Chrisyyyys/Robocup-Junoir-Theseus/README.md

# Robocup-Junoir-Theseus
Robocup junoir 2025
chacandnnaf
