Chrisyyyys/Robocup-Junoir-Theseus/docs/superpowers/specs/v3-checks/README.md

# V3 geometry and statics checks

These scripts produce every **[check]** number in [2026-10-06-theseus-v3-robot-design.md](../2026-10-06-theseus-v3-robot-design.md) and [2026-10-07-theseus-v3-mechanical-design.md](../2026-10-07-theseus-v3-mechanical-design.md) and draw the figures in [../v3-figures/](../v3-figures/). They are a model, not the robot: nothing here was measured on hardware, and all masses are placeholders.

```
pip install shapely numpy matplotlib
python run_all.py            # every check, raw output in results/*.txt (about 10 minutes)
python run_all.py terrain    # one check (names below)
python figures.py ../v3-figures
```

Run from this folder (the scripts read and write `pack_v3.json` here). Units are cm and degrees; x forward, y left, z up, origin at the axle midpoint on the floor line.

## What each check answers

| Check (`run_all.py` name) | Script | Spec section | Result it supports |
|---|---|---|---|
| `terrain` | `nubtable.py`, `sidesim2.py`, `sidesim.py` | 4 | Side-view crossing of a 2 cm riser, two 1 cm steps, 25 degree ramp, bumps, seam, three-step stairs and the Dangerous Zone bump on a ramp; nub-height table; the first-draft and belly-only variants |
| `omni_travel` | `more_checks.py travel` | 4 | Omni travel 2.5 versus 3.0 cm changes nothing for the required cases |
| `silver_module`, `front_floor_port` | `more_checks.py axle`, `fsens.py` | 5 | Clearance of the two floor-sensor positions on every terrain case |
| `ramp_foot` | `tofcone.py` | 5 | What a front ToF reads at the foot of a 25 degree ramp at heights 6.5, 8.1, 10.0 (first lines also trace the old layout) |
| `plate_variants`, `plate_tolerance` | `variants.py`, `platesim.py`, `platesim2.py`, `platetol.py` | 7 | All 128 drop sequences (0 violations), wall and parked margin for each pocket size and ring radius, positioning tolerance; `plate_tolerance` is run for the rev 4 numbers (13 mm pockets, 17 mm slot, 9 Oct: parked margin 1.92 mm, wall 4.06 mm, 128 cases with 0 violations; 8 Oct, 14 mm and 16 mm: 1.74 mm). The kit's own width limits the parking error to (slot - pocket) / 2 = 2.0 mm, and the simulation gives 1.5 mm: `chute_dynamics` |
| `kit_landing` | `kit_final.py` | 7 | Chute slope, exit speed, landing point, kit-to-victim distance |
| `bumper_and_chute_exit` | `geom_checks.py` | 6, 7 | Bumper end angle against the other parts and the corridor wall; chute exit x against the wheel |
| `packing` | `final_pack2.py`, `com.py`, `layout.py`, `place2.py`, `chamfer_pack.py` | 9 | Controller stack and battery placement against all fixed parts, the cameras and the rear chamfer; centre of mass |
| `tof_cones` | `tof_check2.py` | 5 | All nine 25 degree cones traced against the robot's own parts |
| `controller_fit`, `controller_fit_with_battery` (slow, run only when named) | `fit_stack_only.py`, `fit_R.py` | 0.2, 0.5 (D1), 9 | Which controller stack heights fit at R 9.5, 10.0, 10.5 with the wheel track, motors, chute exit and camera re-fitted for each radius; what small main board plus battery fits at 9.5 |
| `camera_beside_wheel`, `camera_recess`, `camera_view` | `beside.py` + `place.py`, `cam_recess.py`, `camview.py` | 8 | No placement beside the wheel; the recessed lens fits; what the lens sees of the wall |
| `statics` | `statics.py` | 4 | Friction needed to climb a step, omni push, motor torque, ramp statics, spring rate (edit `x_com`, `h_com` to try other centres of mass) |
| `figures` | `figures.py`, `v3_params.py` | 14 | The six figures; every dimension in them comes from `v3_params.py` and the simulator |

### Mechanical design (2026-10-07)

These back the numbers in [2026-10-07-theseus-v3-mechanical-design.md](../2026-10-07-theseus-v3-mechanical-design.md) (the structure, mounting and usability review). Results are in `results/`.

| Check (`run_all.py` name) | Script | Spec section | Result it supports |
|---|---|---|---|
| `omni_inside` (slow, run only when named, about 3 minutes) | `omni_inside.py` (uses `sidesim2.py`, `nubtable.py`) | 4 | All nine required terrain cases with the omni centre at 7.95 (rev 3), 7.3, 7.0 and 6.5 cm and the chute lip at z 2.67; the Dangerous Zone extras at 7.0 and 7.95 |
| `statics_omni_7` | `statics.py 7.0` | 4 | Front load, omni push, torque and the spring requirement with the omni 7.0 cm ahead (`statics.py` takes the omni distance as an argument, default 7.95) |
| `chute_exit` | `chute_exit.py` | 6.2 | Lowest point of a round chute, of the first 13 mm square one and of the final 19 mm one (22.2 mm outside, centred 1.5 mm above the axis; 8 Oct: 18 mm, 21.2 outside, the same floor) where it leaves the R 10.5 wall, and the exit axis height that keeps each at z 3.0 (z 4.15 for the 13 mm one, 4.35 for the 19 mm one; the design keeps z 4.15 and accepts 2.77) |
| `kit_landing_square` | `kit_final.py 4.15` | 6.2 | Exit speed, landing point and kit-to-victim distance with the exit axis at z 4.15 (`kit_final.py` takes the exit axis height as an argument, default 3.75) |
| `chute_dynamics` (not in `run_all.py`: needs MuJoCo, `pip install mujoco`; about 15 s quick, about 5 minutes full) | `chute_dynamics.py [quick\|full] [noplate] [bore in cm]` (uses `chute_geometry.py`) | 6.2 | Rigid-body simulation of a 10.3 mm kit starting in its plate pocket (the pocket's four walls are in the model, 0.3 mm above the floor; plate parked exactly, parked off along the ring, or turning onto the slot) and falling through the 17 mm slot B, the hopper and the 19 mm channel to the exit, on the geometry of the Fusion model, for friction 0.15 to 0.60, every kit with its own random turn (up to +-18 degrees, what the 13 mm pocket allows) and place in the pocket. Controls: textbook acceleration on a 32.2 degree plane, hold at mu 0.7, an 18.5 mm cube must not pass the slot. Full mode: sweeps of 1000 kits (plate parked exactly, up to 1 mm, 2 mm and 3 mm off, bouncy impacts with damping 0.3) and tables of the parking offset, the clearance under the plate, the plate's approach speed and the tolerance corners (10.5 mm kit, bore printed 18.6 mm, 6 g kit). **Result 9 Oct, final design (13 / 17 / 19 mm): PASS for the plate parked within 1.5 mm: 100.0 % with the plate exact, up to 1 mm off and with bouncy impacts, 99.9 % up to 2.0 mm (the allowance), 87.9 % up to 3.0 mm, 180 of 180 in each tolerance corner, 30 of 30 when the plate turns onto the slot at 60 degrees/s** (`results/chute_dynamics.txt`; the 8 Oct design (14 / 16 / 18 mm, PASS within 1 mm, 82.8 % up to 2 mm): `chute_dynamics_8oct_14_16_18.txt`; `noplate` is the first version's model: `chute_dynamics_no_plate.txt`; the first design (14.5 mm slot, 13 mm bore) FAILED, kits that arrive square to the slot jammed in the hopper mouth: `chute_dynamics_first_design.txt`, with a 14.7 mm bore `chute_dynamics_first_design_bore147.txt`). Friction, kit mass and impact softness are assumptions: the chute bench test decides |
| `cube_slot` | `cube_slot.py` | 6.2 | Which attitudes of the 10.3 mm cube fit a square slot when it may turn about the vertical but not tip on the way: flat 10.3 mm, tipped onto an edge 14.57 mm, standing on a corner 16.25 mm (closed form); 17 mm takes every attitude (0.0 % left out), 16 mm leaves out 0.9 % of random attitudes (those within 4.5 degrees of a corner stand), 14.6 mm 21 % and the first design's 14.5 mm 33 %: `results/cube_slot.txt` |
| `chute_geometry_check` (needs Fusion, three steps, see its docstring) | `chute_geometry_check.py` + `../v3-fusion/chute_samples.py` | 6.2 | The convex-piece model of the hopper, channel and slot used by `chute_dynamics` against the Fusion bodies of the 9 Oct design: 0 of 7000 random points differ (1 more within 0.2 mm of a surface is ignored), none of 8000 points 0.3 mm either side of the faces is on the wrong side (8 Oct: 1 of 8000, 0.01 %; the exit trim and the rim of the dropper floor are cylinders in Fusion and fans of planes here): `results/chute_geometry.txt` |
| `stepper_bay` | `stepper_bay.py` | 6.3 | Orientations of a 28BYJ-48 under the dropper floor that clear the GIGA stack, battery and hoppers (shaft 8 mm off the body centre) |
| `mount_check` | `mount_check.py` | 5.1, 8 | Where the six GIGA mounting holes land in each of four orientations (usable with a single omni arm), USB-C space, ToF cable runs (from the positions of `v3_params4.TOF`), motor snap-prong and face-plate numbers, cube slack in the 17 mm slot and the 19 mm bore (face and space diagonal; 0.81 mm over a 10.5 mm kit's) |
| `ring_gaps` | `ring_gaps.py` (uses `tof_mount.py`) | 3.1, 7.1 | Room on the ring between the nine ToF pockets and the two camera windows for the six frame screws and the four lid hooks (free angular ranges and the margin of each as built) |
| `structure_figs` | `structure_figs.py` (uses `tof_mount.py`, `v3_params4.py`) | 3, 5, 8 | Figures 7 (side section), 8 (motor cradle) and 9 (plan of every attachment point; the ToF pockets, camera cages and the IMU from the model's own numbers) |
| `sensor_figs` | `sensor_figs.py` (uses `tof_mount.py`, `v3_params4.py`) | 8.3, 8.4 | Figures 10 (the ToF board, its pocket and posts, and the nine pockets in the ring) and 11 (the OpenMV camera: blue = read from the drawing, orange = estimated, and the six measurements to take) |
| `tof_mount` | `tof_mount.py` | 8.3 | The standing 25.4 mm ToF board and its pocket, block, posts, pilots, screwdriver holes, plug shaft and beam tunnel in the board's own frame (pure Python so that the Fusion builders can import it; shapely only for the polygons); `python tof_mount.py` prints the layout and the pocket corner radii (limit 10.25) |
| unit tests (not in `run_all.py`) | `test_v3_params4.py` | all | The 91 tests of the numbers of the rev 4 model (chute, plate, ToF mounts, camera cages, IMU, lid, mass, clearances, and since 9 Oct the omni layout and mount: pillar, ear, corridor and opening, axle stack, pivot, stop slot, spring clearances, antenna place; since 10 Oct the spring's forward leg on its seat pin, the arbor, the adjuster bolt in its insert, the wound spring, and the arm's cut file against the model, with a mutation check that they fail when the file differs): `PYTHONPATH=... python -m unittest test_v3_params4` (about 10 s) |
| `fsens_front` | `fsens_front.py` (uses `fsens.py`, `omni_terrain9.py`, `sidesim2.py`, `nubtable.py`; the 9 Oct omni layout since that date) | 5.3 | Smallest clearance between a floor-sensor window and the terrain over each crossing, with the sensors 0 to 8.5 cm ahead of the axle (the silver module and front port now sit at 7.5) |
| `handle_calc` | `handle_calc.py` | 3.2, 7.2 | The front bridge as a cantilever under the handle post (stress and deflection at 15 and 45 N) and the nose-up angle when carried by different points of the bar |
| `axle_shift` (about 4 minutes) | `axle_shift.py` (uses `omni_mount.py`, `sidesim2.py`, `nubtable.py`; the 9 Oct omni layout since that date) | 4 | The terrain cases with the drive axle 0, 1, 2 and 3 cm behind the body centre: why the axle stays at the centre |
| `omni_mount` | `omni_mount.py` (uses `v3_params4.py`) | 4 | How the front omni wheel is mounted (9 Oct): the layout with the real 25.6 mm Nexus 14145 against the 8 Oct one (front rim to the wall, wheel to the GIGA post H1, arm angles), the pivot against the belly line, the neighbours (floor-port wall, battery tray, motor, pillar, antenna), the fixed M3 stop screw and the arc slot in the arm, the torsion spring for the front-lift statics of the 9 Oct model (rate, turns, stress as a share of the wire's strength, adjuster, fallback compression spring), the free-body loads of the arm, tube and stop screw at full travel and in a 2.5 times impact, and the statics (step push, torque, ramp). The masses and centre of mass are from `balance.py --repo`. Since 10 Oct also the forward leg, its seat pin and the arbor (smallest clearances to the stop screw and the wheel's rim over the travel, the loads on the pin) and the numbers of the spring order sheet (`sheet_numbers`: free angle, torques at rest and full travel, coil diameter under load) |
| `omni_figs` | `omni_figs.py` (uses `v3_params4.py`) | 4 | Figure 12: the omni mount in a side view through the arm, a front view through the axle, a section through the pivot, the arm with its arc slot and seat hole, and the parts list (updated 10 Oct for the legs, pin, arbor and adjuster bolt) |
| `omni_arm` | `omni_arm.py` (uses `v3_params4.py`) | 4.2, 4.8 | The omni arm as a part to make (10 Oct): the profile in the arm's own frame written as a DXF cut file (`../v3-figures/omni_arm.dxf`, R12, millimetres, lines, arcs and circles only) and drawn as Figure 13 with its feature table, tolerances and the way to file the ride height; prints the mass (4.9 g), the edge distances and the slot ends. Needs matplotlib |
| `omni_spring_sheet` | `omni_spring_sheet.py` (uses `omni_mount.py`, `v3_params4.py`) | 4.3 | The omni spring as it would be ordered (10 Oct): Figure 14, an axial view and a top view of the free spring with its legs, the working direction, the handedness and a table of wire, coil, free angle, torques, stress, quantity and mounting; prints the numbers. Needs matplotlib |
| `omni_terrain9` (slow, run only when named, about 4 minutes) | `omni_terrain9.py` (uses `omni_mount.py`, `sidesim2.py`, `nubtable.py`) | 4 | The nine required terrain cases and the Dangerous Zone extras for the 9 Oct omni layout (rest axle 6.85, pivot (2.409, 4.2), arm 4.6) next to the 8 Oct one: all nine required cases pass; the 30 degree stairs up have 0.20 cm (no margin); the 2 cm bump on a 25 degree ramp fails as before |

## How the model works

- **Plan and height:** parts are shapely polygons with a z interval (round parts are cut into slabs); collisions are tested per 0.25 cm height band with a 1.5 mm margin. The packing is a seeded random search over two boxes (battery, GIGA R1 + main PCB stack), so it repeats exactly.
- **Side view:** for every drive-wheel position along the terrain, the omni may be compressed by any amount from 0 to its travel; the body pitch follows from the omni touching the terrain; a pose is feasible if the rear support does not penetrate. The reported clearances use the smallest feasible compression (a stiff spring, the worst case). Parts: belly line with the rear chamfer, bumper bottom edge, chute nose, rear nub, omni on its arm.
- **ToF cones:** 25 degree full angle, traced as 5 x 5 rays to 30 cm against every part except the ToF boards.
- **Plate:** exposure of the kit footprint over each slot, for every state (kits used from each end, side, one or two kits, parked and during each sweep).

## Limits to keep in mind

- The side view is 2D at y = 0 with projected parts: no roll, no wheel slip, no dynamics, rigid wheels. Terrain polygons end at x = 45 to 90 cm, so pitch minima for the "up" cases and maxima for the "down" cases near that end are artefacts; only the clearances and the maximum tilt in the direction of the crossing are used in the spec.
- The packing has no PCB layout, cable or connector clearances; battery size and all masses are placeholders.
- The camera, chute and kit numbers assume a friction coefficient of 0.35 and a lens model from the OpenMV listing, not measurements.

## Fixed during the audit

- `sidesim2.mirror_profile` started descending profiles at x = 0 instead of x = -60, so the terrain behind the robot was a 20 degree slope; the "descending steps" rows were wrong until it was fixed (two 1 cm steps down: belly 1.50, bumper 3.24, chute nose 1.00 cm).
- The first packing put a small board under the rear chamfer (the packing model had a flat belly); `chamfer_pack.chamfer_gap` is now a constraint in `final_pack2.py` and `cam_recess.py`.
- The 14 mm pocket on a 33 mm ring in the approved draft gives 0.0 mm walls; see `plate_variants`.
