Chrisyyyys/Robocup-Junoir-Theseus/docs/superpowers/specs/2026-10-07-theseus-v3-mechanical-design.md

# Theseus V3: mechanical structure, mounting and usability (revision 4)

Status: **design confirmed by you (7 Oct: D10 N20, D12 controls on the front deck of the frame, the lift-out dropper unit, the axle at the body centre; 8 Oct: D15 short handle bar and D19 victim LED on the bar, by taking my recommendation); the layout model was rebuilt to match it** ([v3-fusion/](v3-fusion/README.md), `Theseus_V3_rev4.f3d`) and checked in Fusion (probes, interference, envelope, belly line, removal paths, access from above, ToF cones, camera views, omni sweep, spec clearances, mass; raw output in `v3-fusion/results/`). **Revised on 9 Oct** on your instruction to pick the chute numbers for reliability and to finish the sensor mounts: the plate pockets, slot and channel are bigger (D21, D22), the ToF boards and the camera boards have their real dimensions and mounts, and the frame, lid, camera cages, front floor port and IMU follow (rows 20 to 23 of section 0); the Fusion model was rebuilt and every check run again. **A fifth round (also 9 Oct)** designed how the omni wheel is mounted, with the real wheel (Nexus 14145, 60 x 25.6 mm, 73 g): section 4 and [Figure 12](v3-figures/fig12_omni_mount.png), rows 24 and 25 of section 0; the Fusion model was rebuilt once more and every check run again, and [what is still to be detailed](2026-10-09-theseus-v3-detail-design-backlog.md) is listed in its own file. **A sixth round (10 Oct)** made the omni arm and spring orderable: the arm has a drawing and a cut file ([Figure 13](v3-figures/fig13_omni_arm.png)), the spring an order sheet ([Figure 14](v3-figures/fig14_omni_spring.png)), and the model got what the sheet needed, the spring's forward leg on a pin in the arm, its arbor and the adjuster's insert (sections 4.2 to 4.4 and 4.8, row 26); the Fusion model was rebuilt and every check run again. Nothing here is measured or printed. Numbers carry a tag: **[calc]** my arithmetic or an emulator run (`balance` and `wire_runs` are scripts in [v3-fusion/dryrun](v3-fusion/dryrun/README.md), `access` and `removal` reports of the rebuild plan, output in `dryrun/results/dryrun_full.txt`), **[check]** a script in [v3-checks/](v3-checks/README.md) (named; raw output in `v3-checks/results/`), **[src]** a vendor page or datasheet, **[proposal]** a design choice made here, **[measure]** to be measured on the real part, **[estimate]** read from a photo or inferred, to be measured, **[placeholder]** a guess.

This document extends [the rev 3 spec](2026-10-06-theseus-v3-robot-design.md), which stays the source for everything not changed here. It answers the review of the first Fusion model: chute and plate, dropper support, lid and electronics access, mounting holes and attachments, the omni position, clip-on motors, and the feasibility and usability of all of it. A second round (rows 16 to 18 of section 0, with the controls in row 7) rechecked the weight balance and the axle position, made the electronics reachable without taking the robot apart, moved the controls to the front and moved the floor sensors forward; a third item (row 19) uses the GIGA's built-in Wi-Fi for cable-free testing; a fourth round (9 Oct, rows 20 to 23) chose the chute numbers for reliability and finished the mounts of the ToF boards, the cameras, the front floor port and the IMU with their real dimensions; a fifth round (9 Oct, rows 24 and 25) mounted the real omni wheel and listed what is still to be detailed; a sixth (10 Oct, row 26) made the arm and the spring orderable. The rebuild plan was dry-run on a geometry emulator before any Fusion call ([v3-fusion/dryrun](v3-fusion/dryrun/README.md)); what it found is in row 15. Where this file disagrees with rev 3 sections 4 (omni), 7 (chutes, dropper motor) or 9 (electronics mounting), this file wins.

Figures: [7 side section](v3-figures/fig7_structure.png), [8 motor cradle](v3-figures/fig8_motor_clip.png), [9 plan of every attachment point](v3-figures/fig9_mounting.png), [10 the ToF board and its mount](v3-figures/fig10_tof_mount.png), [11 the OpenMV camera: what is known and what to measure](v3-figures/fig11_camera_measure.png), [12 the omni mount](v3-figures/fig12_omni_mount.png), [13 the omni arm to make](v3-figures/fig13_omni_arm.png), [14 the omni spring to order](v3-figures/fig14_omni_spring.png).

## 0. What changes

| # | Item | Rev 3 and the first Fusion model | Rev 4 | Evidence |
|---|---|---|---|---|
| 1 | Front omni | centre x 7.95, front edge 10.95 (outside the body), two arm plates, slot in the front wall | centre **7.0**, front edge **10.0** (wall inner face 10.3; with the real wheel since 9 Oct **6.85** and **9.85**, row 24), **one arm on the +y side**, no slot | all nine required terrain cases still pass; the GIGA's front-inner mounting hole sits in a two-plate arm swing **[check]** `omni_inside`, `mount_check` |
| 2 | Dropper floor | attached to nothing | its own print, the base of a **lift-out dropper unit** (floor disc, plate, kits, N20 cartridge, both hoppers); it rests on three half-lap seats in the web of the **upper frame**'s front bridge and rear spoke | model review; second round, section 3.3 |
| 3 | Chute | 15 mm round bore, mouth 0.75 cm under the floor | **17 mm slot and hopper void sealed to the floor underside**, **19 mm square channel**, open as a trough under the slot, exit axis z 4.15 (redesigned 8 Oct after a kit simulation; numbers raised on 9 Oct for reliability, row 20 and section 6.2) | a 10.3 mm cube passes the 17 mm slot lying at any turn (2.43 mm over its face diagonal) and tipped any way, standing on a corner included (16.25 mm), and the 19 mm bore with 1.16 mm to spare over its space diagonal (0.81 mm for a 10.5 mm kit); the plate may be parked 2.0 mm off (all kits out up to 1.5 mm in the simulation); lowest point z 2.77 **[check]** `chute_exit`, `mount_check`, `cube_slot`, `chute_dynamics` |
| 4 | Dropper motor and the "pillar" | N20 hanging under the floor | N20 stays (rev 3) as a **cartridge dropped in from above**; it hangs from the floor and carries nothing. The **space for a 28BYJ-48 is kept**: it fits when turned so its body sits 8 mm from the plate axis, toward the front-left | **[check]** `stepper_bay`. Rev 3 section 7 called it "too large"; a body centred on the plate axis is, but its shaft is 8 mm off centre |
| 5 | Lid | plate on the rim, blocked by the handle arch | **snap-on lid**, four hook tongues, lifts straight up | requested |
| 6 | Handle | arch on the chassis | **T-handle**: post on the front bridge, a 5.4 cm bar along x (x 3.3 to 8.7) through a slot in the lid | the arch blocked the lid; the bar stops in front of the dropper unit so that the unit can lift out (D15) |
| 7 | Start button, victim LED, power switch | start button and LED on the lid (rev 3 section 7) | on a **control deck** on the front bridge: switch and start button on its +y side, two status LEDs on the bridge rib, all through a notch and the handle slot in the lid; the **victim LED on top of the handle bar's front end**; USB-C service socket in the **front-right wall** | a lid with wires cannot simply lift off; at the front the wires to the PCB are 5 to 8 cm instead of 21 to 25 cm (12 cm for the LED on the bar) **[calc]** `wire_runs`; the rules want the victim LED clearly visible to the referee, section 7.3. Alternative in D12 and D19 |
| 8 | Drive motors | cylinder in a floor slot | **cartridge** (face plate fixed once with 2 x M2.5) in a **snap cradle** made of two thin prongs and a key | friction alone gives at most 0.16 kg.cm; a 2 cm riser needs 1.63 **[check]** `mount_check` |
| 9 | Wheels | solid cylinders | hub on the D-shaft with a set screw; **wheel arches** in the lower wall | usability, section 5.2 |
| 10 | GIGA | positions only | connector edge to the front, header edge inboard, **4 printed posts** on the datasheet holes | **[check]** `mount_check` |
| 11 | ToF boards and cables | positions only | the real Adafruit 3317 board (25.4 x 17.8 mm) **stands on its short end** in a pocket of the ring on two M2.5 screws, its lower connector plugged down through the floor; **200 mm cables** (9 Oct, row 21 and section 8.3) | **[check]** `mount_check`, `tof_mount` |
| 12 | Bumpers | rev 3 section 6 | unchanged | section 9 |
| 13 | From the 3D layout model | ToF positions, camera window, chute nose, omni stop | adopted: side and rear ToF moved inward, camera window 2.8 x 2.4 cm, omni stop 2.5 cm | [v3-fusion README](v3-fusion/README.md) findings 1 to 4 |
| 14 | Print rule | none | every snap part flexes **in the layer plane** | section 10 |
| 15 | From a dry run of the rebuild plan (7 Oct) | wall strip above each wheel arch at z 8.3 to 8.7; rear frame screws at +-101 degrees; drive motors "lift out"; ToF pockets closed by a 1 mm skin; USB-C socket 2 mm proud of the wall; handle bar x 0 to 8; control deck 4.8 cm wide | the strip is **notched 3 cm at the camera window**; the rear screws move to **+-118 degrees**, each boss with a rib to the wall; the battery (left) or the GIGA stack (right) comes out before a drive motor; the ToF pockets are open at the top; the socket is flush; the bar starts at x 3.3; the deck is on the +y side only | the strip sat in the middle of the camera's field of view, and a boss at 101 hung on the tyre's top rim; a straight lift of either cartridge hits the part above it; a bar over the plate stops the dropper unit lifting out; a deck over the GIGA's connector edge would cover its reset and boot buttons **[calc]** (3D checks on the emulator), sections 3.3, 5.2, 7 |
| 16 | Weight balance and axle position (second round) | axle at the body centre; no balance recheck after the extra printed mass | **axle stays at the body centre.** With the controls at the front the centre of mass is **1.09 cm ahead of the axle, 6.79 cm high** (the 9 Oct model with the real omni module, 1287 g), front load 15.9 %, front lift-off at **1.58 m/s^2** | a 1 cm shift back adds 7.7 points of front load (9 % less weight on the driven wheels for the stair climb) and 1 cm of swept radius (11.98 against a worst-case corridor half-width of 12.6) for a lift limit that is already above the 1.0 m/s^2 ramp **[calc, placeholder masses]** `balance`, **[check]** `axle_shift`. Section 4, axle position |
| 17 | Access to the electronics (second round) | lid off shows the front 4.5 cm of the stack; everything else needs the frame off | plate, kits, N20, floor and hoppers **lift out as one unit**; with the lid and the unit off 84 % of the GIGA, 86 % of the shield and 80 % of the battery are open from above (the battery was 91 % until the camera boards and cages came to cover its outboard strip; 80 % is the limit of the check). USB-C reflash with the lid on | **[calc]** `access` report on the dry run; sections 3.3, 7.4 |
| 18 | Floor sensors (second round) | FP (6.5, 3.0), SM (0, 0) | **FP (7.5, 3.5; 3.2 until the real omni wheel, row 24), SM (7.5, -2.7)**, one each side of the omni bay: the silver tile is seen 7.5 cm of travel (about 250 ms at 0.3 m/s) earlier | terrain clearance of the windows at least 1.3 cm on the required cases, 0.5 cm on the 30 degree stairs **[check]** `fsens_front`; firmware threshold changes, section 5.3; the real size of FP: row 23 |
| 19 | Wi-Fi and Bluetooth for cable-free testing (third round) | not considered | the **GIGA's built-in module** is used in a **test mode** only (log streaming and test commands); its flat antenna, which ships with the board, is stuck on the inside of the tub's right front wall at -22 degrees (-6 until the aluminium omni wheel, row 24); flashing stays on the USB-C socket; the radio is never started in a run | the board has no on-board antenna, only the u.FL socket J14; rules 4.1.1 forbid passing information to the robot wirelessly during a run **[src]** datasheet ABX00063, rules; section 8.5 |
| 20 | Chute numbers chosen for reliability (fourth round, 9 Oct) | 14 mm pockets, 16 mm slot and hopper void, 18 mm bore: the plate had to park within 1 mm, and the bore had 0.16 mm to spare over the kit's space diagonal | **13 mm pockets, 17 mm slot and hopper void, 19 mm bore** (D21, D22): the plate may be parked 2.0 mm off, a kit standing on a corner still passes the slot, and a 10.5 mm kit still has 0.81 mm in the bore | picked on reliability alone, as you asked; the price is 0.5 mm of the gap from chute to wheel (5.12 mm, limit 5.0) and 0.5 mm of hopper wall **[check]** `chute_dynamics`: 100 % of 1000 kits out with the plate parked exactly, up to 1 mm off, with bouncy impacts and in four tolerance corners, 100 of 100 at 1.5 mm, 99.9 % of 1000 up to 2.0 mm; `plate_tolerance`, `cube_slot`; Fusion `kit_path` |
| 21 | ToF boards: real size, standing in the ring (9 Oct) | pockets for a 21 x 18 mm board dropped in from above (the product page's size) | the board is **25.4 x 17.8 mm** (its EAGLE file), 4 mm longer than modelled; lying down it did not fit the ring (pockets overlapped, corners left the body), so it **stands on its short end** on two printed posts and two M2.5 screws, the lower connector's plug going down through the floor; the ring is **5 mm taller (top z 11.7)** and the lid 11.7 to 12.0; FL and FR moved 1 mm and 1 degree, the side boards from x +-7.18 to +-6.85, the rear boards from y +-4.5 to +-3.6 | **[src]** Adafruit EAGLE file; **[check]** `tof_mount`, `ring_gaps`; Fusion: all nine cones free (0 of 17 rays blocked each), no pocket within 3 mm of another, pocket corners inside r 10.25 (unit test) and every part inside r 10.5 (envelope report) |
| 22 | OpenMV cameras: real board, cage, lid hump (9 Oct) | slide-in cradle sized from the product page: a 45 x 36 mm board and rev 3's estimated 2.3 x 2.0 x 2.0 cm lens block | the board is **44.45 x 35.56 x 1.6 mm with four holes** (OpenMV's dimension drawing, +-0.5 mm); the **lens axis, the holder and the lens height are estimates from the product photo** (Figure 11 lists the six caliper measurements); the board hangs on a printed **cage** (four M2.5 screws into its frame, two ears with M3 screws into inserts in the ring), under a **lid hump** (outer top z 12.5, ceiling 12.3) | **[src]** openmv.io drawing; **[estimate]** the lens block; Fusion: board to the hump ceiling 2.9 mm, cage to the lid 2.1 mm, to the wheel top 7.2 and 10.0 mm, 0 of 25 view rays blocked |
| 23 | Front floor port and IMU (9 Oct) | FP a 16 mm placeholder; the IMU not placed | FP is the **20.3 mm TCS34725 board** (EAGLE file; its holder is **not designed yet**, section 5.3); the **BNO055 IMU** (27 x 20 mm) sits on four 5 mm posts in the tub at (-5.0, 0), header edge forward, run in IMU mode (section 8.6) | **[src]** Adafruit EAGLE file and product page 2472; Fusion: FP to the omni arm 5.1 mm (6.9 mm before the 9 Oct omni mount), IMU to the N20 11.5 mm and to hopper A 25.6 mm |
| 24 | Omni wheel and its mounting (fifth round, 9 Oct) | the 8 Oct layout: a placeholder 20 mm wide, 30 g wheel, a 4 mm printed arm plate on a 4 mm pin between two ears, arc-slot stops, pivot z 3.6, axle x 7.0; FP at y 3.2, antenna at -6 degrees | the real **Nexus 14145** (60 x 25.6 mm, 73 g) on two 604 bearings and an M4 axle screw, **one 3 x 12 mm aluminium arm** that turns on a tube on an M3 pivot screw between a printed pillar and ear, a **torsion spring** (484 N.mm/rad, 2.4 N preload, 8.5 N at 2.5 cm) with an adjuster screw, a **fixed M3 stop screw in an arc slot of the arm**; pivot z 4.2, axle x 6.85, wheel 3 mm left of centre, FP at y 3.5, antenna at -22 degrees on the bumper recess wall (D27 to D29) | **[check]** `omni_mount`, `omni_terrain9` (all nine required cases pass; the 30 degree stairs up have 0.20 cm: no margin; the Dangerous Zone bump on a ramp still fails, D8); the emulator found four faults before any Fusion call (the axle head, the pivot screw head, the first antenna place, the wheel's removal path), each now a unit test; Fusion: 57 components without an overlap, omni sweep free, seven removal paths free, 29 clearances, mass 1287 g, centre of mass 1.09 cm ahead of the axle and 6.79 cm high, front load 15.9 %, lift limit 1.58 m/s^2 |
| 25 | What is still to be detailed (fifth round) | open items spread over the text (**not designed**, **[placeholder]**, **[estimate]**, **[measure]**) | **one list in priority order**: 13 omni details, 19 parts without a holder or a geometry, 11 measurements and purchases, 7 electronics and firmware changes, the bench tests and a suggested order ([backlog](2026-10-09-theseus-v3-detail-design-backlog.md)) | built from the flags of this file, the open list of section 13 and what the omni work turned up |
| 26 | Omni arm and spring made orderable (sixth round, 10 Oct) | the 9 Oct sketch: a forward spring leg 'hooked on the arm's top edge' (not modelled), a rear leg bent 90 degrees to reach its adjuster, the coil hanging on the 5 mm tube, a 5.0 mm bore for the 5.0 mm tube, the stop screw's wear left as a note | the **arm has a drawing and a DXF** (Figure 13: bore 5.05 reamed, M4 tapped, the arc slot, a 2 mm seat hole, tolerances, how to file the ride height); the **spring has an order sheet** (Figure 14: right-hand, 4.07 turns, straight tangent legs, 203.6 degrees free, 8.6 N.mm per degree, the load **opens** the coil); the **forward leg lies along the arm, 4 degrees up from it, on a 2 mm pin in the arm** (the coil ends 0.7 mm short of the arm, so the leg could not touch the bar itself), the **rear leg is straight** on an **M3 x 6 adjuster bolt in an insert** (the tail is widened to y 1.2), the coil sits on a **printed 7.4 mm arbor**; the stop screw keeps its threads (wear estimated, a sleeve is optional) | **[check]** `omni_arm`, `omni_spring_sheet`, `omni_mount` (leg over the stop screw 1.07 mm, pin to the rim 4.2 mm, 1.0 mm of bar over the pin); the emulator and Fusion agree: 57 components (193 bodies) without an overlap, the omni sweep free with the leg and pin turning with the arm, seven removal paths free, 29 clearances and six new leg pairs above their limits, mass 1287 g; 91 unit tests |

## 1. What was asked and where it is answered

| Request (7 Oct) | Answer | Section |
|---|---|---|
| Chute connected to the underside of the plate floor, no gap | hopper sealed to the floor, square channel | 6.2 |
| Chutes support the plate so the "pillar" can go, and leave room for the stepper | the pillar was the N20 hanging under the floor, and the floor itself was unattached. Now the floor is part of the frame and rests on the bridge and spoke; the chutes steady it sideways but do not carry it (they plug into the wall, so they could not carry a floor that lifts off with the frame). The N20 carries nothing. The stepper bay is kept free and a 28BYJ-48 fits | 3.2, 6.1, 6.3 |
| Lid easily removable for kit refill and electronics checks | snap lid, wire-free, T-handle, control deck on the front bridge; what is visible with the lid off | 7 |
| Mounting holes and how each part is placed and attached | component table, GIGA hole check, plan figure | 3.1, 8, Figure 9 |
| Omni not in front of the bumper or outside the body | moved inside, terrain re-checked | 4 |
| Motors clipped on like a bike bottle cage | cartridge and snap cradle, with the key it needs | 5.1 |
| Detail, feasibility and usability of everything | per-section notes, service table, risk table, test plan | 3.3, 10, 11, 12 |
| Second round: is 2WD sound for a navigation robot in general? | yes, with the 2 cm step as the one real risk; the evidence is in the [pre-Fusion report](2026-10-07-theseus-v3-pre-fusion-report.md) | 11, report |
| Second round: check the weight balance again; could the drive wheels move back? | recomputed with the final masses; the axle stays at the body centre | 4 |
| Second round: reach the electronics without taking much apart | the dropper floor, plate, kits, N20 and hoppers lift out as one unit; the battery and the GIGA stack are then 91 and 86 % open from above | 3.3, 6.1, 7.4 |
| Second round: buttons at the front so the wires do not cross the robot | control deck on the front bridge, USB-C socket in the front-right wall | 7.3 |
| Second round: colour sensor pair further forward | silver module and front port at x 7.5, one each side of the omni bay | 5.3 |
| Third round: Wi-Fi so that testing needs no cable | the GIGA already has Wi-Fi and Bluetooth; its antenna is placed on the front wall; the radio runs in a test mode only (rules 4.1.1) | 8.5 |
| Fourth round (9 Oct): pick the chute design for reliability; finish how the sensors are mounted; was the camera size confirmed, does it fit? | 13 / 17 / 19 mm pockets, slot and bore chosen for reliability; the ToF boards, cameras, front floor port and IMU redrawn with their real sizes and mounts. The camera board is confirmed from OpenMV's drawing, its lens block is **not** (an estimate; six measurements are listed in Figure 11); with the estimate it fits, 2.9 mm under the lid hump | 6.2, 8.3, 8.4, 8.6, Figures 10 and 11 |
| Fifth round (9 Oct): figure out how the omni wheel is mounted, and list what still needs detailed design | the real wheel found (Nexus 14145: 25.6 mm wide, 73 g, 12 mm hole) and the mount designed down to its screws, the spring, stop and loads calculated, the model rebuilt and checked; every open detail in one list in priority order ([backlog](2026-10-09-theseus-v3-detail-design-backlog.md)) | 4, 13, Figure 12 |
| Sixth round (10 Oct, 'continue' after the backlog): the items of the backlog that are mine to do, those with a lead time first | the omni arm drawn and given a cut file, the spring given an order sheet and its legs, seat pin and arbor designed, the stop screw's wear estimated, the model rebuilt and checked again | 4.2 to 4.4, 4.8, Figures 13 and 14 |

## 2. Assumptions and constraints

- **Printer:** bed size not measured; I assume a 220 x 220 mm class bed. The shell is 21.0 cm across, so the tub, the frame and the lid are each one print about 210 mm across. If the real bed is smaller they split along y = 0 (section 10). **[measure]**
- **Material:** PETG for everything that flexes and for the frame; PLA for rigid blocks. FDM tolerance about +-0.2 mm: sliding fits 0.2 to 0.3 mm clearance. **[proposal]**
- **Fasteners:** M3 heat-set inserts (5.7 mm long) in printed bosses at least 8 mm across, M3 screws for the frame and the camera cages, M2.5 x 6 for the motor face plates, the ToF boards, the camera boards and the IMU (self-tapping into 2.0 to 2.2 mm printed pilots). A 2.5 mm and a 2 mm hex key and a small wrench are the only tools. **[proposal]**
- **Masses:** rev 3 uses a placeholder 1.07 kg (`com.py`: printed chassis 150 g, lid plus handle 45 g, dropper plate and floor 30 g, chutes 15 g). A 21 cm PETG tub, ring frame, lid, handle and hoppers will weigh more, perhaps 0.2 to 0.3 kg extra **[placeholder: weigh the printed parts]**; the spring and screw loads below scale with the real mass. The rev 4 Fusion model sums to 1287 g with these placeholders and the real omni module (section 4).
- **Delegated on 7 Oct:** the omni arm, the dropper-motor question, the handle, the lid and the wheel arches were left to this review (D9 to D14, section 13). The print-bed size was left for you to measure.

Hardware facts used:

| Part | Fact | Source |
|---|---|---|
| Pololu 3493, 20Dx44L 195:1 | plain 20 mm cylinder; 4 mm D output shaft, 18 mm long; two threaded M2.5 holes in the gearbox face (3.5 mm maximum screw depth); stall 10 kg.cm at 1.6 A, gearbox limit 5 kg.cm. Occupies y 1.4 to 6.1 including the 3 mm encoder | **[src]** pololu.com/product/3493; rev 3 section 4 |
| Pololu 3499 encoder pair | soldered to the back of the motor, six pads at 2.54 mm; board outline not given | **[src]** pololu.com/product/3499; **[measure]** |
| Nexus 14145 omni wheel | 60 mm double aluminium omni: diameter 60 mm, **25.6 mm wide**, axle hole **12 mm**, **73 g**, 3 kg load, ten rollers (13 mm) on two plates; the mounting hub for a 4 mm shaft is a separate accessory; the depth and tolerance of the 12 mm hole are not given | **[src]** [nexus_14145.pdf](https://www.vstone.co.jp/products/nexusrobot/download/nexus_14145.pdf), read on 9 Oct; **[measure]** the hole |
| 604-2RS ball bearing | bore 4 mm, outer diameter 12 mm, width 4 mm (two per wheel) | catalogue size; the BOM lists bearings of 'size TBD' (4 in stock, 5 spare) **[measure]** |
| Arduino GIGA R1 WiFi | 101.6 x 53.34 mm; six 3.2 mm holes in the Mega 2560 pattern; USB-C (J12), USB-A, audio jack, reset (PB1) and boot (PB2) all on one short edge; the underside looks flat in the datasheet pictures (header solder tails are not drawn) | **[src]** datasheet ABX00063: page 18 (holes), page 9 (connector positions, read from the picture) |
| Adafruit VL53L0X board 3317 (July 2020 layout) | **25.4 x 17.78 mm** (PCB 1.6 mm assumed), R 2.54 mm corners; four 2.5 mm holes in 3.2 mm pads on a 12.7 x 20.32 mm rectangle; the VL53L0X in the middle of the front face (4.4 x 2.4 x 1.0 mm); two STEMMA QT connectors (6.1 x 4.25 mm, about 3 mm tall) at the two short ends, 0.58 mm in from the edge | **[src]** the board's EAGLE file `Adafruit VL530X STEMMA QT.brd` (github.com/adafruit/Adafruit-VL53L0X-ToF-Distance-Sensor-PCB), read on 9 Oct; the chip from ST's VL53L0X datasheet; the connector height from JST SM04B-SRSS-TB listings (2.9 to 2.95 mm); **[measure]** which version you own: an older board has another outline |
| OpenMV H7 Plus | board **44.45 x 35.56 mm** (1.6 mm assumed); four holes at the camera end (3.0 and 32.5 mm from the left edge at 3.1 mm from the camera end, 2.4 and 33.3 mm at 8.2 mm; drilled 2.8 and 3.05 mm); M12 lens mount, 29 mm overall depth. **Estimates:** lens axis 5 mm from the camera end and 17.8 mm from the left edge, holder 17.4 x 17.4 x 12 mm, barrel 12.5 mm | **[src]** openmv.io product page and its dimension drawing (+-0.5 mm), read on 9 Oct; **[estimate]** the lens block from the product photo; **[measure]** Figure 11 |
| Adafruit TCS34725 board 1334 | **20.32 x 20.32 mm**, two 2.5 mm holes 15.24 mm apart at the top edge (thickness 1.6 mm assumed) | **[src]** the board's EAGLE file `Adafruit TCS34725.brd` (github.com/adafruit/Adafruit-TCS34725-Color-Sensor-Breakout-PCB), read on 9 Oct |
| Adafruit BNO055 breakout 2472 | 20 x 27 mm, 4 mm with the header; four mounting holes 20 mm apart along the board and 12 mm across | **[src]** adafruit.com/product/2472; **[measure]** the hole positions on your board |
| 28BYJ-48 | body 28 mm across, 19 mm tall; two ears 35 mm apart (4.2 mm holes, R 3.5); shaft 5 mm with 3 mm flats and a 9 x 1.5 mm collar, tip 10 mm from the front face, and 8 mm **off the body centre** at right angles to the ear line; wire block 14.6 mm wide, reaching 17 mm from the body centre on the side opposite the shaft offset | **[src]** Kiatronics datasheet, drawing on page 1 |

## 3. Architecture

### 3.1 Parts and attachments

[Figure 7](v3-figures/fig7_structure.png) is the side section and [Figure 9](v3-figures/fig9_mounting.png) the plan. The robot is a **tub**, an **upper frame** and a **lid**; everything else is a module that plugs into them.

| Part | What it is | Print |
|---|---|---|
| Tub | floor 4 mm (z 3.5 to 3.9) and lower wall 2 mm up to z 8.7; motor cradles, GIGA posts, four IMU posts, battery tray, omni pillar, tail and outer ear (with the floor opening for the wheel and the arm's corridor), floor-sensor pockets, nub boss, bumper hinge sockets and switch pockets, wheel arches (the strip above each one notched at the camera window), chute holes, six insert bosses with ribs, USB-C socket hole in the front-right wall above the bumper band | floor down; supports under the rear chamfer and the arches |
| Upper frame | ring r 9.0 to 10.5, z 8.7 to 11.7 (nine ToF pockets open at the top, each with two screw posts, two screwdriver holes, a plug shaft through the floor and a beam tunnel; two camera windows with M3 insert holes for the cages; lid seat, hook grooves); front bridge (3 mm web, rib to the front ring) with the control deck on its +y side; rear spoke; three half-lap seats for the dropper floor; handle post | ring bottom (the z 8.7 plane) on the bed |
| Dropper unit | floor disc (R 5.11, 3 mm, slots A and B, N20 pocket), kit plate with the kits, N20 cartridge, two hoppers; **lifts out in one piece** (3.3) | floor and plate flat |
| Lid | 3 mm plate, camera humps, handle slot, front notch over the control deck, finger notches, four hook tongues | top down |
| Hopper and chute (two) | box under each slot (part of the dropper unit), 19 mm square channel to the wall, open as a trough under the slot | channel in two halves, flat (split not redrawn for the trough) |
| Modules | two drive cartridges, N20 cartridge, omni module, two bumper plates, nine ToF boards, two cameras with their printed cages, the IMU, battery, GIGA and shield | bought or printed |

| Component | Placed | Held by | Mounting holes known? | Tool |
|---|---|---|---|---|
| Drive motors | y 1.4 to 6.1, axle z 4.0 | cartridge: face plate on the gearbox, snap cradle in the floor (5.1) | two M2.5 face holes **[src]**, spacing **[measure]** | none on the robot |
| Wheels | y 7 to 9 | hub on the 4 mm D shaft, one M3 set screw | own design | hex key, from below through the arch |
| Omni | centre (6.85, 3.0), y -0.98 to 1.58 | the Nexus 14145 on two 604 bearings and an M4 axle screw tapped into **one** 3 x 12 mm aluminium arm; the arm turns on a tube on an M3 pivot screw (z 4.2) between a printed pillar and a printed outer ear; torsion spring (its forward leg on a pin in the arm) with an M3 adjuster bolt; a fixed M3 stop screw through an arc slot in the arm (section 4, Figures 12 to 14) | the wheel's 12 mm hole **[measure]**; the mount is own design | 2.5 and 3 mm hex keys (a 3 mm ball-end key for the axle) |
| Rear nub | x -8.0 | M5 thread in a boss under the chamfer, jam nut | own design | wrench |
| Floor sensors FP and SM | FP (7.5, +3.5), SM (7.5, -2.7), faces z 2.8, one each side of the omni bay (5.3) | snap pockets in the floor, cables up; **the holders are not designed yet** (FP is the 20.3 mm TCS34725 board) | FP: two 2.5 mm holes 15.24 mm apart **[src]**; SM: modules not chosen **[measure]** | none |
| Bumpers | 12 to 58 degrees | hinge pin in a wall socket at the outer end, return spring, microswitch in a pocket at 14 degrees (rev 3 section 6) | switch part not chosen **[measure]** | hex key |
| GIGA R1 | stack at (2.32, -4.03), z 6.15 to 8.05, connector edge forward | four printed posts with M3 inserts | **yes**, six holes, four used **[src]** | hex key |
| Main PCB shield | on the GIGA | plugs into the GIGA headers; its outline starts about 20 mm from the connector edge | designed later | none |
| Battery | (3.9, 4.35), 10 degrees | tray with a notch over the left motor, velcro strap, front stop | no holes | none |
| Dropper floor | R 5.11, 3 mm, z 8.7 to 9.0, centre (-2.0, 0) | three tabs (the top half of the thickness) lie in rebates of the web's top half, on the web's lower half: two beside the bridge rib (x 3.0 to 3.9, y +-0.85 to +-1.25, clear of the handle post), one on the spoke web (x -7.5 to -6.9); two snap tabs or thumbscrews hold it down **[proposal, not drawn]**; lifts out with plate, kits, N20 and hoppers | own design | none (or a hex key for thumbscrews) |
| N20 | (-2.0, 0) | cartridge in the dropper floor's pocket, two snap tabs | face holes **[measure]** | none |
| Kit plate | R 4.91, z 9.0 to 10.2 | friction on the D-shaft plus an M2 set screw; rests on the dropper floor | own design | lift off |
| Hoppers, chutes | slots at (-4.73, +-2.73) | hopper snapped under the dropper floor; channel plugged in from outside through the wall | own design | none |
| Upper frame | z 8.7 and up | six M3 x 35 screws from the ring top (heads 3 mm below the top, under the lid; 5 mm longer than in rev 3 because the ring is 5 mm taller, with the insert holes 8 mm deep instead of the model's 6 so that the screw tip has room **[proposal]**) into inserts in tub bosses (each with a rib to the wall), at +-12, +-60 and +-118 degrees **[check]** `ring_gaps` | own design | hex key |
| ToF boards (9) | in the ring, standing on the short end, z 9.01 to 11.55, beam at z 10.28 | two M2.5 x 6 self-tapping screws from behind into two printed posts (5.2 mm square) in a pocket open at the top; the plug of the lower connector goes down through a shaft in the floor | four 2.5 mm holes on 12.7 x 20.32 mm **[src]** | 2 mm hex key through two 5 mm holes in the pocket's rear wall |
| Cameras (2) | lens tips at +-88 degrees, r 8.8, z 9.3, board tilted 20 degrees, tail toward +x | board on a printed cage: four M2.5 x 6 from the back into the cage frame; the cage is held by two M3 screws along y through its ears into inserts in the ring | four holes +-0.5 mm **[src]** (drawing); lens block **[estimate]** | 2 mm and 2.5 mm hex keys |
| Lid | on the ring | four hook tongues (7.1) | own design | none |
| Handle and victim LED | post on the front bridge; the LED (5 mm) on top of the bar's front end (x 8.35, z 15.6 to 16.0) | post printed on the frame; bar fixed with two M3; the LED's two wires run down the post to a small connector at the bar | own design | hex key |
| Control deck | front bridge, x 5.2 to 9.15, y -1.25 to 3.6 | start button and power switch on the +y side, two status LEDs in a row on the bridge rib, parts in printed recesses | part sizes open **[placeholder]** | none |
| USB-C service socket | front-right wall at -24 degrees, above the bumper band, 2.0 cm from J12 | panel-mount, front face flush with the wall (7.3) | part open **[placeholder]** | none |
| Wi-Fi and Bluetooth antenna | on the recess wall behind the right bumper, at -22 degrees, z 5.0 to 6.54 (x 9.4, y -3.8) | adhesive flat flex strip from the GIGA's box, 100 mm cable to the u.FL socket J14 (8.5) | none: it is a bought part | none |
| IMU (BNO055 breakout) | (-5.0, 0), board z 4.4 to 4.56, header edge forward | four 5 mm posts on the tub floor, four M2.5 self-tapping screws into 2 mm pilots (8.6) | four holes 20 x 12 mm apart **[src]** product page | 2 mm hex key |

### 3.2 Load paths

- **Weight:** wheels, motor cradles, tub floor; omni, arm, pivot tube, pillar and outer ear, tub floor. Everything else rides on the tub floor.
- **Lifting by the handle:** bar, post, the bridge (3 mm web with an 8 mm rib, a cantilever of 5 cm from the post to the front ring), the front ring, the six screws into the tub wall, floor. Design load 15 N (12 N weight plus handling), times 3 is 45 N: 7.5 N per screw if all six share it, 22 N each if only the two at +-12 degrees did **[calc, placeholder mass]**. The bridge section gives 2.0 MPa at the web underside and 0.19 mm of droop at 15 N, 5.9 MPa and 0.57 mm at 45 N **[calc]** `handle_calc`. The dropper floor is not on this path (it is a separate part sitting on the bridge and the spoke). Bench test: hang 5 kg from the bar.
- **Dropper:** the unit's floor sits on three half-lap seats, two in the bridge web beside its rib and one in the spoke web, and is held down by two snap tabs or thumbscrews; the chutes plug into the wall and steady it sideways. Plate, kits, floor, motor and hoppers weigh about 125 g **[calc, placeholder masses]** `balance`.
- **Shocks:** a 0.15 kg motor and wheel stopping a 2 cm drop in 3 mm is about 6.7 g, 10 N into the seat **[calc, assumed stopping distance]**. The ground pushes the motor into its seat, so the snap only has to keep it seated on rebounds (5.1).

### 3.3 Assembly order and service

First build: (1) tub: nub, floor modules, bumper sockets; (2) drive cartridges and wheels; (3) omni module; (4) GIGA posts, battery tray, GIGA screwed down, shield, battery; (5) harness to the tub side; (6) on the bench, fit ToF boards, cameras and the control parts to the frame; lower the frame onto the tub, six screws, plug the cables; (7) on the bench, build the dropper unit (hoppers under the floor, N20 cartridge in its pocket, plate on the shaft, kits), lower it onto its three seats, snap it down, plug the N20 connector; (8) chute channels in from outside; (9) lid.

Every removal below was run as a path of small steps on the emulator of the rebuild plan, and each is re-run in Fusion after the build (report `removal`, section 12): lid straight up; each wheel out and down; kit plate and N20 cartridge; the dropper unit straight up; the battery; and the full teardown in the order of the last row.

| Operation | Steps | Tools | Time (estimate) |
|---|---|---|---|
| Kit refill | lid off (lift), drop eight kits into the pockets, lid on | none | under 1 min |
| Reflash firmware | USB-C socket in the front-right wall (7.3), lid on | USB cable | -- |
| Dropper unit out | lid off; pull the two chute channels out through the wall; release the two snap tabs (or thumbscrews); unplug the N20 connector; lift straight up. The handle bar starts at x 3.3, in front of the unit, so nothing is in its way | none | about 1 min |
| Battery swap | lid off, dropper unit out, unstrap, unplug, then slide the battery 4.5 cm back and 2 cm inboard and lift it out: Camera L's board is 9.7 mm from its outboard end, the ring over its front corner and the power switch over its front, so it cannot go straight up. For the placeholder 7.0 x 3.5 x 2.5 cm battery, after the 4.5 cm slide back any inboard move from 1.5 to at least 3.5 cm is free (less than 1.5 and the board catches it); a wider or taller battery needs this path re-checked, and the camera cage can move outward **[calc]** `removal` | none | 2 to 3 min |
| ToF board replace | lid off; two M2.5 screws out (a 2 mm hex key through the two holes in the pocket's rear wall); lift the board straight up off its plug (the plug stays in its shaft with its cable); press the new board on, screws in | 2 mm hex key | about 2 min **[estimate]** |
| Camera replace | lid off; two M3 screws out of the cage's ears; lift the cage with the board straight up (not in the Fusion removal report **[proposal]**); unplug the cable; or four M2.5 from the back to take the board off the cage | 2.5 mm and 2 mm hex keys | about 3 min **[estimate]** |
| Look at the LEDs, press reset | lid off; the GIGA's connector edge is open from above because the control deck stops at y -1.25 (7.4); the boot button needs the frame off | none (a pen) | -- |
| Tyre swap | robot raised, set screw, wheel out through the arch | hex key | about 3 min |
| Bumper replace | from outside, hinge pin and a plug | hex key | about 3 min |
| Nub height | loosen the jam nut, turn | wrench | about 1 min |
| Omni wheel and bearings | robot on its back; unscrew the axle screw from the inboard side until it leaves the arm (3.5 mm; a ball-end 3 mm hex key at an angle, because the silver module sits 1.6 cm inboard of the wheel at the same height); the wheel set drops out of the opening with the screw still in it | 3 mm ball-end hex key | about 3 min **[estimate]** |
| Omni arm, spring and pivot | lid off, pull the two chute channels, six screws out, unplug the frame cables (about 15; the dropper unit stays on its seats and travels with the frame), lay the frame beside the tub on its 200 mm cables, GIGA stack out (its four screws; the hex key's elbow needs the column above it), pivot and stop screws out inboard, the wheel set down, the arm with the spring on its tube up (section 4.7) | hex keys | about 20 min **[estimate]** |
| GIGA stack replace | frame off as in the omni service, four screws, shield and GIGA out together | hex key | about 15 min |
| Drive motor service | as above, then the part above the motor comes out first: **left motor, the battery** (it lies 1 mm over the motor and overlaps it by up to 9 mm); **right motor, the GIGA stack** (four screws, the shield cables; it covers the motor). Then the wheel out through the arch, spread the two prongs and lift the cartridge. Nothing else is in the way **[calc]** | hex key | about 15 min left, about 25 min right **[estimate]** |

## 4. Omni module, inside the body

Requested: the omni must not stick out in front of the bumper or the body. **Revised on 9 Oct (fifth round):** the wheel is now the real one, the Nexus 14145, and its mounting is designed down to the screws. [Figure 12](v3-figures/fig12_omni_mount.png) shows it, `omni_mount.py` checks it (output in [results/omni_mount.txt](v3-checks/results/omni_mount.txt)), and [the backlog](2026-10-09-theseus-v3-detail-design-backlog.md) lists what is still open (items O1 to O13). **Sixth round (10 Oct):** the arm has a drawing ([Figure 13](v3-figures/fig13_omni_arm.png), `omni_arm.dxf`), the spring an order sheet ([Figure 14](v3-figures/fig14_omni_spring.png)), the spring's legs now have their supports (4.3), and the parts to make and to buy are listed in 4.8.

### 4.1 The wheel and the layout

**The wheel.** Nexus 14145, a 60 mm double aluminium omni: diameter 60 mm, **25.6 mm wide**, axle hole **12 mm**, **73 g**, 3 kg load, ten 13 mm rollers on two plates **[src]** the Nexus datasheet (vstone.co.jp, read on 9 Oct; Sources). The 8 Oct layout had assumed a 20 mm wide, 30 g wheel: the real one is 5.6 mm wider and 43 g heavier. The datasheet gives no depth or tolerance for the 12 mm hole and its hub for a 4 mm shaft is a separate accessory, so the wheel is mounted on its own hole (4.2): **[measure]** the bore before anything is ordered (backlog O1). The BOM has no omni wheel in stock.

**What the wider wheel forced** **[check]** `omni_mount`, [results](v3-checks/results/omni_mount.txt). On the centre line the wheel would touch the GIGA's front-inner post H1 (the post's edge at y -1.27, the wheel's face at -1.28), so it sits **3 mm to the left (y -0.98 to 1.58)**; the arm is outboard of it (y 1.68 to 1.98, 1 mm gap); the front floor port FP moves out from y 3.2 to **3.5** to keep a 3.3 mm wall of floor beside the arm's corridor; the pivot rises from z 3.6 to **4.2** (a 4 mm pin at 3.6 hung 1 mm under the belly line, and the spring coil of 11.6 mm needs the room); with the pivot higher the axle's arc bows forward, so the rest axle moves back from x 7.0 to **6.85** and the arm grows from 4.49 to **4.60 cm**; and the Wi-Fi antenna, which an aluminium wheel would have detuned from 2.8 mm away, moves from -6 to -22 degrees (8.5).

| | 8 Oct (20 mm wheel) | 9 Oct (real wheel) |
|---|---|---|
| wheel, y | -1.00 to 1.00 | **-0.98 to 1.58** (25.6 mm) |
| rest axle | (7.00, 3.00) | **(6.85, 3.00)** |
| pivot | (2.55, 3.60) | **(2.409, 4.20)** |
| arm length | 4.49 | **4.60** |
| arm angle, rest / compressed | -7.7 / +25.0 degrees | **-15.1 / +16.4 degrees** (31.5 degrees of swing, 2.5 cm of axle travel) |
| front edge, at rest / largest over the travel | 10.00 / 10.04 | **9.85 / 10.01** (wall inner face 10.3) |
| front rim to the wall, over the travel | 2.1 mm | **1.7 mm** |
| wheel face to the GIGA post H1 | 2.7 mm | **2.9 mm** |
| wheel top fully compressed, bridge underside | 8.50, 8.70 | 8.50, 8.70 (2.0 mm) |

The compressed omni tops out at z 8.5, so the front bridge must stay a 3 mm web (underside z 8.7) with its stiffening rib on top **[calc]**.

### 4.2 How it is mounted

One arm, one pivot, one spring, one stop ([Figure 12](v3-figures/fig12_omni_mount.png): side view, front view through the axle, section through the pivot, the arm, the parts list). From the wheel to the floor:

- **Wheel on bearings.** Two **604-2RS bearings (4 x 12 x 4 mm)** sit in the wheel's 12 mm hole: the outboard one flush with the face, the inboard one **seated 5 mm in**, so that the axle screw's head and washer lie inside the hole. They are held by a press fit with retaining compound **[proposal]**; the wheel's outer rings turn, the inner rings are clamped (backlog O2).
- **Axle.** An **M4 x 25 socket screw**: head (7 mm) and a 0.5 mm washer inside the bore, through the inboard bearing, a **12.6 mm sleeve** (6 / 4.1 mm) between the two inner rings, the outboard bearing and a **1 mm spacer** (so that the arm does not touch the wheel), and **tapped into the arm** (2.9 mm of thread in the 3 mm bar, thread-locker). The tip stops 0.1 mm inside the arm's outer face. Two first drafts failed in the dry run: a **nut on the outboard side** would sweep through the floor wall as the axle rises through the floor's thickness (the axle is at z 3.0 at rest and z 5.5 compressed, the floor is z 3.5 to 3.9) and would come within 1.5 mm of the floor port; a **head standing out of the wheel's inboard face** swept through the floor beside the opening and would have needed the opening to cut into the GIGA post's footprint.
- **Arm.** One **3 x 12 mm 6061 aluminium flat bar**, 58 mm long, 46 mm between the holes: an M4 thread at the axle end, a **5.05 mm reamed bore** at the pivot end (the tube is 5.00), an **arc slot** (4.4) and a **2 mm seat hole** 11 mm out for the spring's forward leg (4.3). [Figure 13](v3-figures/fig13_omni_arm.png) and `omni_arm.dxf` are its drawing. A printed 4 x 12 mm PETG bar twists the wheel **2.2 degrees** at the full-travel load through the 15 mm offset between the wheel's mid-plane and the arm's, aluminium 0.14 degrees: PETG for the first fit only **[calc]**. 4.9 g and 0.15 g for the pin (the model budgets 6 g).
- **Pivot.** An **M3 x 25 socket screw** from the pillar's inboard face (head on the pillar, 5.5 mm, clear of the floor by 0.25 mm), through the pillar, a **5 x 3.1 x 13.5 mm steel tube** on which the arm turns (clamped between the pillar and the ear, with the spring's printed arbor on it between the pillar and the arm), into an **M3 x 5.7 heat-set insert in the outer ear**, its tip in the blind hole behind it. The first draft used an M4 screw; its 7 mm head reached 0.5 mm into the floor and scraped it when pulled out in the removal path, and the tube, not the screw, carries the arm's load (below).
- **Printed on the tub.** The **pillar** (y 0.35 to 0.75, x 1.78 to 3.55, to z 4.95, with a **tail** behind the pivot, x 0.99 to 1.78, y 0.35 to 1.2, to z 4.4, that carries the spring adjuster under the rear leg) and the **outer ear** (y 2.10 to 2.98, x 1.91 to 3.65, to z 4.7, 2.0 mm under the battery tray) stand on the floor either side of a **corridor cut through the floor** (y 0.75 to 2.10, x 1.66 to 8.0) that holds the spring, the arm and the stop screw; the wheel has its own **opening** (y -1.13 to 1.73, x 3.65 to 10.1, 1 to 2 mm clear of the wheel over its whole travel). Both are plan cuts through the floor only: the stadium-shaped cuts of 8 Oct, extruded over the whole height, nicked the front wall and the frame boss at +12 degrees. The arm and its slot run in the corridor, which is why the 8 Oct 'arm slot' is gone.
- **Spring** (4.3) and **stops** (4.4).

Above the belly line (z 3.5): the pivot hole has 5.4 mm of printed material under it, the tube's bottom is z 3.95, the spring coil's bottom z 3.62 and the arm at the pivot z 3.60. Below it are only the wheel, the arm (to z 2.4 at the axle end) and the axle set **[check]** Fusion `belly`.

### 4.3 The spring

A **torsion spring on a printed arbor on the pivot tube**: music wire 1.6 mm, mean coil 10 mm (OD 11.6, ID 8.4), **right-hand, 4.07 body turns** (4.29 active turns with the two legs), close-wound length 8.1 mm, in the 9.3 mm between the pillar and the arm. The 9 Oct version of this section left the legs half designed (the forward leg 'hooked on the arm's top edge', the rear leg bent to reach its bolt, the coil hanging on the tube); on 10 Oct they were made concrete **[calc]** `omni_mount` (output [results/omni_mount.txt](v3-checks/results/omni_mount.txt)); [Figure 14](v3-figures/fig14_omni_spring.png) is the order sheet. Both legs leave the top of the coil and are held **from below**:

- The **rear leg** (10 mm to its load point, 12 mm in all) is straight and lies on the hex head of an **M3 x 6 adjuster bolt** in an M3 x 5.7 insert in the pillar's tail, directly under it (the tail is 8.5 mm wide in y for that; the 9 Oct leg was bent 90 degrees to reach a bolt 3.3 mm inboard of its plane). The bolt is turned with a 5.5 mm socket from the side: **one turn is 2.9 degrees, 0.55 N at the axle**.
- The **forward leg** (11 mm to its load point, 12 mm in all) is straight and lies **along the arm, splayed 4 degrees up from it, on a 2 mm stainless pin in the arm**, 11 mm from the pivot. The coil ends 0.7 mm short of the arm's face, so the leg that continues its last turn lies beside the arm, not over it: a tangent leg is 5 mm from the pivot, its 1.6 mm wire spans 4.2 to 5.8 mm, the arm's top edge is at 6 mm, and the pin, standing 3.5 mm out of the arm's inboard face, is the arm's way of reaching the leg. The leg turns with the arm, so it never slides on the pin. The 4 degrees lift it to **1.07 mm over the stop screw** (parallel to the arm it passed 0.5 mm over it); cutting the slot 5 degrees low instead put the screw's head 0.4 mm into the floor on its pull-out path. The pin leaves 1.0 mm of bar over its hole and 1.1 mm to the slot's end.
- Because both supports are under the legs, the load **opens** the coil: 12.4 degrees at rest, 44.0 at full travel, the mean diameter growing from 10.0 to 10.3 mm. Winding it up instead would put the rear leg at the bottom of the coil, on the belly line (z 3.6). Opening is the less favourable direction for a spring (the tension is on the inner fibre, where the textbook factor 1.135 is already counted in the 1055 MPa below).
- The coil sits on a **printed arbor** 7.4 mm in diameter on the tube, between the pillar and the arm, with 0.5 mm of air to the free coil. Without it the 8.4 mm coil hangs on the 5 mm tube 1.7 mm off-centre, pushed up by its two supports until its top is at z 4.95, 0.5 mm over the height of the battery tray's underside (the tray does not reach this far in y), and the legs move with it.

Sized to the 9 Oct model (1.286 kg) **[calc]**:

| | Value |
|---|---|
| front load, level / descending a 25 degree ramp | 2.0 N (15.9 %) / 7.8 N (62 %) |
| preload at the axle (1.2 times the level load) | **2.41 N** |
| force at full travel (8 % over the ramp load) | **8.47 N** |
| rate | 2.42 N/cm: 484 N.mm/rad, 8.45 N.mm per degree (the 8 Oct spec asked 1.8 at 1.07 kg) |
| torque, rest to full travel | 107 to 374 N.mm over 31.5 degrees; preload angle 12.7 degrees |
| wire stress at full travel | **1055 MPa = 48 % of the 2200 MPa tensile strength** (302 MPa at rest) |
| chosen | 4.07 body turns = 4.29 active turns: **493 N.mm/rad** (8.60 N.mm per degree) against 484 needed (+1.8 %): 107 N.mm at 12.4 degrees of opening, 378 N.mm at 44.0 |
| free angle between the legs | 203.6 degrees (4 turns and 23.6 degrees), counterclockwise from the forward leg to the rear leg seen from the right |
| forces on the legs at full travel | forward leg on its pin 34 N, rear leg on the adjuster head 37 N (10 N and 11 N at rest) |
| coil at full travel | mean diameter 10.3 mm (ID 8.7, OD 11.9), at most 0.65 mm off-centre on the arbor |

48 % of the wire's strength, with the load opening the coil, is borderline for a spring that cycles every time the robot crosses a step. By the usual textbook fatigue limits for unpeened music wire (of the order of half the tensile strength for repeated loading from zero, at a million cycles) the stress range of 753 MPa is inside the limit, but the bends at the leg roots carry a stress factor of 1.3 or more, which leaves it little margin; at 10^4 to 10^5 strokes (a season of testing, an estimate) the limits are higher **[estimate from the textbook limits, not a test]**. So **run a life test of the spring alone** (10 000 cycles between the two torques of the order sheet; backlog O5), ask the supplier for stress relief and, if offered, shot peening, and order three. The fallback is a compression spring 25 mm from the pivot (4.3 N preload, 15.0 N at full travel, wire 0.8 mm, OD 9.7 mm, about 9 active coils, 31 mm free length); it does not fit above the arm, where the strip between the wheel's outer face (y 1.58) and the battery's near edge (y 2.2) is 6 mm wide, so it would have to lie along the arm.

### 4.4 Stops, loads and strength

**The stop is a fixed M3 x 25 screw** from the pillar (head on its inboard face), across the corridor, **through an arc slot in the arm** and into a 2.6 mm pilot hole in the ear (7.5 mm of thread), 8 mm ahead of the pivot: it clears the coil's 5.8 mm radius by 0.7 mm. The slot is an arc of radius 8 mm about the pivot, 3.3 mm wide with round ends, 0.2 mm longer than the screw's travel at each end; its two ends are the **rest stop** and the **compression stop**. 2.1 mm of bar is left above and below it and 3.8 mm to the pivot bore. The first draft had a pin on the arm running in a slot of the pillar, 7 mm from the pivot: the pin would have grazed the coil and, cantilevered 11 mm from the arm, would have carried the stop load at about 600 MPa in an M3 screw; the fixed screw is held at both ends (16.5 mm between its supports) and the stop load goes into the aluminium slot end (the screw's threads bear on that aluminium: at rest the spring's 107 N.mm presses it with 13 N, about 170 MPa at the thread crests by the Hertz formula for a line contact, assuming 0.5 mm of crest contact along the 3 mm of the bar: elastic; in the 70 N impact case about 400 MPa, more than the aluminium yields at, so the first hard landings dent the slot end a little and the dent spreads the load **[estimate]**. A thin smooth sleeve over the screw (3.6 mm outside, as long as the pivot tube, the slot 3.9 mm wide) is the cure if the stair test shows the rest end creeping: it still fits, 0.4 mm from the coil and 0.8 mm from the forward leg; a 4 mm sleeve or a shoulder screw would not (backlog O8). It is not needed for the first robot). **Ride height** follows the slot end: 0.2 mm of error moves the wheel 1.1 mm, so the rest end is cut short and filed to the measured ride height (backlog O10).

Loads **[calc]** `omni_mount`, full travel and an impact case with 2.5 times the load while the arm is on its compression stop:

| Item | Full travel on the spring | Impact (21 N at the axle) |
|---|---|---|
| M4 axle | bending 47 MPa (8.8 steel yields at 640) | |
| arm, in plane | 14 MPa (aluminium yields at 240) | |
| arm twist from the wheel's offset | 0.14 degrees (PETG bar: 2.2) | |
| arm's 5 mm pivot bore | 24 N, 1.6 MPa | 81 N, 5.4 MPa |
| steel tube 5 x 3.1 mm between pillar and ear | | bends at 26 MPa |
| M3 stop screw | | 70 N: bending 150 MPa between its two supports; 7.8 MPa on the slot end |
| pillar and ear (through the M3 screw) | | about 3.2 MPa each on a 3.2 x 4 mm patch (PETG about 40) |
| seat pin (2 mm stainless) | 34 N, 1.5 mm from its root: bending 64 MPa (it yields at about 500); 6.8 MPa on its 2.5 mm in the bar | |

### 4.5 Terrain, omni at 6.85 with the 9 Oct mount

Stiff-spring worst case as in rev 3; the chute lip is the 3D-model value z 2.67 (the 19 mm channel gives 2.77 in 2D, 2.91 in the 3D model), so this is conservative; cm, degrees **[check]** `omni_terrain9` (the 8 Oct layout alongside it in [results/omni_terrain9.txt](v3-checks/results/omni_terrain9.txt); `omni_inside` has the earlier positions). A case passes when every clearance over the whole crossing is at least 0.2 cm.

| Case | Belly | Bumper | Chute lip | Tilt | Result |
|---|---|---|---|---|---|
| 2 cm riser up / down | 1.50 / 1.50 | 2.00 / 2.77 | 1.13 / 0.67 | +14.8 / -17.4 | pass |
| two 1 cm steps up / down | 1.86 / 1.50 | 2.28 / 2.77 | 1.13 / 0.67 | +15.6 / -17.4 | pass |
| 25 degree ramp up / down | 1.62 / 1.62 | 2.05 / 2.06 | 1.15 / 1.13 | +25 / -25 | pass |
| 2 cm / 1 cm bump | 1.50 / 2.50 | 2.00 / 3.00 | 0.67 / 1.67 | -17.4 to +14.8 / +-8.5 | pass |
| 3 mm seam | 3.20 | 3.70 | 2.40 | +2.5 | pass |
| three 2 cm stairs, 25 degrees, up / down | 1.44 / 2.34 | 1.76 / 2.93 | 1.13 / 2.67 | +29.6 / -31.4 | pass |
| three 2 cm stairs, 30 degrees (Dangerous Zone), up / down | **0.20** / 1.36 | 0.65 / 1.61 | 1.13 / 2.67 | +31.2 / -34.4 | up has **no margin**: 2.0 mm against the 2 mm threshold (8 Oct: 2.1 mm; rev 3: 1.0 mm, fail) |
| 1 cm bump on a 25 degree ramp (Dangerous Zone) | 0.78 | 1.08 | 1.15 | +33.3 | pass |
| 2 cm bump on a 25 degree ramp (Dangerous Zone) | 0.01 | 0.10 | 0.67 | +39.5 | **fails**, as in rev 3 and on 8 Oct (D8) |

The smallest clearance in the required cases is the chute lip, 0.67 cm, and the omni does not change it. The nose pitches 17.4 degrees coming down a 2 cm riser (14.8 in rev 3), so keep the IMU-pitch gating on the front ToF readings.

### 4.6 Costs: statics, balance and the acceleration limit

**Statics** **[calc]** `omni_mount` (the 9 Oct model, 1.286 kg; `statics.py` keeps the rev 3 budget of 1.07 kg). The front load is **15.9 %** (rev 3: 11.9 %, 8 Oct: 13.6 % at the 1.07 kg budget). A 2 cm step pushed over by the drive wheels needs 0.45 W against 1.26 W of traction (margin x2.8, was x3.4; 1 cm: x7.1); the torque per wheel for a 2 cm riser is 1.87 kg.cm and for a 25 degree ramp 1.09 kg.cm (gearbox limit 5). Coming down a 25 degree ramp the front load is 62 percent, 7.8 N, which the spring (4.3) carries within the 2.5 cm travel. All of these scale with the real mass: the spring needs about 0.19 N/cm more for every 0.1 kg.

**Acceleration limit.** The emulator model of this layout (printed parts from the model volume at 45 % fill, bought parts from the rev 3 budget with the omni module at its bought-part masses, wiring and fasteners as unmodelled lumps) weighs **1286 g**, the Fusion model of the same layout 1287 g, with the centre of mass **1.09 cm ahead of the axle and 6.79 cm high**: front load 15.9 % (2.0 N on the omni), front lift-off at **1.58 m/s^2** (1.21 before the real wheel), nose-down tip when braking at 8.3 m/s^2 **[calc, placeholder masses]** `balance --repo` (9 Oct; output [dryrun/results/balance.txt](v3-fusion/dryrun/results/balance.txt), Fusion `v4_mass.txt`). The omni module weighs 94 g: wheel 73 g and its bearings, sleeve and spacer 77 g, arm 6 g, axle screw 3 g, pivot and stop screws 3 g, spring and its tube 4 g, adjuster 1 g; the 8 Oct budget had 36.5 g (a 30 g wheel and a printed arm). The 57 g of extra mass moves the centre of mass 0.23 cm forward and 0.17 cm down, which **raises the lift limit** (the omni is further ahead of the centre of mass than the extra weight is) and raises the front load by 3.6 points. The ramp margin is better than before: a 0.3 m/s top speed reached in 0.25 s needs 1.2 m/s^2, the limit is 1.58. Still use a PWM ramp of 0.3 s (1.0 m/s^2, what the rev 3 firmware assumed; D5) and weigh the printed parts.

**Axle position (second round: could the drive wheels move back?).** The drive train (wheels, motors, face plates, 302 g) moves with the axle and everything else stays in the body, so each centimetre back moves the centre of mass 0.75 cm forward relative to the axle. **[calc]** `balance` for the balance, **[check]** `axle_shift` for the terrain (same side-view simulator and cases as the omni study, the chute lip kept where the wheel needs it; re-run on 9 Oct with the real omni layout):

| Axle behind the body centre | COM ahead of axle | Front load | Lift-off limit | Swept radius | Terrain cases |
|---|---|---|---|---|---|
| **0 (chosen)** | 1.09 cm | 15.9 % | 1.58 m/s^2 | 11.00 | all nine required cases pass; the Dangerous Zone 2 cm bump on a ramp fails, as in rev 3 |
| 1.0 cm | 1.85 | 23.6 % | 2.68 | 11.98 | same |
| 2.0 cm | 2.62 | 29.6 % | 3.78 | 12.96 | everything passes, the bump on the ramp included (chute lip 0.58 cm) |
| 3.0 cm | 3.38 | 34.3 % | 4.88 | 13.95 | both ramps, both 25 and 30 degree stairs up and both bump-on-ramp cases fail on the chute lip (0.1 to 0.2 cm, once -1.0) |

Nothing here asks for it. The lift-off limit is already above the 1.0 m/s^2 the ramp assumes; each centimetre back takes 7.7 points of load off the driven wheels (9 % less weight on the driven wheels for the stair climb, the one required case with little margin) and adds a centimetre to the swept radius (11.98 at 1 cm against a worst-case corridor half-width of 12.6, which leaves 0.6 cm a side instead of 1.6). The only gain is at 2 cm, where the corner case passes, but the radius 12.96 does not fit the worst-case corridor. So the axle stays at the body centre. If the real robot lifts its nose under acceleration or the omni leaves the floor on the stair test, weigh it and move mass before moving the axle: size the battery tray with at least 1 cm of fore-and-aft slack once the real battery is chosen, so that the battery trims the balance (it is the heaviest single part, 110 g, and moving it 1 cm moves the centre of mass 0.09 cm).

**Swept circle.** Rev 3 had the swept radius 11.0 set by the bumper tips and the omni's front edge. Now only the bumper tips reach 11.0, so pulling the bumpers back to the body radius (rev 3 open item) would give a 21 cm circle.

### 4.7 Service

**The wheel and its bearings come off from below without opening the body:** robot on its back, unscrew the axle screw from the inboard side until it leaves the arm (3.5 mm; a **ball-end 3 mm hex key at an angle**, because the silver module sits 1.6 cm inboard of the wheel at the same height), and the wheel set, with the screw still through its bearings, drops out of the opening. **The arm, spring and pivot** need the frame off (3.3): then the pivot and stop screws come out inboard (2.5 mm hex key; its elbow needs the column above y -1.7, which the GIGA stack covers, so the stack comes out first), the wheel set drops, and the arm with the spring on its tube lifts out (the forward leg lies on the arm's pin and the rear leg on the adjuster head, so both lift off their supports; the arbor and the coil stay on the tube, the pin in the arm). The whole path was run in Fusion as four steps of the teardown report. The wheel does not go straight up: at 25.6 mm it would catch the frame boss at +12 degrees (the first teardown check found it). Spring replacement and the preload (4.3) are done with the arm out.

### 4.8 What to make and what to buy

The omni module as a workshop and shopping list (the same parts are in [Figure 12](v3-figures/fig12_omni_mount.png); backlog O4 to O8). Spares are for the first fit, the life test and the one that gets lost.

| Part | What | Quantity | Notes |
|---|---|---|---|
| Omni wheel | Nexus 14145, 60 mm double aluminium | 1 | long lead time; **measure its 12 mm hole (depth, tolerance) before the bearings are pressed in and the arm is cut** (O1) |
| Bearings | 604-2RS, 4 x 12 x 4 mm | 4 | the BOM's 'size TBD' stock has to be checked (M10) |
| Axle | M4 x 25 socket screw, a 0.5 mm shim washer for M4, sleeve 6 / 4.1 x 12.6 mm (steel or brass tube, +-0.05), spacer 6 / 4.1 x 1 mm | 2 sets | medium thread-locker on the thread |
| Arm | [Figure 13](v3-figures/fig13_omni_arm.png) and [omni_arm.dxf](v3-figures/omni_arm.dxf): 6061-T6 bar 12 x 3 mm, 58 mm long | 2 | a laser or waterjet service takes the DXF (ask for the M4 tap and the reamed holes, or ream and tap them yourself); or saw, drill and file; one printed PETG copy for the first fit (O4) |
| Seat pin | stainless dowel pin ISO 2338, 2 m6 x 6 mm | 3 | retaining compound, driven in from the inboard face |
| Pivot | M3 x 25 socket screw; tube 5 / 3.1 x 13.5 mm, steel or brass | 2 sets | |
| Stop | M3 x 25 socket screw | 2 | the same as the pivot screw |
| Inserts | M3 x 5.7 mm heat-set | 4 | ear (pivot), tail (adjuster), two spare |
| Adjuster | M3 x 6 hex bolt, head 5.5 mm across flats, 2 mm tall | 3 | |
| Spring | [Figure 14](v3-figures/fig14_omni_spring.png) | 3 | custom, lead time; a catalogue torsion spring of the same wire and coil size, within +-15 % of the rate, with its legs cut and bent to this layout, is worth trying first (O5) |
| Arbor | printed sleeve 7.4 / 5.2 x 9 mm (component 'Spring arbor' of the model) | 3 | PETG, printed standing on its end |
| Printed with the tub | pillar, tail and ear | | 3.2 mm pillar holes, 4.0 mm insert holes (section 10), a 2.6 mm pilot for the stop screw in the ear |

Tools: 2.5 and 3 mm hex keys (the axle screw needs a 3 mm ball-end key), a 5.5 mm socket for the adjuster, a spring scale for the force-travel check (O6), a 3.2 mm drill bit as a gauge for the slot.

## 5. Drive train

### 5.1 Motor cartridge and snap cradle

Requested: motors held by an open-sided snap cradle, not screwed to the robot. [Figure 8](v3-figures/fig8_motor_clip.png) and [Figure 9](v3-figures/fig9_mounting.png).

**A snap alone cannot hold the torque.** The motor body is a smooth 20 mm cylinder **[src]**. A hook that keeps a few N of preload on it gives a friction torque of only 0.04 to 0.16 kg.cm (two hooks, friction 0.35); a 2 cm riser needs 1.63 kg.cm and the gearbox limit is 5 **[check]** `mount_check`. The torque has to go through a key.

**Design.**
- **Cartridge:** the motor plus a 3 mm PETG **face plate** screwed to the gearbox face once (2 x M2.5 x 6: 3 mm of plate plus 3 mm of thread, inside the 3.5 mm limit **[src]**; hole spacing **[measure]**). The plate has a 4.4 mm bore for the D-shaft and **one** ear about 8 x 3 mm on the front (+x) side, 15.5 to 23.5 mm from the axle. One ear, not two: on the right motor a rear ear would run into the GIGA post H4 at (-2.27, -6.43).
- **Cradle (printed with the tub):** the seat is the floor cut to the motor radius (20.3 mm), so the lower flanks rest on the floor edge. An outer web 2.5 mm thick (y 6.45 to 6.7, 3 mm clear of the wheel hub at y 7.0, x -1.6 to 2.75) and a ledge each side of the motor (y 5.65 to 6.05; the front one x 1.06 to 2.75, the rear one only x -1.6 to -1.06) form the slot for the plate, 3.4 to 4.0 mm for the 3.0 mm plate, which also cuts through the floor. The ear sits in the slot beside the front ledge and stops the turning. At the gearbox limit the ear carries 25 N on 24 mm^2, 1.0 MPa **[calc]**.
- **Prongs:** two thin vertical walls, one each side of the motor, cantilevered along the axle from the ledges (free length 32 mm, so y 2.85 to 6.05), with a hook at the free end 5.5 mm above the axle and a 0.75 mm undercut. For 2.4 mm thick, 11 mm tall, 32 mm free length the hook must deflect 2.4 mm to pass the equator: 5.6 N to push in per prong, strain 0.84 %, about 4.6 N to pull out, friction 0.15 kg.cm. Across the options tried (1.6 to 2.9 mm thick, 32 to 40 mm free) push-in is 1.3 to 7.6 N, strain 0.4 to 1.0 %, pull-out 1 to 6 N **[check]** `mount_check` (PETG, E 2 GPa, uniform-thickness beam, wedge estimate for the pull-out; the real hook is thicker, so these are indicative).
- **Why walls along the axle:** a printed arm that stands up from the floor bends across the layers and cracks after a few cycles; a wall that bends sideways bends along them (section 10).
- **Retention is modest by nature:** the hook only keeps the cartridge seated against rebounds. If a drop test shows it popping out, add a small detent on each ear or a finger-tight thumbscrew through each plate ear. Release: spread the prongs with two fingers.

Print three cradles (hook height, undercut and wall thickness varied) and keep the one that needs a firm thumb push to seat and a deliberate spread to release. PLA is too brittle for a snap used many times.

**Encoder.** The encoder board's outline is not on the Pololu page. If it sticks out of the 20 mm silhouette, turn that side up or away from the GIGA post H2 at (-1.62, -1.62). If the face-plate screws are unwanted, the alternative is a notch that keys the encoder board, which needs its outline first. **[measure]**

### 5.2 Wheels, tyres and the arches

80 mm silicone tyres, 20 mm wide, on printed hubs on the 4 mm D-shaft. The shaft is 18 mm long **[src]**: 9 mm run from the gearbox face (y 6.1) across the 3 mm gap and the web to the hub face (y 7.0), and 9 mm engage the hub, with an M3 set screw on the flat. **The wheel cannot leave the robot as modelled:** to clear the shaft it must slide about 1 cm outwards, and its outer corner (r 9.85 at x +-4.0, y 9.0) would then reach r 10.7, past the wall's inner face at 10.3. You will swap tyres often (the stair test depends on friction), so the lower wall gets an **arch** on each side, x +-4.4, z 3.5 to 8.3, and the floor opening runs out to the wall: the wheel slides 1 cm along the shaft and drops out downwards. The ring above stays continuous; the lower wall loses about 9 cm of its circumference on each side and gets its stiffness from the floor and the ring **[proposal]**. A snap-in cover for the arch is possible if the openings prove a snag risk.

Two things follow from the arches (found when the rebuild plan was dry-run, **[calc]**). First, the 4 mm strip of wall above each arch (z 8.3 to 8.7) lies in the middle of the camera's field of view: rays from the lens tip (z 9.3, 1.7 cm inside the wall) at -22 to -30 degrees cross it, and the optical axis at -20 degrees just clips its top edge. It is **notched 3 cm wide at the camera window**, so the window is open from the arch up to z 10.6 over that width. Second, a frame boss must not hang over the tyre: at 101 degrees the boss underside (z 7.70) was 1 mm below the tyre's top rim (7.80) once the wheel slid out, and it would have hung from the thin strip. The rear screws are therefore at **+-118 degrees**, with the boss centre just outside the arch (x -4.6 against the arch edge at -4.4; above z 7.7 the tyre only spans x +-1.5), and every boss has a rib to the wall.

### 5.3 Floor sensors and rear nub

**Floor sensors, further forward (second round).** The silver module SM moves from the axle to (7.5, -2.7) and the front port FP from (6.5, +3.0) to (7.5, +3.5) (3.2 until the 25.6 mm omni wheel moved the arm's corridor outward): one each side of the omni bay, faces at z 2.8, in snap pockets in the floor, cables up. They see a tile 7.5 cm of travel earlier (SM) or 1 cm (FP), about 250 ms at 0.3 m/s for the silver module **[calc]**. Terrain: the smallest clearance between the window (2 cm wide, face z 2.8) and the terrain over each crossing is 1.70 / 2.32 cm for the 2 cm riser up / down, 1.30 for the 25 degree ramps, 1.70 for the 2 cm bump, 0.86 for the 25 degree stairs, 0.53 for the 30 degree stairs and 0.67 for the Dangerous Zone bump on a ramp; at the axle they were 2.4 to 2.5, the criterion is 0.2. At x 8.0 the bump on a ramp falls to 0.19 and at 8.5 to 0.08, so 7.5 is about the limit; a face at z 3.3 would add 0.5 cm on the 30 degree stairs and 0.2 on the bump on a ramp **[check]** `fsens_front` (re-run on 9 Oct with the real omni layout; on 8 Oct: 2.37, 0.82, 0.50 and 0.17). The silver module's placeholder box sits 2.8 mm from the GIGA post H1 (1.5 mm needed) and 6.2 mm from the omni wheel in the model; the real front port board is 5.1 mm from the omni arm (`clearances` report, 9 Oct). **The front port FP is the Adafruit TCS34725 board**, 20.32 x 20.32 mm with two 2.5 mm holes 15.24 mm apart at its top edge **[src]** (EAGLE file), so the 2 cm window assumed above is right; **its holder is not designed yet** (a pocket in the floor at (7.5, +3.5) with its face at z 2.8, two M2.5 posts, the cable up: D26), and the silver module stays a placeholder box until the silver bench test chooses the part.

**Firmware.** `color.ino` accepts silver only when the encoders show half a tile of travel (`overNextTile`, TILE_MM/2): that matches a sensor at the axle, which is over the next tile exactly then. A sensor 7.5 cm ahead is over it after TILE_MM/2 - 75 mm, so the V3 firmware takes that threshold; the visited-tile rule (rev 3 5.4.4, more than half the robot on the tile) is unaffected if the reading is latched until the robot has gone half a tile. Black is accepted at any time already **[proposal]**.

The rear nub is a nylon M5 bolt with a PTFE or ball tip in a boss under the chamfer at x -8.0, adjustable 1.5 to 2.5 cm with a jam nut (the nub height test, rev 3 sections 4 and 11) **[proposal]**.

## 6. Dropper

### 6.1 Support and the lift-out unit

The dropper floor (R 5.11, 3 mm) is its own part and the base of the **dropper unit**: floor, kit plate with the kits, N20 cartridge and both hoppers. The unit lifts out in one piece (3.3) and sits on three half-lap seats of the upper frame.

- **Front bridge:** x 3.2 to 9.2, 25 mm wide, a 3 mm web (z 8.7 to 9.0) with a 10 mm wide, 8 mm high rib on top (x 3.25 to 9.05, z 9.0 to 9.8) that carries the handle post. The compressed omni forbids anything under the web (section 4). From x 5.2 to 9.15 the web widens to the +y side as the control deck (7.3).
- **Rear spoke:** x -9.2 to -7.2, 20 mm wide, 3 mm web with a 10 mm wide rib to x -7.9 (z 9.0 to 9.5).
- **Seats:** the disc has three tabs, each the top half of its thickness (z 8.85 to 9.0): two at x 3.0 to 3.9 beside the bridge rib (y +-0.85 to +-1.25, 1.5 mm clear of the handle post) and one at x -7.5 to -6.9 on the spoke. Each lies in a rebate cut into the top half of the web and rests on the web's lower half (z 8.7 to 8.85): the rebates locate the unit in x and y, the lower halves in z. Two snap tabs or thumbscrews on the seats hold it down against rebounds **[proposal, not drawn]**.
- **Lift-out:** the unit leaves straight up past the handle post (the disc is 1.9 mm and the plate 3.9 mm short of it), the bar starts in front of it (7.2), and the two chute channels are pulled out through the wall first. The chutes plug into the wall and steady the unit sideways; they are not the main support. There is no pillar **[proposal]**. The straight lift of 12 cm is free of every other part on the emulator **[calc]** `removal`.

Check: hang 5 kg from the handle and press the plate with a finger (the floor should deflect under 1 mm); lift the unit out and seat it again 100 times and look for wear on the rebates.

### 6.2 Hopper and chute

Rev 3: slot 14.5 mm square at 45 degrees, chute axis starting under the slot at z 7.95. In the first Fusion model the tube mouth was a tilted disc 0.75 cm below the floor and touched it along one edge only. The first rev 4 design (14.5 mm slot and hopper void over a 13 mm square channel, the trough cut flat at z 7.7) passed every static geometry check and then **failed a rigid-body simulation of a kit** (8 Oct). The redesign of 8 Oct (14 mm pockets, 16 mm slot and hopper void, 18 mm bore) passed it only for a plate parked within 1 mm, with 0.16 mm to spare in the bore. **On 9 Oct you asked for the design to be picked on reliability alone, so the numbers were raised to 13 mm pockets, a 17 mm slot and hopper void and a 19 mm bore (D21, D22)**; the design below is that one. What it costs is 0.5 mm of the gap from chute to wheel (5.12 mm, limit 5.0) and 0.5 mm of hopper wall; what it buys is in the bullets. An independent review of the 8 Oct redesign had found that the first simulation left the plate out and shared its poses between friction values; the simulation below has the plate's pocket walls and a pose of its own for every kit.

- **Slot, hopper void and bore:** slot 17.0 mm square (turned 45 degrees), hopper void 17.0 mm square, channel bore 19 x 19 mm inside with 1.6 mm walls (22.2 mm outside). A 10.3 mm cube has a 14.57 mm face diagonal and a 17.84 mm space diagonal. The 17 mm slot and void leave 2.43 mm over the face diagonal, so the cube passes lying at any turn, and tipped **any** way, even standing on a corner, which needs 16.25 mm (the 16 mm slot of 8 Oct failed the 0.9 % of random attitudes within 4.5 degrees of a corner stand, the 14.5 mm slot of the first design 33 % of them, since it is narrower than the face diagonal) **[check]** `cube_slot`, `mount_check`. The 19 mm bore is 1.16 mm wider than the space diagonal (0.81 mm for a 10.5 mm kit, the top of rev 3's 10.3 +-0.2 mm), so a kit that tumbles after its bounce cannot wedge between two side walls or between floor and ceiling, even with the printed hole 0.4 mm small: in the four tolerance corners (10.3 or 10.5 mm kit, bore 19.0 or printed 18.6 mm) and with a 6 g kit all 180 of 180 kits get out at both damping ratios **[check]** `chute_dynamics` (the 18 mm bore of 8 Oct lost 2 to 5 % of the kits with a 10.5 mm kit or a small bore). The square section is centred 1.5 mm above the axis (the inner floor is 8 mm below the axis, the ceiling 11 mm above), so the floor (inner 8 mm, outer 9.6 mm below the axis) is exactly where it was in the 18 mm channel and the lowest point at the wall does not change.
- **Hopper:** a box under each slot, 22 mm outside and 17 mm inside (2.5 mm walls), from z 7.2 up to the floor underside (z 8.7), with a 26 mm flange 1.5 mm thick sealed flat against the floor by two snap tabs. It is a separate part because it hangs below the print plane of the dropper floor, and it lifts out with the unit. Where the channel leaves it, the hopper has a socket: the channel's own section cut out of the downhill wall and floor strip, made 8 mm taller than the channel, so that no piece of the hopper is left hanging above the channel (cut only to the channel's ceiling it left a loose 85 mm3 lintel, and Fusion split each hopper into two bodies; `v4_checks3d` now checks one body per hopper and channel).
- **Open trough:** inside the hopper the channel has no walls and no ceiling. A 25 mm square cut (turned 45 degrees, from z 5.0 up) removes everything of the tube inside it, and a floor slab (outer width, one wall thick, 2.8 cm along the axis from the slot centre) is laid back, so that a kit lands on the inclined floor with no wall end, ledge or ceiling edge to catch it; the cut is bigger than the void so that it goes right through the side walls where the tube begins, and the walls end in a V that leads a kit into the bore. The slab has to reach past the point where the cut's vertical wall meets the sloping floor, 2.55 cm (top face) to 2.65 cm (underside) along the axis, not the 2.04 cm of the cut's corner at axis height: at 2.5 cm it left a notch in the bore floor (found by the review; `test_channel_floor_has_no_hole`, and floor probes in `v4_checks3d` that fail in Fusion with the shorter slab; the figures are those of the 18 mm channel, and the test scans the 19 mm channel's floor the same way with the slab at 2.8 cm and finds no hole). The tube's top corners just outside the cut would reach into the dropper floor, so they are cut at its underside (z 8.7). The hopper and the channel do not overlap, so the channel pulls out through the wall.
- **Axis:** slot centre (-4.73, +-2.73, 7.95) to the exit (-6.0, +-8.62, **4.15**), slope 32.2 degrees (rev 3: 34.9). A straight tube meets the cylindrical wall at about 22 degrees, so its lower edge runs further down the slope than the 2D end cap showed. Lowest point where the channel leaves the wall **[check]** `chute_exit`:

| Exit axis z | Slope | Round tube, r 0.9 | Square, 16.2 outside (first rev 4) | 19 mm channel, 22.2 outside |
|---|---|---|---|---|
| 3.75 (rev 3) | 34.9 | 2.63 | 2.56 | 2.31 |
| 4.00 | 33.2 | 2.90 | 2.84 | 2.60 |
| 4.15 | 32.2 | 3.06 | 3.00 | **2.77** |

  The 3D model measured 2.67 for the round tube at z 3.75, and the terrain tables use that value. At z 4.15 the 19 mm channel's lowest point is 2.77 by this 2D calculation (the 18 mm channel's was 2.78), which runs the tube out to the body radius, and 2.91 in the Fusion model, whose tube ends flat 0.8 cm past the axis's exit point, so that its lower inner corner stops 2 mm inside the wall's outer face (r 10.30; the belly report, `v3-fusion/results/v4_belly.txt`). Both are above the 2.67 of the terrain tables. Raising the exit axis to z 4.35 would put the 2D value back at 3.00, at a slope of 30.9 degrees (tan 0.60, against 0.63 now): that is as flat as the friction range simulated (0.15 to 0.60), so the exit stays at z 4.15 and the 2.77 is accepted.
- **Kit speed and landing** **[check]** `kit_landing_square` (friction 0.35, assumed): exit speed 0.58 m/s (rev 3: 0.64), flight 60 ms, carries 2.9 cm, lands 2.5 cm from a 28 cm wall (2.7), impact 1.02 m/s (unchanged by the redesign: it depends on the slope and the exit height, not on the bore). The simulation below gives a mean exit speed of 0.63 m/s at that friction (0.59 to 0.67). The kit stays 4.7 to 10.8 cm from the victim for victims 3 cm behind to 3.6 cm ahead of the camera, so the 15 cm rule keeps the same slack. Rev 3's remark stands: the impact speed is above the 0.77 m/s of Sprint 3, so the last section may need a friction patch or switchback. The chute test with real kits (rev 3 test 3) decides.
- **Kit simulation of the final design (9 Oct)** **[check]** `chute_dynamics` (MuJoCo 3.15): a 1.2 g kit starts at rest on the floor in its plate pocket over slot B, falls through the slot and the hopper and slides down the channel to the exit. The geometry is the Fusion bodies of the 9 Oct model (`chute_geometry_check`: 0 of 7000 random points differ and none of 8000 points 0.3 mm either side of the faces is on the wrong side). The plate is the four walls of its 13 mm pocket, 5 mm thick, z 9.0 to 10.2, 0.3 mm above the floor, parked exactly over the slot or off along the ring (the pocket turns with the plate). Every kit has its own random turn (up to +-18 degrees, the most the 13 mm pocket allows) and place in the pocket. **Plate parked exactly: 100 % of 1000 kits get out** (friction 0.15 to 0.60, 100 kits each); **parked up to 1 mm off (1.5 degrees): 100 % of 1000**; **1.5 mm off: 100 of 100** at friction 0.35 and 0.55; **up to 2 mm off, the geometric allowance: 99.9 % of 1000**; with bouncy impacts (contact damping ratio 0.3 instead of 1: 0.45 of the impact speed comes back, against 0.13) and the plate parked exactly: **100 % of 1000**; in the four tolerance corners (kit 10.3 or 10.5 mm, bore 19.0 or printed 18.6 mm) and with a 6 g kit: **180 of 180 each**, at both damping ratios. The run fails unless its controls pass: the engine gives the textbook acceleration g (sin a - mu cos a) on a plane tilted 32.2 degrees (3.02, 2.28 and 1.45 m/s2 at friction 0.25, 0.35 and 0.45, against 3.15, 2.32 and 1.49 by the formula), holds a cube still at friction 0.70 (above tan 32.2 = 0.63), and stops an 18.5 mm cube at the 17 mm slot. The 3D kit-path check in Fusion (`v3-fusion/kit_path.py`) lets the cube fall from its pocket to 2 mm above the floor slab and slide out of both channels, centred and shifted 3 mm to each side and 2.5 mm up and down, without touching a part, and blocks a 17.5 mm cube at the slot and a 20 mm cube in the bore (`v3-fusion/results/v4_kit_path.txt`).
- **Parking error and the approach to the slot: the limits found** **[check]** `chute_dynamics`, `plate_tolerance`. *Parking.* A kit lying corner to corner in its pocket is as wide along the ring as the pocket (13 mm) and the slot is 17 mm, so the plate may be parked off by (17 - 13) / 2 = **2.0 mm** (3.0 degrees at the ring) before the kit's corner hangs over the slot's edge and the pocket wall pins it (8 Oct: 1.0 mm). The simulation agrees and shows how sharp the edge is: of 100 kits each, at friction 0.35 and 0.55, with the plate off by 0, 1.0 and 1.5 mm all 100 and 100 get out, by 2.0 mm 90 and 87, by 2.5 mm 57 and 61, by 3.0 mm 27 and 40; in the sweep up to 2.0 mm the kits that got out were, by how far off the plate was (mm), 0.0 to 0.5: 146 of 146; 0.5 to 1.0: 168 of 168; 1.0 to 1.5: 165 of 165; 1.5 to 2.0: 161 of 164 (87.9 % of 1000 in the sweep up to 3.0 mm). The clearance under the plate (0.1, 0.3 and 0.6 mm) made no difference. The other rule, that a neighbouring pocket must not reach the slot, is looser: its first overlap comes at about 4 degrees (`plate_tolerance`: park margin 1.92 mm, wall 4.06 mm, 128 cases, no violation). **The dropper has to park the plate within +-1.5 mm, aiming at +-0.5 mm**: approach the park position from the same side every time (the N20's gearbox has backlash) and measure the repeatability on the bench (the 8 Oct design needed +-1 mm; D22). *Approach.* A plate that turns the pocket onto the slot (from 20 degrees away) and stops there at once: 30 of 30 kits get out at 60, 120 and 200 degrees/s, at friction 0.15, 0.35 and 0.55, so the approach speed no longer matters **[assumed friction; a real stop is not instant]** (8 Oct: only 4 of 30 at 60 degrees/s and friction 0.55).
- **What the simulation does not know, and the corners of the tolerances:** friction (one Coulomb value for every printed surface, 0.15 to 0.60), the impact softness, a uniform cube (the real kit may be weighted off centre: bench test), the plate's hub, motor and the other pockets, the real plate speed and stop, the tub floor, wall and wheel (a kit that leaves anywhere but the exit counts as lost), and the plate's real clearance. The kit's mass is not decisive: a 6 g kit (the mass budget has 6 g per kit) does as well as the 1.2 g one. The bore has 1.16 mm to spare over the cube's space diagonal, more than the kit's own tolerance and a printed hole's shrinkage: a 10.5 mm kit (rev 3's 10.3 +-0.2 mm), a bore printed 0.4 mm small and both together all get out in 180 of 180, bouncy impacts or not (the 18 mm bore of 8 Oct, with 0.16 mm to spare, lost 2 to 5 % of them). The first version of this simulation (8 Oct), with no plate and the same 100 poses for every friction value (so its '1000 kits' were 100), said 98.1 % at 2 mm off for the 16 mm slot and 14 mm pockets; a fresh pose for every kit gave 96.7 % (`results/chute_dynamics_no_plate.txt`) and the pocket walls took it to 82.8 % (`results/chute_dynamics_8oct_14_16_18.txt`): that is why the numbers were raised. If the bench test shows bouncy kits, a 1 mm pad of TPU or felt on the channel's floor slab under the slot takes the bounce out (the hopper's own floor strip covers only 6 % of the void) **[proposal, not simulated]**.
- **What failed first and what was tried** (the first design; `v3-checks/results/chute_dynamics_first_design.txt`, `chute_dynamics_first_design_bore147.txt`): the channel runs 32.8 degrees off the sides of the 45-degree slot square, so a kit that falls straight down arrives turned 32.8 degrees to it. A 10.3 mm cube turned by θ is 10.3 (cos θ + sin θ) wide, 14.2 mm at 32.8 degrees, and the 13 mm bore takes it only within 18.2 degrees of its axis. Kits within 10 degrees of the slot square, which is how a kit sits against a pocket wall, did not get out in any of 10 trials at any friction value (they stopped in the hopper mouth on the low side walls of the trough cut flat at z 7.7); kits turned 20 degrees or more got out 10 of 10. It was geometry, not friction. **Widening the bore to 14.7 mm looked like the fix and was not:** a cube fits at any turn, yet the aligned kits rose only to 30 %. Four things had to change together: (1) the trough is cut down to the bore floor, not flat at z 7.7, which left low side walls for kits to rest on; (2) the slot and hopper void must be wider than the cube's face diagonal (14.5 mm is narrower than 14.57: a tipping kit wedges across the diagonal); (3) the bore must be wider than the space diagonal both ways (with bouncy impacts a 16 mm bore still wedged tumbling kits); (4) no wall end or loose fragment may stand where the trough meets the bore. Not taken: a guide in the hopper that turns the falling kit (an extra part, not simulated), and slot positions at 114.9 degrees on the ring so that the channel runs radially from the plate (it still jammed at friction 0.35 to 0.45 in a quick test, and eight pockets at the current 30-degree pitch do not fit between slots 130 degrees apart: the pitch would have to be 27 degrees, and the drop-sequence check `plate_variants` assumes slots 90 degrees apart).
- **Joint:** the channel slides in from outside through a matching hole in the wall (cut from the channel's own profile, so it is longer along the wall) and past the hopper's socket (snap detent). The exit is trimmed flush with the body radius. The first proposal was to print it in two halves lying flat (trough and cover), no supports; that split has not been redrawn for the open trough **[proposal]**.

### 6.3 Motor bay: N20 baseline, 28BYJ-48 fits

**N20 cartridge (rev 3 motor).** The N20 (10 x 12 x 41.5 mm with encoder, rev 3 section 7) drops in from above through a 10.4 x 12.4 mm pocket in the floor. A 2 mm face plate (two M1.6 screws into the gearbox face, hole spacing **[measure]**) sits in a recess in the floor top so the kit plate rides on a flat floor; two snap tabs on the pocket walls hold it; the shaft stands about 10 mm into the plate hub. To remove it, lift the plate off the shaft and pull the cartridge up. It hangs 4.2 cm below the floor and touches nothing: 10.6 mm to the left drive motor in the 3D model **[check]** `v3_checks3d` (the silver module, 6.1 mm away in that model, has moved to the front, 5.3).

**28BYJ-48 (what you asked to keep room for).** Rev 3 dropped it "as too large". A 28 mm body centred on the plate axis is too large, but the datasheet drawing shows the shaft **8 mm off the body centre**, so the body can be turned to sit beside the axis. With the front face on the floor underside (z 8.7) the body occupies z 6.8 to 8.7. I checked all orientations against the GIGA stack, the battery and the two hoppers **[check]** `stepper_bay`:

| Body offset direction | Result |
|---|---|
| 225 to 270 degrees (body to the front-left or left of the axis, ears across it) | **fits**; widest margin at 230 degrees: body centre (-1.49, +0.61), clearances stack 5.0 mm, battery 8.2 mm, hopper A 19.1 mm, hopper B 4.0 mm (the 22 mm hopper is bigger than the first one). At 270 degrees (centre (-2.0, +0.8)) hopper B is 2.8 mm |
| any other direction | collides with the GIGA stack (4 to 12 mm overlap) or leaves under 2 mm |

So the bay is **kept free** at 230 degrees: nothing may enter a 29 mm circle centred (-1.49, +0.61), z 6.8 to 8.7, plus the two ears (1.75 cm either side of the centre across the offset direction, at (-0.15, -0.51) and (-2.83, +1.74), z 8.0 to 8.7) and the wire block out to 1.7 cm from the centre toward (-0.39, +1.92). The stepper variant needs: a 9.4 mm recess 1.6 mm deep on the floor underside for its 9 mm collar, two M3 screws from below through the ear holes into nut traps in the floor top (flush, under the plate), and a plate hub bored for the 5 mm shaft with flats (the N20 shaft is 3 mm). The dropper floor is printed for one motor or the other; the frame and everything else are common.

**Which one.** Both fit, so rev 3's choice stands for now: the N20 (closed loop, reuses the drive-motor encoder and PID path, torque margin) and the bench test (rev 3 test 7) now compares the N20 with the 28BYJ-48 (reuses the V2 `Stepper` code, no encoder, open loop so a jam loses steps silently, pull-in torque about 30 mN.m, plastic gearbox backlash) and the 15 mm stepper. D10.

### 6.4 Plate and kits

Rev 3 section 7 with the pockets 13 mm instead of 14 (D22): plate R 4.91 at (-2.0, 0), z 9.0 to 10.2, eight 13 mm pockets on a 38.6 mm ring, kits 10.3 mm. A 13 mm pocket holds a 10.3 mm kit with 2.7 mm of play across it, so a kit can sit turned by up to 18 degrees; neighbouring pockets are at least 4.06 mm apart (`plate_tolerance`). The plate rests on the floor (PTFE tape or three printed bumps). With the lid off all eight pockets are visible and open for loading.

## 7. Lid, handle, controls

### 7.1 Lid

A 3 mm plate (z 11.7 to 12.0) resting on the ring, and **four hooks** at about +-71 and +-114 degrees. Each hook is a 1.6 mm skirt segment 8 mm deep (z 10.9 to 11.7) hanging from the rim, about 2.2 cm of arc long (12 degrees), in a rebate in the ring's outer face; a 20 x 8 mm strip of it is freed by an L-shaped slit and anchored along one vertical edge, so it flexes radially in the layer plane, and a bump on its inner face snaps into a groove in the ring. There is no continuous skirt: the ToF beam tunnels reach z 11.18 and a full skirt down to z 10.9 would cover them. The angles come from the free gaps between the ToF and camera windows: screws need centres in 9.2 to 14.8, 56.8 to 76.2 and 100.0 to 123.2 degrees, hooks 63.2 to 73.2 and 103.2 to 116.8, with 3 mm of material to every window (the nine 18 mm beam tunnels and the two camera windows); as built, the screws at 12, 60 and 118 degrees are 7.5, 7.7 and 10.7 mm from the nearest window and the hooks at 71 and 114 degrees 6.9 and 7.1 mm **[check]** `ring_gaps`. The rear screw sits at 118 degrees, inside the angular span of the hook at 114 but 2.9 mm inside it radially (counterbore r 10.05, rebate r 10.34); 118 rather than 101 keeps the boss off the tyre (section 5.2). A hook of this size deflects 0.75 mm with about 1.5 N and 0.45 % strain; with a steep return face four of them hold the lid with roughly 10 N; target 10 to 20 N, set by test print **[calc, estimate]**. The lid lifts straight up; two finger notches at +-12 degrees on the front rim help to start it. It has two camera humps (6.4 x 2.5 cm in plan, 2 mm skin, outer top 12.5, ceiling 12.3: the tilted board and its screw heads stand up into them), a handle slot 6.1 x 1.8 cm (x 2.95 to 9.05, around the post and the bar) and, joined to it, a front notch over the control deck (x 4.9 to 9.2, y 0.7 to 3.5). Nothing electrical is in it. Mass about 60 to 100 g **[placeholder]**. Optional: a microswitch on the ring pressed by a lid tab, so the firmware does not start with the lid off (one input).

### 7.2 Handle

Post 14 mm across on the bridge rib at x 4.0 (x 3.3 to 4.7), up to z 14.0; bar 16 mm across and **54 mm long** along x (x 3.3 to 8.7) at z 14.0 to 15.6, printed lying flat and fixed to the post with two M3. Total height 15.6 cm, 16.0 cm with the victim LED on the bar, against the 25 cm limit **[calc]**. The lid's slot passes the post and the bar, so the lid lifts over them. This keeps rev 3's rule that the handle is on the chassis, not on the lid (rev 3 section 0.2 item 10).

**Why the bar is short (found by the dry run).** The first draft's bar ran from x 0 to 8, over the kit plate and the floor disc, whose front edges are at x 2.9 and 3.1. The removal check on the emulator showed that the dropper unit then cannot lift out: its plate meets the bar after 5 cm of lift. A bar that starts at x 3.3, in front of the post's rear face, lets the unit and everything else leave straight up. The price is the carry. The centre of mass is 1.09 cm ahead of the axle and 6.79 cm high, so hanging from the rear end of the bar (x 3.3, grip at z 14.8) the robot points 15 degrees nose-up, 32 degrees from the middle of the bar and 44 degrees from its front end; the long bar allowed a level carry at x 1.1 **[calc]** `handle_calc`. Alternative (D15): keep the 8 cm bar and unscrew it (two M3) before lifting the unit out.

### 7.3 Controls and the USB-C socket

Rev 3 put the start button and the victim LED on the lid. A lid carrying wires cannot lift off freely, and the first rev 4 draft moved them to a panel at the rear of the ring, 21 to 25 cm of wire from the main PCB, whose connectors are at the front. They now sit on a **control deck** on the front bridge:

- **Deck:** the bridge web widens to the +y side from x 5.2 to 9.15 (to y 3.6). Its -y edge stays at the bridge's (y -1.25), because the GIGA's connector edge starts at y -1.36 and a symmetric deck would have covered the reset button at its inner corner (PB1, about (7.1, -1.5), read from the datasheet picture); found by checking the dry run's access numbers against that picture. With this deck the button is 3 mm outside the deck's edge: a pen reaches it from above.
- **Parts (sizes are placeholders):** power switch (the BOM's circuit breaker or a 12 V rocker, 1.3 x 1.9 cm) at (6.0, 2.15); start button (1.2 cm across) at (7.55, 2.15), both clear of the bar's shadow; two status LEDs in a row on top of the bridge rib at x 7.5 and 6.6, showing through the handle slot.
- **Victim LED (rules 4.2: 'clearly visible to the referee', 500 ms on and off for 5 s):** a 5 mm LED on top of the front end of the handle bar (x 8.35, z 16.0, the highest point of the robot), wires down the post. The first draft had it on the deck; a LED there sits 4 cm under the bar and 1.3 cm below the lid top, so it is hidden from straight above and from the sides below about 40 degrees of elevation, which is not 'clearly visible'. Alternatives (D19): a light pipe through the lid, or the LED on the deck.
- **Lid:** a front notch (x 4.9 to 9.2, y 0.7 to 3.5) joined to the handle slot opens the deck; nothing electrical is in the lid.
- **Wires:** 5 to 8 cm from the deck parts to J12 and the shield's connector strip, 12 cm for the LED on the bar, against 21 to 25 cm from the rear panel **[calc]** `wire_runs`.
- **USB-C service socket:** a panel-mount part in the **front-right wall at -24 degrees**, above the bumper band (z 7.1 to 7.9, 6 mm above the band; front face flush with the wall at r 10.45, so the body stays inside the 10.5 cylinder; 13 mm deep, 8.3 mm from the boss and rib at -12 degrees), 2.0 cm from J12. Reflashing needs no lid removal **[calc]** `wire_runs`, plan test.

If the breaker is wider than 19 mm the deck grows toward the front ring and the notch follows. Alternative if you want the controls on the lid as in rev 3: a plunger in the lid pressing a switch on the ring, and a light pipe over the LED. D12.

### 7.4 What can be checked with the lid off

Share of each part's upper surface that has nothing above it (a grid of rays straight down onto the part and straight up again, on the emulator of the rebuild plan; the GIGA and its shield count as one stack) **[calc]** `access`, and what a hand can do:

| Item | Lid off | Lid and dropper unit off | Reachable |
|---|---|---|---|
| Kits and plate | all | (in the unit) | lift off |
| GIGA | 53 % | **84 %** | connector edge open from above: J12, USB-A, audio jack, LEDs, and the reset button (PB1) with a pen. The boot button (PB2, outer corner at about (7.1, -6.4), r 9.6) is **under the ring**, and Camera R's board and cage hang over the outboard strip (the ring and the camera together hide 16 % of the board): both need the frame off. Double-tapping reset brings up the Arduino bootloader for uploads without PB2; PB2 plus reset is only the recovery route when the bootloader itself is gone **[src]** OpenMV and Arduino support pages, Sources |
| Shield | 53 % | **86 %** | yes |
| Battery and its connector | 66 % | **80 %** | leaves by the path in 3.3 (Camera L's board and cage cover its outboard strip; 80 % is the limit of the check) |
| ToF boards, cameras | all | all | lift out |
| Silver module | 49 % | 49 % | to its pocket from above with a tool; replace with the frame off |
| Left drive motor | 0 % | 54 % | after the battery is out |
| Right drive motor, floor port, omni | no | no (right motor 0 %) | frame off, the GIGA stack off first for the right motor |

**PCB rule for the main board:** connectors, LEDs and jumpers go on the front edge or on the outboard strip (y below -5.1), which the floor disc does not cover; and the shield starts about 20 mm from the GIGA's connector edge so that J12, the USB-A, the audio jack, PB1 and PB2 stay uncovered (check against the datasheet picture).

## 8. Electronics mounting

### 8.1 GIGA and shield

Four orientations against the parts around the six holes **[check]** `mount_check` ([results](v3-checks/results/mount_check.txt)); "usable" means a hole with no conflict when the omni arm is on +y only:

| Orientation | Usable holes | Where they are | Verdict |
|---|---|---|---|
| connector edge to the **front**, header edge inboard | H1 H2 H3 H4 (H1 only with the single arm; all four at least 1.5 mm clear of the right motor's cradle) | the four corners of the board, x -2.3 to 6.0 | **chosen**; connectors reachable from above at the front |
| connector front, header outboard | H1 H3 H4 | three corners | fewer holes |
| connector rear, header inboard | H2 H4 H5 H6 | all in x 3.9 to 6.9, the front 3 cm of a 10 cm board | rear half unsupported; connectors under the dropper floor |
| connector rear, header outboard | H2 H3 H4 H5 H6 (H3 is 0.2 mm from the right motor) | x -1.4 to 6.9 | connectors face the right-hand hopper and chute at the rear |

With the front orientation the holes land at:

| Hole (u, v from the connector and header edges, mm) | Robot frame (x, y cm) | Status |
|---|---|---|
| H1 (15.24, 2.54) | (5.87, -1.62) | usable with the single arm (3.5 mm inside a two-plate swing) |
| H2 (90.17, 2.54) | (-1.62, -1.62) | clear; keep the right motor's encoder pads away from it |
| H3 (13.9, 50.7) | (6.01, -6.43) | clear |
| H4 (96.7, 50.7) | (-2.27, -6.43) | clear, 3.2 mm from the right cradle's web (the plate has no rear ear for this reason) |
| H5 (66.1, 17.8) | (0.79, -3.14) | over the right motor, unused |
| H6 (66.1, 45.6) | (0.79, -5.92) | over the right motor, unused |

Posts: 7 mm bosses with M3 inserts from the floor (z 3.9) to the GIGA underside (z 6.15), 2.25 cm tall; check header solder tails against the floor modules when the model is rebuilt. Screw the GIGA down first, then plug the shield into the headers. The stack's outer front corner is 3.1 mm from the plain wall **[check]** `packing`, and 1.7 mm from the thickened wall behind the right bumper plate in the first 3D model ([v3-fusion README](v3-fusion/README.md)).

**USB-C and buttons.** J12 sits about 13.8 mm from the header edge on the connector edge (read from the datasheet picture), so at about (7.40, -2.74). In front of it there is 2.5 cm to the tub wall but only 1.2 cm to the ring above z 8.7, so a straight USB-C plug does not fit with its cable: use a right-angle plug at J12 with the cable to the front-right wall socket, 2.0 cm away (7.3). The reset button at the inner corner of that edge is reachable from above beside the control deck; the boot button at the outer corner is under the ring (7.4).

### 8.2 Battery

Tray at z 4.9 to 5.1 with a front stop, two strap slots for a 10 mm velcro strap, and the connector lead at the +x end where a hand reaches it. The placeholder 7.0 x 3.5 x 2.5 cm battery overlaps the left motor's footprint by up to 0.9 cm and sits 1.0 mm above it, so the tray has a notch over the motor and a 1 mm foam pad on the motor top. Battery model not chosen. **[placeholder]**

### 8.3 ToF boards and cables

[Figure 10](v3-figures/fig10_tof_mount.png). **The board** is the Adafruit 3317 as drawn in its EAGLE file (July 2020 layout): **25.4 x 17.78 mm** (PCB 1.6 mm assumed), four 2.5 mm holes on a 12.7 x 20.32 mm rectangle, the VL53L0X in the middle of the front face and a STEMMA QT connector at each short end (6.1 x 4.25 mm, about 3 mm tall) **[src]**. **[measure]** which version you own: an older board has another outline and does not fit these pockets. The first Fusion model and the first draft of this section took 21 x 18 mm from the product page. The real board is 4 mm longer, and **lying flat it did not fit the ring**: neighbouring pockets overlapped (FL with SFL, FR with SFR, SRL with RL, SRR with RR), corners left r 10.25 and the frame screws at +-12 degrees found no room between the wider windows **[check]** `tof_mount`. **So it stands on its short end**, which needs 18 mm of ring width and 25.4 mm of height: the ring is 5 mm taller (top z 11.7, lid 11.7 to 12.0), and the six frame screws and the four lid hooks keep their angles (`ring_gaps`).

**The mount** (local axes: u along the beam, v to the left, w up; origin at the middle of the board's front face, beam height z 10.28, the board spans z 9.01 to 11.55):

- **Pocket:** open at the top (the lid closes it), floor at z 9.0 (the ring's 3 mm floor), 0.8 mm wider than the board each side, 2.3 mm behind it and 3.6 mm in front of it for the chip and the connectors. The ring bulges inward around it as a block (3.0 mm wall behind the pocket, 2.5 mm beside and in front); pocket corners stay inside r 10.25, block corners inside r 10.47, and no pocket is within 3 mm of another.
- **Posts and screws:** two printed posts, 5.2 mm square, stand between the board's two upper holes and the front wall, each with a 2.2 mm pilot; **two M2.5 x 6 self-tapping screws** pull the board onto them from behind (4.4 mm into the post). A 2 mm hex key reaches the screws from inside the ring, lid off, through **two 5 mm holes in the rear wall**.
- **Plug shaft:** the lower connector faces down; a 7.6 mm wide shaft through the floor under it takes the plug and its cable into the tub, so the board lifts straight off its plug (3.3).
- **Beam tunnel:** an 18 x 18 mm straight prism from the pocket's front through the front wall and the ring, along the aim (FL and FR keep their 25 degree toe-out). The +-12.5 degree cone needs about 6 mm at the outer face; the rest is margin for print tolerance **[calc]**. Fusion: 0 of 17 rays blocked for each of the nine sensors (`v3-fusion/results/v4_tof.txt`).

**Positions** (the board's front face, x and y in cm and the aim in degrees; moved on 9 Oct so that the pockets fit): F (9.5, 0, 0); FL/FR (8.95, +-3.99, +-25); SFL/SFR (6.85, +-6.0, +-90); SRL/SRR (-6.85, +-6.0, +-90); RL/RR (-8.4, +-3.6, 180). Before: FL/FR 1 mm further out and 1 degree further round the ring, the side boards at x +-7.18, the rear boards at y +-4.5. The numbers the firmware depends on are unchanged: F 9.5 ahead, the side boards 6.0 out, the rear boards 8.4 behind **[check]** unit test.

| Sensor | Plan distance to the stack | Routed run (x1.3 + 3 cm) |
|---|---|---|
| F | 2.5 | 6.3 |
| FL | 5.6 | 10.2 |
| FR | 1.6 | 5.0 |
| SFL | 7.4 | 12.6 |
| SFR | 0.0 | 3.0 |
| SRL | 8.4 | 14.0 |
| SRR | 4.1 | 8.3 |
| RL | 7.5 | 12.8 |
| RR | 5.6 | 10.3 |

100 mm cables reach only 4 of 9; **200 mm cables for all**, which also lets the frame lie beside the tub with everything plugged in. Every cable from the frame (ToF, cameras, the N20 motor, the control deck) is at least 20 cm **[check]** `mount_check` (the routing factor is a guess).

**Effect of moving the modules inward** (first 3D model, finding 1, not yet applied to rev 3 or `v3_params.py`): at the rev 3 positions the four side modules stuck out of the shell by up to 6 mm. With the positions above all board corners are inside r 10.25, and the readings in a 28 cm path become side 80 mm (was 67), rear 56 (47), front centre 45; the worst-case side reading is 46 mm instead of 33, clear of the VL53L0X minimum range (the toed-out reading was not recomputed after the 9 Oct move of FL and FR). Firmware: `TOF_SIDE_OUT_MM` 72.8 to 60.0 and `TARGET_SIDE_GAP_MM` 67.2 to 80.0.

### 8.4 Cameras

[Figure 11](v3-figures/fig11_camera_measure.png). **The board** (OpenMV Cam H7 Plus) is **44.45 x 35.56 x 1.6 mm** (1.6 mm assumed) with four mounting holes at the camera end, read from OpenMV's dimension drawing (+-0.5 mm): 3.0 and 32.5 mm from the left edge at 3.1 mm from the camera end (2.8 mm drilled), 2.4 and 33.3 mm at 8.2 mm (3.05 mm drilled) **[src]**. I had not confirmed this before: the first model used the product page's rounded 45 x 36 mm and rev 3's estimated 2.3 x 2.0 x 2.0 cm lens block. **The lens block is still not published.** The model now uses an **estimate**: the lens axis 5 mm from the camera end and 17.8 mm from the left edge, a holder 17.4 x 17.4 x 12 mm on the front face and a 12.5 mm barrel, so that the lens tip stands 27.4 mm in front of the board (the 29 mm overall depth the product page gives) **[estimate, from the product photo]**. **Six caliper readings on your board settle it** (Figure 11): M1 lens axis from the camera end, M2 lens axis from the left edge, M3 and M4 holder width and length, M5 barrel diameter, M6 height of the lens tip over the board's back and over its front, plus the board thickness and whether header pins are soldered on (they stand 3 mm out of the back).

**Does it fit?** In the model, with the estimated lens block: yes. The board, tilted 20 degrees, stands up into the lid hump with **2.9 mm** to its ceiling (screw heads included); the cage has 2.1 mm to the lid and 10.0 mm to the wheel top, the board's tail is 9.7 mm from the battery, 14.1 mm from the GIGA (Camera R) and 8.0 mm from the kit plate; 0 of 25 view rays are blocked within 3 cm of the lens (`v3-fusion/results/v4_clearances.txt`, `v4_camera.txt`). Each extra millimetre between the lens tip and the board moves the board 0.34 mm toward the lid, so about 6 mm of error in the lens height (M6) is used up before the cage touches it **[calc]**; a holder wider than 17.4 mm changes only the window and the cage's opening. So a wrong lens block means two small reprinted parts (cage and lid), not a new ring.

**The cage** (printed, one per camera, mirrored): a 28 x 37 mm frame, 5 mm thick, with a 20 x 23 mm opening for the lens holder, lies against the board's front face; four M2.5 x 6 screws from the back go through the board's holes into 2 mm pilots in the frame. Two rails carry it to a flange 6 cm wide across the lens axis, 8 to 11 mm behind the lens tip, with a 17 mm opening for the barrel. The flange ends in two **ears**, 10 mm wide and tall and 4 to 6 mm long, that reach the ring's inner face 2.5 cm either side of the lens axis; each takes an **M3 screw along y into an insert in the ring** (z 9.5). The board's tail points toward +x on both sides. The window in the ring is 2.8 x 2.4 cm (3D rays, v3-fusion README finding 2); in the tub it continues down through the notch in the wall strip above the wheel arch (section 5.2). The UART and power cables run up the ring and down into the tub.

### 8.5 Wi-Fi and Bluetooth

The GIGA R1 WiFi carries a Murata 1DX module: Wi-Fi 802.11 b/g/n (65 Mbps) as access point, station or both at once, and Bluetooth Low Energy **[src]** datasheet ABX00063 (sections 2 and 8). There is no on-board antenna. The module uses the u.FL socket J14, which sits at the front-inner corner of the board beside the reset button (about (7.2, -1.9), read from the datasheet picture, +-1 mm), and a flat flex antenna comes in the box (the datasheet lists "Micro UFL antenna (Included)"; its ISED section names a Molex 206994-0100 FPC antenna; a shop listing gives about 15.4 x 6.4 mm on a 100 mm cable **[src, secondary]** [Molex](https://www.molex.com/en-us/products/part-detail/2069940100)).

- **Antenna position [proposal]:** stuck on the inside of the thickened wall behind the right bumper plate (the recess wall, inner face r 10.15) at **-22 degrees** (x 9.4, y -3.8), strip vertical at z 5.0 to 6.54: plastic all round, 8.7 mm from the bumper's microswitch, 6.1 mm under the USB-C socket, 25 mm from the aluminium omni wheel over its whole travel, at least 3 mm from the boss rib at -12 degrees, and about 3 cm from J14, so the routed run (about 7 cm) fits the 100 mm cable **[calc]** unit test `test_wifi_antenna_is_stuck_on_the_bumper_recess_wall...`, Fusion `clearances`. **It moved on 9 Oct:** the 25.6 mm aluminium wheel was 2.8 mm from the first place (-6 degrees), and a metal body within a few millimetres detunes a 2.4 GHz antenna; the next place tried (-17.5 degrees at z 5.5 to 7.04) lay inside the bumper's recess wall and overlapped the tub by 0.036 cm3, which the emulator's dry run found. It stays with the tub, so taking the frame off does not unplug it. Not RF-tested: before the final print, check the range with the robot assembled (laptop and phone at 2 m and 5 m).
- **Use [proposal]:** a **test mode** chosen at power-up (for example the start button held while the power switch is turned on, with an LED showing that the radio is on), in which the firmware starts the radio, streams its log to a laptop (TCP, or Bluetooth serial for a phone) and accepts test commands. In the normal mode the radio is never started. **Rules 4.1.1:** "passing information ... wirelessly ... to the robot is not allowed" during a run, so the competition build receives nothing and the referee can be shown that. Do the final validation runs in the normal mode: the Wi-Fi stack changes timing.
- **Flashing:** over the USB-C socket in the wall, lid on. Wireless upload is possible with the `Arduino_Portenta_OTA` library but needs a one-time partitioning of the board's flash and has rough edges in the forums; the usual `ArduinoOTA` is reported not to support the GIGA. Treat it as an experiment **[src]** [Arduino support](https://support.arduino.cc/hc/en-us/articles/12370721200540-Configure-GIGA-R1-WiFi-Portenta-H7-and-Portenta-Machine-Control-for-Over-The-Air-OTA-uploads), [forum](https://forum.arduino.cc/t/arduinoota-on-giga-r1/1348426).
- **Venue:** 2.4 GHz is crowded at a competition; test mode is for the pit and the practice field.

### 8.6 IMU

The BNO055 breakout (Adafruit 2472: 20 x 27 mm board, 4 mm with the header, four mounting holes 20 mm apart along the board and 12 mm across **[src]** product page; **[measure]** on your board) sits on **four 5 mm posts on the tub floor at (-5.0, 0)**, header edge forward, held by four M2.5 self-tapping screws into 2 mm pilots **[proposal]**. The place is the free column behind the N20: 11.5 mm behind and below the N20 gearmotor and 25.6 mm under hopper A, with the hoppers and chutes beside it and nothing under the rear spoke **[check]** Fusion `clearances`. It is on the centre line, flat, so its pitch and roll are the robot's. The yaw rate does not depend on where the board is; the magnetometer does (the drive motors, the battery and the N20 are magnets and carry currents), so the firmware should run the chip in **IMU mode** (no magnetometer) until it is calibrated in place **[proposal]**: the V2 robot's loss of heading after a pause was traced to the magnetometer-fused mode (NDOF), which re-references itself when the robot is lifted. The chip's own position and the header are not modelled.

## 9. Bumpers

Unchanged from rev 3 section 6: two plates 12 to 58 degrees either side of the centre line, hinged at the outer ends, return spring, 4 mm travel, a microswitch at the inner end of each (band z 4.0 to 6.5, swept radius 11.0). The hinge pin sits in a wall socket; the microswitch in a pocket in the wall at 14 degrees, below the frame boss at 12 degrees. A flexure plate fixed at one end could replace the hinge and spring, but a contact near the fixed end would need several newton, so I do not propose it unless the hinge fails. The omni no longer reaches the swept circle (section 4).

## 10. Printing and fits

| Part | Orientation | Supports | Notes |
|---|---|---|---|
| Tub | floor down | under the rear chamfer and the arches | motor prongs are vertical walls that bend sideways, along the layers |
| Upper frame | ring bottom (z 8.7 plane) down | bridges over the 18 mm beam tunnels, the plug shafts and the 28 mm camera windows (supports if they sag), hook grooves | floor disc, spokes and bridge all lie in that plane; the ToF pockets and posts are part of the print |
| Lid | top down | none | hook tongues are vertical strips that bend radially, along the layers |
| Camera cages (2) | ears flat on the bed | rails and flange (20 degree overhang) | orientation to be chosen in CAD **[proposal]** |
| Chute channel | two halves flat | none | glue or snap; hopper separate |
| Cartridge plates, handle bar | flat | none | |

- **Layer rule:** FDM parts are weakest between layers. Every snap feature is a wall or strip that bends in the print plane; nothing that stands up from the bed bends toward you. Test prints confirm each.
- **Fits:** insert holes 4.0 mm across and 6 mm deep for M3 x 5.7 inserts (8 mm deep under the frame screws). Sliding fits 0.2 to 0.3 mm. Plate slot 3.4 to 4.0 mm for the 3.0 mm plate. M2.5 self-tapping pilots 2.0 to 2.2 mm (2.2 in the ToF posts, 2.0 in the cages and the IMU posts) **[proposal, tune on a test print]**; each ToF pocket is 0.8 mm wider than its board on each side.
- **Size:** a 21 cm part on a 220 mm bed leaves 5 mm each side, and a large PETG ring may warp (brim, enclosure). If the bed is smaller than about 215 mm, the tub and the frame split along y = 0 with a 3 mm tongue and groove and four M3 across the joint; the ring stays continuous across the frame screws. **[measure]**

## 11. Feasibility and risk summary

| Design | Verdict | Main risk | What settles it |
|---|---|---|---|
| Omni inside the body, real wheel and mount | feasible **[check]**, designed to its screws on 9 Oct | the wheel's 12 mm hole is unmeasured (depth, tolerance); the spring is a custom part that runs at 48 % of the wire's strength with the load opening the coil (life untested; order sheet Figure 14), and its legs rest on a pin and a bolt that are modelled, not tested; ride height follows a slot end cut to +-0.1 mm (+-0.5 mm of height); the front rim is 1.7 mm from the wall; the 30 degree stairs case has no margin (0.20 cm against 0.2) and the Dangerous Zone bump on a ramp fails (D8); the nose pitches 17 degrees down a riser | measure the wheel; a spring supplier and a life test; a PETG arm for the first fit, then the aluminium arm; stair test (backlog O1 to O13) |
| Upper frame as one print | feasible if the bed is at least about 215 mm | warping of a 21 cm ring; bed size unknown | measure the bed; split fallback |
| Frame bolted down, handle carries the robot | feasible | six PETG insert pull-outs | hang 5 kg from the bar |
| Lift-out dropper unit on three half-lap seats | feasible **[calc]** | the snap tabs or thumbscrews are not designed; wear of the rebates; the N20 connector; the 5 cm cantilever of the bridge under the handle post (2.0 MPa at 15 N) | 100 lift-outs, press test, 5 kg hang |
| Hopper and square channel | feasible in simulation **[check]** (the first design jammed it, 8 Oct; redesigned, then enlarged on 9 Oct for reliability) | `chute_dynamics` with the plate's pocket walls: 100 % of 1000 kits out with the plate parked exactly, up to 1 mm off, with bouncy impacts and in four tolerance corners (10.5 mm kit, bore printed 0.4 mm small, 6 g kit), 100 of 100 at 1.5 mm, 99.9 % of 1000 up to 2.0 mm (the geometric allowance, (17 - 13) / 2), 87.9 % up to 3.0 mm; 30 of 30 when the plate turns onto the slot at 60 degrees/s; friction, kit mass and impact softness are assumed; joint leaks; the chute-to-wheel gap is 5.12 mm (limit 5.0) | the chute test with 20 cubes at 32 degrees (rev 3 test 3), the plate's parking repeatability from both sides (it must stay within 1.5 mm), a printed bore against 10.5 mm kits; then repeat `chute_dynamics` with the measured friction and bounce |
| N20 cartridge | feasible | face-hole spacing unknown | measure the motor |
| 28BYJ-48 variant | feasible **[check]** | 5.0 mm to the GIGA stack and 4.0 mm to hopper B; open-loop jam | bench test 7 |
| Motor snap cradle | feasible with a key | hooks hold only 1 to 6 N; strain near 1 %; the left motor is under the battery and the right one under the GIGA stack, so a motor swap takes 15 to 25 min **[estimate]** | test prints, detent or thumbscrew fallback |
| Wheel arches | feasible | wall stiffness (the strip above each arch is also notched 3 cm at the camera), a snag edge | print and handle it; snap-in cover |
| Snap-on lid | feasible | hook wear, retention near 10 N | 100-cycle test |
| T-handle, 5.4 cm bar | feasible | nose-up carry: 15 degrees from the rear end of the bar, 32 from its middle | D15: the long bar, removable |
| GIGA on four posts | feasible **[check]** | USB-C access; the boot button is under the ring | right-angle plug and the front-right socket; double-tap reset |
| Battery tray with notch | feasible | battery model and size open | choose the battery |
| ToF boards standing in the ring | feasible **[check]** | the board version (an older 3317 has another outline); screw access through 5 mm holes; the 5 mm taller ring costs balance (lift limit 1.21 m/s^2 before the real omni wheel, 1.58 after) | check your board against Figure 10; print one pocket and fit a board |
| Cameras on cages under lid humps | feasible with the estimated lens block: 2.9 mm to the hump ceiling | lens axis, holder size and lens height are estimates (6 mm of height error is absorbed); the cage's removal path is not in the Fusion report | the six caliper readings of Figure 11, then rebuild the cage and hump if they differ |
| Floor port FP and silver module holders | open | not designed; FP is the 20.3 mm TCS34725 board, SM a placeholder | design after the silver bench test (D26) |
| IMU on four posts | feasible | the magnetometer drifts in NDOF mode (V2 lost its heading that way) | IMU mode in the firmware; calibrate in place |
| Control deck and the USB-C socket in the front-right wall | feasible **[calc]** | breaker size open; the socket is 6 mm above the bumper band and 8.3 mm from the boss rib | choose the parts |
| Wi-Fi and Bluetooth test mode | feasible; the module is on the GIGA | antenna range inside the body untested; the radio must be off in a run (rules 4.1.1); wireless flashing unreliable | range test; test-mode switch; flash over USB-C |
| Battery swap path | feasible for the placeholder battery **[calc]** | Camera L's board, the ring corner and the power switch are over the battery, so it leaves 4.5 cm back and 1.5 cm or more inboard; another battery needs the path re-checked | choose the battery, re-run `removal` |
| Floor sensors at x 7.5 | feasible **[check]** | 0.5 cm clearance on the 30 degree stairs; silver is read 75 mm earlier, so the firmware threshold changes | `fsens_front`, firmware |
| 2WD with 80 mm wheels on a 2 cm step | sound on paper, the one real risk | the friction a rigid wheel needs for a half-radius step is 1.73; the tyre material decides | stair test with the real tyres (rev 3 test 1); plan B in the pre-Fusion report |
| Bumpers | unchanged from rev 3 | none new | none |

## 12. Verification

**Done:** omni terrain cases `omni_inside` (8 Oct layout), `omni_terrain9` (the 9 Oct layout) and the mount itself `omni_mount` (section 4: layout, pivot, stop, spring and its legs, the order sheet's numbers, loads, statics, Figure 12 `omni_figs`; the arm's drawing and cut file `omni_arm`, Figure 13; the spring sheet `omni_spring_sheet`, Figure 14), and the 8 Oct statics `statics_omni_7`; GIGA holes, USB-C space, ToF cable runs, motor prong and plate numbers, cube slack `mount_check`; chute exit lowest point `chute_exit` and kit landing `kit_landing_square`; the kit chute in a rigid-body simulation `chute_dynamics` and its geometry against the Fusion bodies `chute_geometry_check`, which cube attitudes fit a square slot `cube_slot` (section 6.2); 28BYJ-48 bay `stepper_bay`; ring room for screws and hooks `ring_gaps` (with the pockets and windows of `tof_mount`); Figures 7 to 9 `structure_figs` and 10, 11 `sensor_figs`; the 91 unit tests of `test_v3_params4` (the numbers of the model, among them the ToF mounts, the camera cages, the IMU and the omni mount); floor-sensor clearance at x 0 to 8.5 `fsens_front`; the terrain cases for an axle 0 to 3 cm back `axle_shift`; the handle numbers `handle_calc`.

**Dry run (7 Oct):** the rebuild plan's own code (parameters with 38 unit tests, 19 build stages with about 170 probes and an overlap check each, and the whole-model reports) was run on a geometry emulator before any Fusion call ([v3-fusion/dryrun](v3-fusion/dryrun/README.md)): all 51 components without a single overlap, the seven removal paths free, no ToF cone or camera ray blocked, the access report and the 14 spec clearances (13 before the Wi-Fi antenna was added) within their limits, mass and balance as in section 4. It cannot see Fusion API behaviour, so every number is re-measured in Fusion after the build and compared with the emulator's prediction (plan, Task 9). After the chute redesign (8 Oct) the repo files were dry-run the same way (`dryrun.py --repo --clearances`): 44 unit tests, 19 stages with 200 probe and overlap rows, 51 components without an overlap, seven removal paths free, no ToF cone or camera ray blocked, 14 clearances within their limits, mass 1197 g; the plan's own code blocks keep the first chute design. On 9 Oct, after the ToF, camera, frame and IMU changes, the repo files were dry-run again (`dryrun.py --repo`, without the clearance report, which Fusion measures; output `dryrun/results/dryrun_full.txt`): 61 unit tests, 20 stages with 271 probe and overlap rows, 54 components without an overlap, seven removal paths free, no ToF cone or camera ray blocked, mass 1228 g, centre of mass 0.86 cm ahead of the axle and 6.96 cm high (Fusion: 1229 g), and the access shares are the same as Fusion's.

**In the rebuilt 3D model (run on 8 Oct, results below):** interference between all parts; nearest-distance list; assembly and removal paths (lid lifting over the handle, the dropper unit lifting out, the battery path, frame lowering onto the tub, motor cartridge drop-in, wheel out through the arch, chute channel in from outside, GIGA, battery and N20 out); access from above; swept radius and height; ToF cones and camera views with the new ring and the real window sizes; omni sweep with the single arm and the bridge; centre of mass from printed-part masses; the stepper variant.

**Done in the rebuilt model on 8 Oct (history: the 9 Oct run in the next paragraph replaces its numbers, and the files in [v3-fusion/results/](v3-fusion/results/) are the 9 Oct ones):** every stage probe and all eleven reports passed, and they agree with the emulator's prediction. 51 components without an overlap (Fusion's own body-by-body analysis agrees: ten overlaps, all of them joints of flexing prongs and hook bumps with the tub and lid, or the bumper plates touching their switches, `v3-fusion/results/v4_interference_native.txt`; sixteen parts touch nothing, the ToF boards, cameras, floor sensors, USB-C socket, nub and antenna, whose holders are details left to CAD, `results/v4_loose_parts.txt`), seven removal paths free (the lid hooks and cradle prongs treated as flexing), no ToF cone or camera ray blocked, the omni sweep free at 13 positions, 14 spec clearances above their limits, the stepper bay free. A 3D kit-path check added afterwards (`v3-fusion/kit_path.py`, `results/v4_kit_path.txt`) lets a 10.3 mm cube fall from its pocket through slot and hopper and slide out of both channels without touching a part. It first passed the 14.5 mm design, which a physics simulation then showed to jam kits that arrive square to the slot (section 6.2); the chute was redesigned (16 mm slot and hopper void, 18 mm channel, open trough) and rebuilt in Fusion, and the simulation, with the plate's pocket walls in it, takes 100 % of 1000 kits out with the plate parked within 1 mm and with bouncy impacts and 82.8 % with it up to 2 mm off: the dropper has to park within 1 mm (`v3-checks/results/chute_dynamics.txt`; friction, kit mass and impact softness are assumptions, so the chute bench test still decides). What was not a plain pass: the belly report lists twelve known parts below z 3.5, among them the 4 mm omni pivot pin 1.0 mm under the line (section 4 leaves a 3 mm or sunk pin to CAD); the GIGA's BOOT0 button is under the ring (section 7.4, known); the battery leaves only along the 4.5 cm back and 2 cm inboard path; two clearances are larger in 3D than quoted (N20 to the left motor 10.86 mm against 10.6, stepper bay to the GIGA stack 5.76 against 5.0 in plan view) and two are smaller than the numbers quoted before the redesign, both above their limits (chute to wheel 5.62 mm, the 18 mm channel being wider: rev 3 quoted 6.7 and the first rev 4 chute had 8.24, numbers this file does not repeat; stepper bay to hopper B 3.97 mm, 5.2 with the first hopper, corrected in section 6.3); the mass report gives 1198 g, centre of mass 0.89 cm ahead of the axle and 6.81 cm high, front-lift limit 1.29 m/s^2 (emulator 1197 g and 0.90 cm) **[placeholder masses]**; the highest point is the victim LED on the bar, z 16.0 against the limit 25.

**Done in the model rebuilt earlier on 9 Oct (D21, D22, the real ToF and camera boards, the ring at z 11.7, the cages, FP and the IMU; history: the paragraph after this one repeats every report for the omni mount and its numbers replace these where they differ, and the files in [v3-fusion/results/](v3-fusion/results/) are the later ones):** every stage probe and all reports passed, and the emulator's dry run predicted the same numbers (mass 1228 g against 1229 g, the access shares identical). 54 components (176 bodies) without an overlap (Fusion's own body-by-body analysis finds the same ten joints as on 8 Oct: flexing prongs and hook bumps sunk into the tub and lid, and the bumper plates resting on their switches, `v4_interference_native.txt`); five parts touch nothing (FP, SM, the USB-C socket, the nub and the antenna: holders not designed, or details left to CAD, `v4_loose_parts.txt`); seven removal paths free; no ToF cone (0 of 17 rays, nine sensors) and no camera ray (0 of 25) blocked; the omni sweep free at 13 positions; the 3D kit path passes with the 17 mm slot and the 19 mm bore, and its controls block a 17.5 mm cube at the slot and a 20 mm cube in the bore; 24 spec clearances above their limits (`v4_clearances.txt`); mass 1229 g, centre of mass 0.86 cm ahead of the axle and 6.96 cm high, front load 12.3 %, front-lift limit 1.21 m/s^2 **[placeholder masses]**; the highest point is the victim LED on the bar, z 16.0 against the limit 25. **What was not a plain pass:** the battery's open share is 80 % against a limit of 80 %; chute to wheel is 5.12 mm against the limit 5.0 (5.62 mm before D21); the camera board is 2.89 mm and its cage 2.07 mm from the lid hump and lid (limit 1.5 mm), both resting on the estimated lens height (section 8.4); the lift limit 1.21 m/s^2 is within 1 % of what a 0.25 s ramp needs (section 4); the belly report lists twelve known parts below z 3.5, among them the 4 mm omni pivot pin 1.0 mm under the line (section 4 leaves a 3 mm or sunk pin to CAD); the GIGA's BOOT0 button is under the ring (section 7.4, known); the battery leaves only along the 4.5 cm back and 2 cm inboard path; N20 to the left motor (10.86 mm) and the stepper bay (5.76 mm to the stack, 3.97 mm to hopper B) are as on 8 Oct.

**Done in the model rebuilt on 9 Oct for the omni mount (fifth round, D27 to D29; raw output in [v3-fusion/results/](v3-fusion/results/)):** the emulator's dry run (`dryrun.py --repo`) found four faults before any Fusion call, each now a unit test: the axle screw's head, first drawn standing 4 mm out of the wheel's face, swept through the floor beside the opening (0.078 cm3) and would have needed the opening to cut into the GIGA post H1's footprint, so it sits inside the bore; the 7 mm head of the first M4 pivot screw reached 0.5 mm into the floor (0.005 cm3) and scraped it when pulled out, so the pivot became an M3 screw; the first new antenna place (-17.5 degrees) overlapped the bumper's recess wall (0.036 cm3), so it moved to -22 degrees and 1.5 mm closer to the wall; the 25.6 mm wheel could not leave straight up past the frame boss at +12 degrees (0.087 cm3), so the removal path drops it down after the axle screw is out. The emulator's last run, then Fusion: the probes of all 20 stages (304 rows with the overlap checks) pass; **57 components (191 bodies) without an overlap**, and Fusion's own body-by-body analysis finds the same ten joints as before (flexing prongs, hook bumps, bumper plates on their switches, `v4_interference_native.txt`) and the same five parts that touch nothing (FP, SM, the USB-C socket, the nub and the antenna, `v4_loose_parts.txt`); **seven removal paths free**, the teardown run as 15 windows with the omni module in four steps (pivot and stop screws out inboard, the axle screw 3.5 mm out of the arm, the wheel set with the screw down, the arm with the spring on its tube up); no ToF cone (0 of 17 rays, nine sensors) and no camera ray (0 of 25) blocked; the omni sweep free at 13 positions with the new parts; **29 spec clearances** above their limits (`v4_clearances.txt`: wheel to post H1 2.87 mm, wheel to the floor opening 1.50 mm, arm to battery 4.36 mm, FP to arm 5.05 mm, antenna to wheel 25.2 mm, to the bumper switch 8.65 mm and to the USB-C socket 6.10 mm); the access shares are the emulator's and the same as before; mass 1287 g (emulator 1286 g), centre of mass 1.09 cm ahead of the axle and 6.79 cm high, front load 15.9 %, front-lift limit 1.58 m/s^2 **[placeholder masses]**. **What was not a plain pass:** the 30 degree stairs case has no margin (0.20 cm against 0.2) and the Dangerous Zone bump on a ramp fails (section 4.5, D8); the battery's open share is still 80 % against a limit of 80 %; chute to wheel is 5.12 mm against the limit 5.0; the front rim is 1.7 mm from the wall; a spring-to-arm clearance pair was dropped because the tube touches the arm's bore by design. The belly report lists the same twelve known parts below z 3.5, now without a pin: the pivot tube is 4.5 mm and the spring coil 1.2 mm above the line.

**Done in the model rebuilt on 10 Oct (sixth round: the spring's forward leg and seat pin, the arbor, the straight rear leg and its M3 x 6 bolt, the 5.05 mm bore, the wider tail; raw output in [v3-fusion/results/](v3-fusion/results/)):** the emulator's dry run passed first time (91 unit tests, 20 stages with the omni stage at 41 probes, 57 components without an overlap, the seven removal paths free, the omni sweep free, mass 1286 g). Fusion: the probes of all 20 stages pass (the omni stage's 41 rows with the new pin, leg and arbor, the tub's 53 with the wider tail); **57 components (193 bodies) without an overlap**, Fusion's own body-by-body analysis finds eleven joints, the ten of before and the forward leg lying on its pin (a line contact, no volume, `v4_interference_native.txt`), and the same five parts that touch nothing; **seven removal paths free** (the teardown again as 15 windows; the arm is lifted out with the seat pin and the forward leg on it, the spring with its arbor); the omni sweep free at 13 positions with **11 moving bodies** (the wheel set, the arm with its pin and forward leg, the axle screw set); **29 spec clearances** as on 9 Oct and **six new leg pairs** (`v4_legs.txt`: the forward leg over the stop screw 1.07 mm, the seat pin to the screw 1.26 mm, the leg tip to the wheel rim 4.32 mm, the pin to the rim 4.23 mm, the arbor to the coil 0.50 mm, the rear leg on the adjuster head 0.00 mm by design); mass 1287 g (emulator 1286 g), centre of mass 1.09 cm ahead of the axle and 6.79 cm high, front load 15.9 %, front-lift limit 1.58 m/s^2 **[placeholder masses]**: the arbor, the pin and the longer leg add under 1 g, inside the rounding of the 6 g arm and 4 g spring budgets. **What was not a plain pass:** nothing new; the earlier open points stand. One design step was undone on the way: cutting the stop slot 5 degrees below the arm's axis (to give the forward leg more room over the screw) put the screw's head 0.4 mm into the floor on its pull-out path (a unit test caught it before any model was built), so the leg is splayed up instead.

**Independent review of the chute redesign (8 Oct, a fresh reviewer on the working tree; the first reviewer run on 2e1d6e6 had failed on a usage limit):** it found the plate missing from the simulation and 100 poses shared by all friction values (both fixed: the 2 mm result went from 98.1 to 82.8 %), a notch in the bore floor where the slab ended 0.15 cm short of the trough cut (slab 2.5 to 2.8 cm, with a test and floor probes), '16 mm passes the cube in any attitude' (a corner stand needs 16.25 mm: wording, `cube_slot` and the test renamed), a turning-room check in `kit_path.py` that could no longer fail (now a width check), a bore margin thinner than the kit tolerance (tolerance corners, D21), the rebound figure (0.45, not the textbook 0.37), the place of a pad (the slab, not the hopper's floor strip), the kit mass (6 g in the mass budget: tried, no effect) and stale numbers (`plate_tolerance` for the 16 mm slot).

**Bench:** three motor cradles; the chute channel with 20 cubes at 32 degrees; the plate parked 0.5, 1, 1.5 and 2 mm off with kits at several turns, and the plate's parking repeatability from both sides; a printed bore against 10.5 mm kits; the kit's slide-off angle on printed PETG along the layer direction (friction) and its rebound; a weighted kit with an off-centre centre of mass; the seam of the two-half channel and the step where the hopper meets the floor slab; lid hooks; hopper seal; battery tray fit; wheel hub on the D-shaft; 5 kg hang from the handle; frame screw pull-out in PETG; N20 against 28BYJ-48 (rev 3 test 7); one ToF pocket printed and a board fitted (version, screws, plug); the six camera readings of Figure 11 and a test fit of one cage; the IMU in IMU mode (heading after a pick-up); the omni mount (backlog section 5): spring force against travel at the axle, spring life (10 000 cycles), axle-thread pull-out, the seat pin's fit in the arm, the slot end after the first landings (dent), ride height, the PETG arm fitted first, then the stair test.

## 13. Decisions and open items

New decisions, delegated to this review on 7 Oct (alternatives that also work in brackets):

| # | Decision | Default |
|---|---|---|
| D9 | Omni centre x | **6.85** since 9 Oct (D27 to D29); 7.0 in the 8 Oct layout (7.3 and 6.5 also passed) |
| D10 | Dropper motor | **N20, confirmed by you on 7 Oct** (rev 3 motor); the 28BYJ-48 fits and its bay is kept free in case the bench test (rev 3 test 7) disagrees |
| D11 | Omni arm | single, on +y; since 9 Oct a 3 x 12 mm aluminium bar (D28) |
| D12 | Lid, handle, controls | snap lid with four tongue hooks, T-handle on the bridge, controls moved off the lid onto a control deck on the front bridge and the USB-C socket into the front-right wall (**asked for by you on 7 Oct, second round; layout approved**; alternative not taken: plunger and light pipe through the lid) |
| D13 | Wheel arches | yes |
| D14 | Chute channel | 19 mm square bore (22.2 mm outside) centred 1.5 mm above the axis, open trough under a 17 mm slot, exit axis z 4.15 (redesigned 8 Oct, enlarged 9 Oct for reliability, section 6.2; it was a 13 mm square, then 18 mm) |
| D15 | Handle bar | 5.4 cm bar from x 3.3 so that the dropper unit lifts out past it (carried 15 to 32 degrees nose-up) (**confirmed by you on 8 Oct**); alternative: the 8 cm bar, unscrewed (two M3) before the unit comes out |
| D16 | Axle position | at the body centre (1 cm back adds 7.7 points of front load and 1 cm of swept radius; nothing needs it) |
| D17 | Dropper unit | floor, plate, kits, N20 and hoppers lift out as one unit on three half-lap seats; snap tabs or thumbscrews to be designed |
| D18 | Floor sensors | silver module and front port both at x 7.5 beside the omni bay; the firmware `overNextTile` threshold becomes TILE_MM/2 - 75 mm |
| D19 | Victim LED | on top of the handle bar's front end (rules: clearly visible to the referee) (**confirmed by you on 8 Oct**); alternatives: a light pipe through the lid from a LED on the deck, or the LED on the deck (hidden from straight above) |
| D20 | Wi-Fi and Bluetooth | the GIGA's built-in module in a test mode only (log streaming and test commands); antenna stuck on the front wall; flashing stays on USB-C; the radio is never started in a run |
| D21 | Channel bore | **19 mm, closed on 9 Oct on reliability alone, as you asked**: 1.16 mm over the cube's space diagonal and 0.81 mm over a 10.5 mm kit's; all tolerance corners 100 %; costs 0.5 mm of the chute-to-wheel gap (5.12 mm, limit 5.0) and 0.5 mm of hopper wall; the 18 mm bore of 8 Oct had 0.16 mm |
| D22 | Pockets, slot and dropper parking | **13 mm pockets and a 17 mm slot, closed on 9 Oct on reliability**: the plate may be parked 2.0 mm off, and 100 % of the kits get out up to 1.5 mm in the simulation, so **the dropper has to park within +-1.5 mm, aiming at +-0.5 mm**, approached from one side (**requirement from the simulation, to be confirmed on the bench**); the approach speed no longer matters. The 8 Oct design (14 mm pockets, 16 mm slot) needed +-1 mm and a final approach of 120 degrees/s or more |
| D23 | ToF boards | **standing on their short end in pockets of a ring 5 mm taller (top z 11.7)**, two M2.5 screws each, positions as in 8.3 (**my decision on 9 Oct: the 25.4 mm board does not fit lying down**); alternative: a smaller VL53L0X board, which would let the ring drop back toward 11.2 |
| D24 | Camera mount | a printed **cage** with ears into inserts in the ring, the board tilted 20 degrees under a lid hump (outer top 12.5); **the lens block is an estimate: decide after the six measurements of Figure 11** (the cage and the hump are two small parts to reprint) |
| D25 | IMU | BNO055 on four posts at (-5.0, 0), **firmware in IMU mode** (no magnetometer) until calibrated in place |
| D26 | Floor port and silver module holders | **not designed**: FP is the 20.3 mm TCS34725 board (holes known), the silver module a placeholder until the silver bench test; the holders (pocket with the face at z 2.8, posts, cable) are the next mechanical task |
| D27 | Omni wheel | **Nexus 14145** (60 x 25.6 mm, 73 g, 12 mm hole), found on 9 Oct: the placeholder of 8 Oct was 20 mm wide and 30 g. **To be bought; it has a long lead time and its 12 mm hole has to be measured (backlog O1, M1)** |
| D28 | Omni mounting | **designed on 9 Oct (section 4, Figure 12)**: two 604 bearings and an M4 axle screw tapped into a 3 x 12 mm aluminium arm; an M3 pivot screw and a 5 mm tube between a printed pillar and ear; a torsion spring (484 N.mm/rad, 2.4 N preload, 8.5 N at 2.5 cm) with an adjuster screw; a fixed M3 stop screw in an arc slot of the arm. Not taken: a printed PETG arm (twists the wheel 2.2 degrees: for the first fit only), a compression spring above the arm (31 mm long, the strip beside the wheel is 6 mm wide), a pin on the arm running in a slot of the pillar (the stop load would bend its M3 pin at 600 MPa) |
| D29 | Layout shifts the real wheel forced | omni axle x 6.85 (was 7.0), pivot z 4.2 (was 3.6), the wheel 3 mm left of centre, front floor port at y 3.5 (was 3.2), Wi-Fi antenna at -22 degrees on the bumper recess wall (was -6), the floor opening as two plan cuts instead of the 8 Oct stadium cuts; every check re-run on 9 Oct |
| D30 | Omni spring: legs, supports, arbor (10 Oct) | **right-hand, 4.07 turns, straight tangent legs; the load opens the coil**; rear leg on an M3 x 6 bolt in an insert in a tail widened to y 1.2; **forward leg 4 degrees up from the arm on a 2 mm pin in the arm**; the coil on a **printed 7.4 mm arbor**. Not possible: the 9 Oct forward leg 'hooked on the arm's top edge' (the coil is beside the arm, not under its edge), the 90 degree bend in the rear leg (an adjuster inboard of the leg's plane), the coil on the bare 5 mm tube (1.7 mm off-centre). **Needs a spring supplier and a life test (backlog O5)** |
| D31 | Stop screw wear (10 Oct) | the screw's threads bear on the aluminium slot end: **accepted for the first robot** (about 170 MPa at rest, about 400 MPa in the 70 N impact case: a small dent that spreads the load); the smooth sleeve of the 9 Oct note is **optional**, decided after the stair test (backlog O8) |

Chute (section 6.2): the first design jammed kits in the simulation (8 Oct) and was redesigned; on 9 Oct the numbers were raised for reliability (D21, D22): 100 % of the kits get out with the plate parked within 1.5 mm and in every tolerance corner simulated. What remains is the bench test with real kits: friction, bounce, the plate's parking repeatability (+-1.5 mm needed), the bore against 10.5 mm kits.

Measurements needed from the real parts **[measure]**: **the six camera readings of Figure 11** (lens axis, holder, barrel, lens height, board thickness, header pins); **which version of the VL53L0X board 3317 you own** (the July 2020 layout is modelled, Figure 10); **the Nexus 14145's 12 mm hole (depth, tolerance, hub) and whether your bearings of 'size TBD' are 604-2RS (4 x 12 x 4 mm)**; Pololu encoder board outline and the 20D face hole spacing; N20 face hole spacing; the BNO055's hole positions (the product page's 20 x 12 mm are used); printer bed size; battery model (the removal path of 3.3 depends on it); power switch size; the GIGA's reset and boot button and J14 antenna socket positions (read from the datasheet picture, +-1 mm); the antenna's range inside the body. Also open: where to source the torsion spring (its order sheet is Figure 14, backlog O5) and who cuts the arm (Figure 13 and the DXF, backlog O4); the snap tabs or thumbscrews that hold the dropper unit; the holders of FP and SM (D26); the M3 screw length and insert depth under the taller ring (3.1); whether to add a charge port beside the USB-C socket so the battery need not come out to charge (not designed). **Electrical, found while checking the BOM (not mechanical):** the Qwiic mux listed (TCA9548A) has 8 channels for nine ToF boards, and the BOM counts 7 ToF boards as required (14 in stock) against the nine of this design. Rev 3's open items (stair test, silver bench test, chute test with the new geometry, D1 to D8) are unchanged. **Everything still to be detailed is in one prioritised list: [2026-10-09-theseus-v3-detail-design-backlog.md](2026-10-09-theseus-v3-detail-design-backlog.md).**

## 14. Out of scope

Tracked drive, 4WD, mid-run reloading, changes to the mapping algorithm, the PCB layout itself (only its rules, section 7.4), wiring harness drawings, a custom omni wheel design.

## Sources

[Arduino GIGA R1 WiFi datasheet ABX00063](https://docs.arduino.cc/resources/datasheets/ABX00063-datasheet.pdf) (pages 9 and 18); [Pololu 3493](https://www.pololu.com/product/3493) and [3499](https://www.pololu.com/product/3499); [Nexus 14145 omni wheel datasheet](https://www.vstone.co.jp/products/nexusrobot/download/nexus_14145.pdf) (diameter, width, axle hole, mass; read on 9 Oct); [Adafruit 3317](https://www.adafruit.com/product/3317) and [858](https://www.adafruit.com/product/858), [1334](https://www.adafruit.com/product/1334) (TCS34725) and [2472](https://www.adafruit.com/product/2472) (BNO055), and the EAGLE files [Adafruit-VL53L0X-ToF-Distance-Sensor-PCB](https://github.com/adafruit/Adafruit-VL53L0X-ToF-Distance-Sensor-PCB) and [Adafruit-TCS34725-Color-Sensor-Breakout-PCB](https://github.com/adafruit/Adafruit-TCS34725-Color-Sensor-Breakout-PCB) (outlines, holes and connectors, read on 9 Oct); the JST SM04B-SRSS-TB listings (connector height); [Kiatronics 28BYJ-48 datasheet](https://pdf.direnc.net/upload/28byj-48-reduktorlu-step-motor-datasheet.pdf) (dimension drawing, page 1); [OpenMV H7 Plus](https://openmv.io/products/openmv-cam-h7-plus) (product page, photos and dimension drawing, read on 9 Oct); [Molex 206994-0100 antenna](https://www.molex.com/en-us/products/part-detail/2069940100); [OpenMV page for the GIGA R1 WiFi](https://docs.openmv.io/openmvcam/quickref/arduino-giga-r1-wifi.html) and the [Arduino support article on the flashing red LED](https://support.arduino.cc/hc/en-us/articles/7991505987612-If-an-LED-on-GIGA-R1-WiFi-is-flashing-red) (double-tap reset, BOOT0); the rev 3 spec; the scripts in [v3-checks/](v3-checks/README.md) (`omni_inside.py`, `statics.py`, `kit_final.py`, `chute_exit.py`, `mount_check.py`, `stepper_bay.py`, `ring_gaps.py`, `structure_figs.py`, `chute_dynamics.py`, `tof_mount.py`, `sensor_figs.py`, `omni_mount.py`, `omni_terrain9.py`, `omni_figs.py`) and the 3D checks in [v3-fusion/](v3-fusion/README.md).
