Chrisyyyys/Robocup-Junoir-Theseus/docs/superpowers/specs/v3-fusion/README_rev3.md

# Theseus V3 in Autodesk Fusion (revision 3 model, kept for reference)

> This is the README of the first Fusion model (7 Oct 2026, `v3_model.py`, `Theseus_V3_baseline.f3d`). It was replaced by the rev 4 model on 8 Oct; the current README is [README.md](README.md). Its four findings against the rev 3 spec are all in the rev 4 spec and `v3_params4.py`.

A 3D layout model of the V3 baseline in [the design spec](../2026-10-06-theseus-v3-robot-design.md), built by script so it can be regenerated and checked.
All numbers come from [v3_params.py](../v3-checks/v3_params.py), the same file the 2D checks and figures use. Units cm, frame x forward, y left, z up, origin at the
midpoint of the drive axle on the floor line (Fusion is set to Z up here). 39 components, about 360 timeline features.

**Status:** layout model. Every part sits at its specified position and the shell has all the openings. Structure that the spec does not define is not modelled (below).
Nothing here has been measured or printed; masses and the PCB are placeholders as in the spec.

## Files

| File | What it is |
|---|---|
| `fusion_lib.py` | Helpers: sketch shapes, extrude with offset start, cuts, tilted frames, colours |
| `v3_model.py` | The model: one function per subsystem (`build_chassis`, `build_drive`, ...), `build()`, `verify()` |
| `v3_checks3d.py` | Read-only 3D checks: ToF cones, camera fields of view, omni sweep, nearest distances |
| `v3-fusion.py`, `v3-fusion.manifest` | Entry point for Fusion's Scripts and Add-Ins dialog (not run through that dialog yet; the same calls were run through a script runner) |
| `Theseus_V3_baseline.f3d` | Export of the finished model (safety copy; the Fusion document itself is unsaved) |
| `views/` | Screenshots: top (lid hidden), side, iso, underside |
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
