Chrisyyyys/Robocup-Junoir-Theseus/docs/superpowers/specs/v3-figures/fig1_top.png

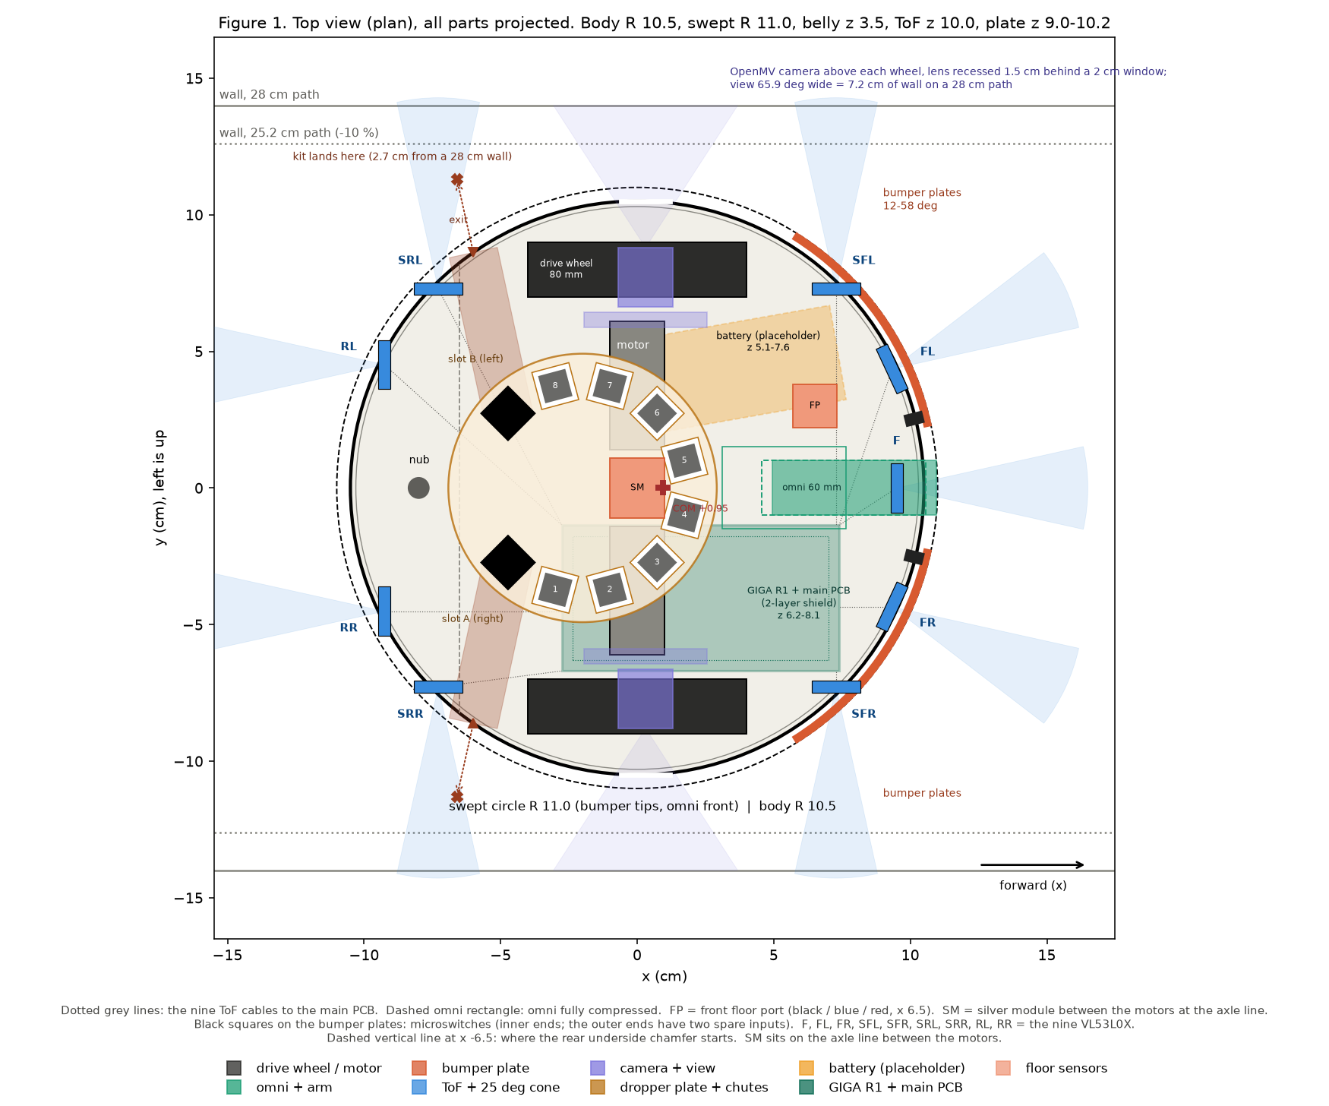
docs/superpowers/specs/v3-figures/fig1_top.png
