Chrisyyyys/Robocup-Junoir-Theseus/docs/superpowers/specs/v3-figures/fig2_side.png

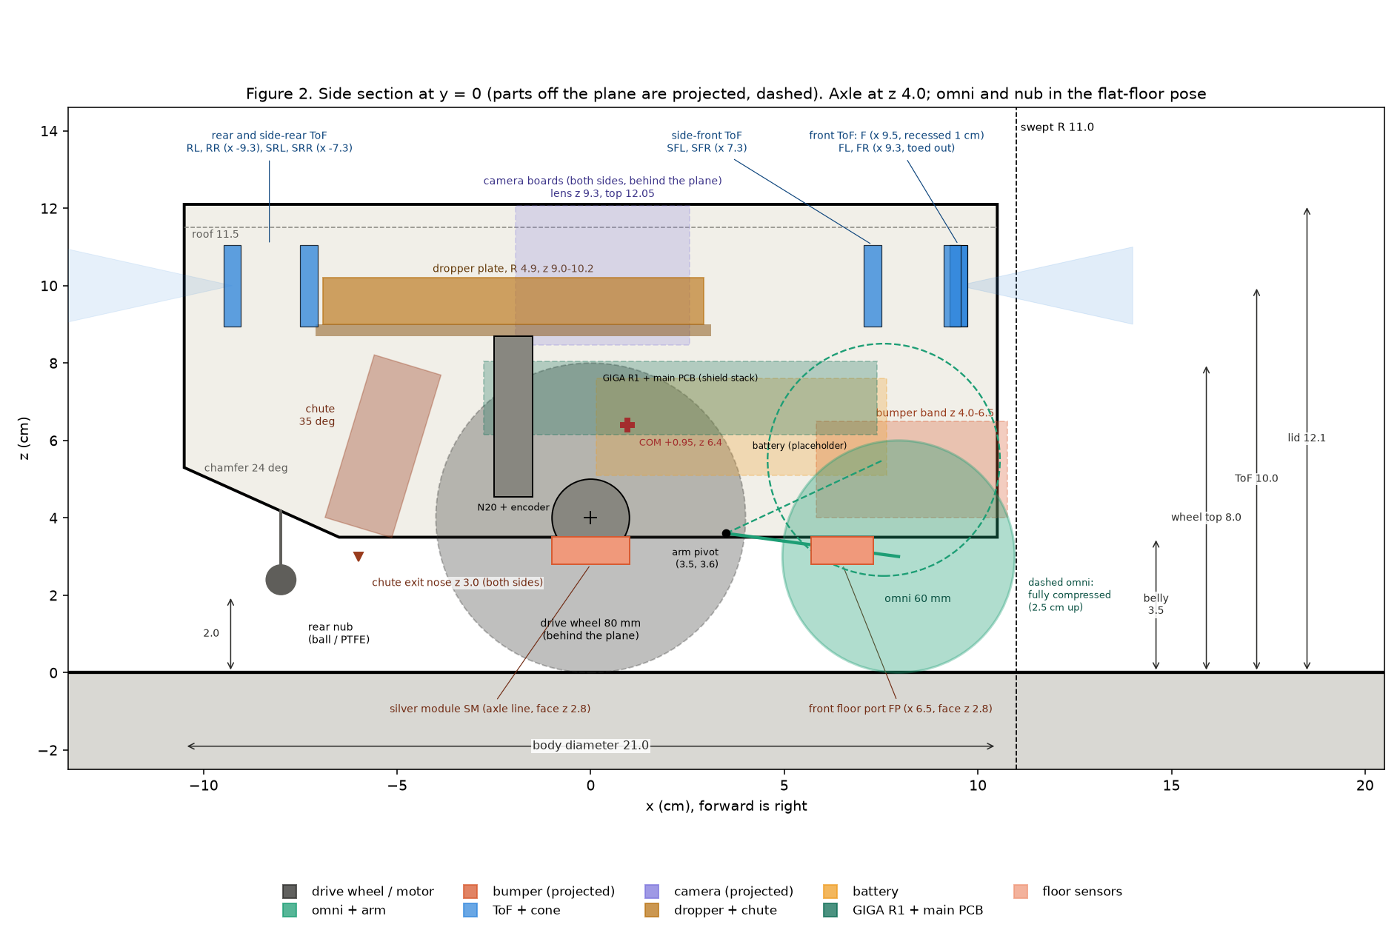
docs/superpowers/specs/v3-figures/fig2_side.png
