Chrisyyyys/Robocup-Junoir-Theseus/docs/superpowers/specs/v3-figures/fig3_front.png

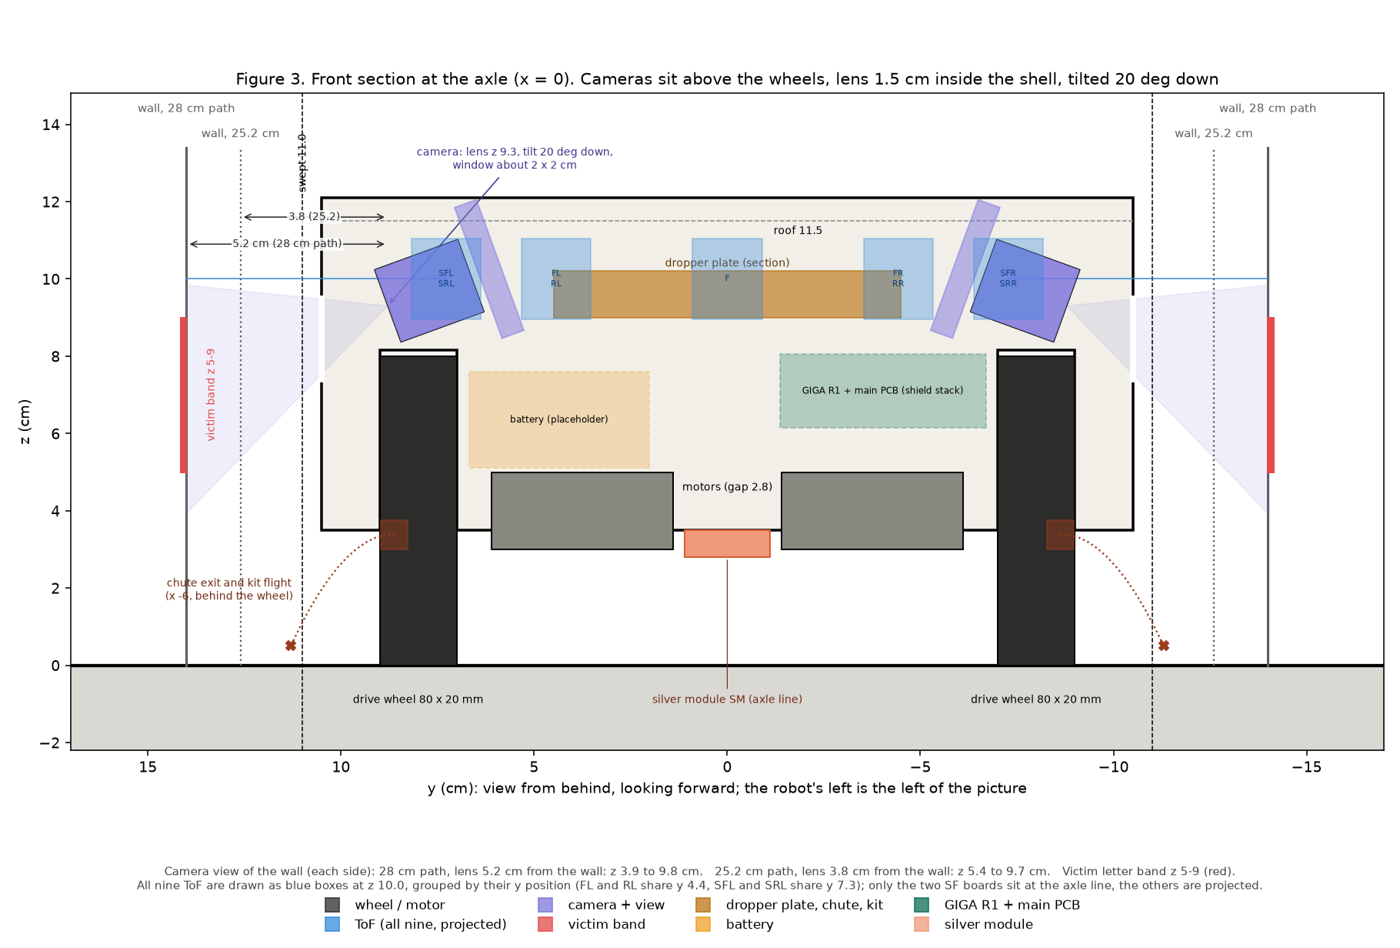
docs/superpowers/specs/v3-figures/fig3_front.png
