Chrisyyyys/Robocup-Junoir-Theseus/docs/superpowers/specs/v3-figures/fig4_plate.png

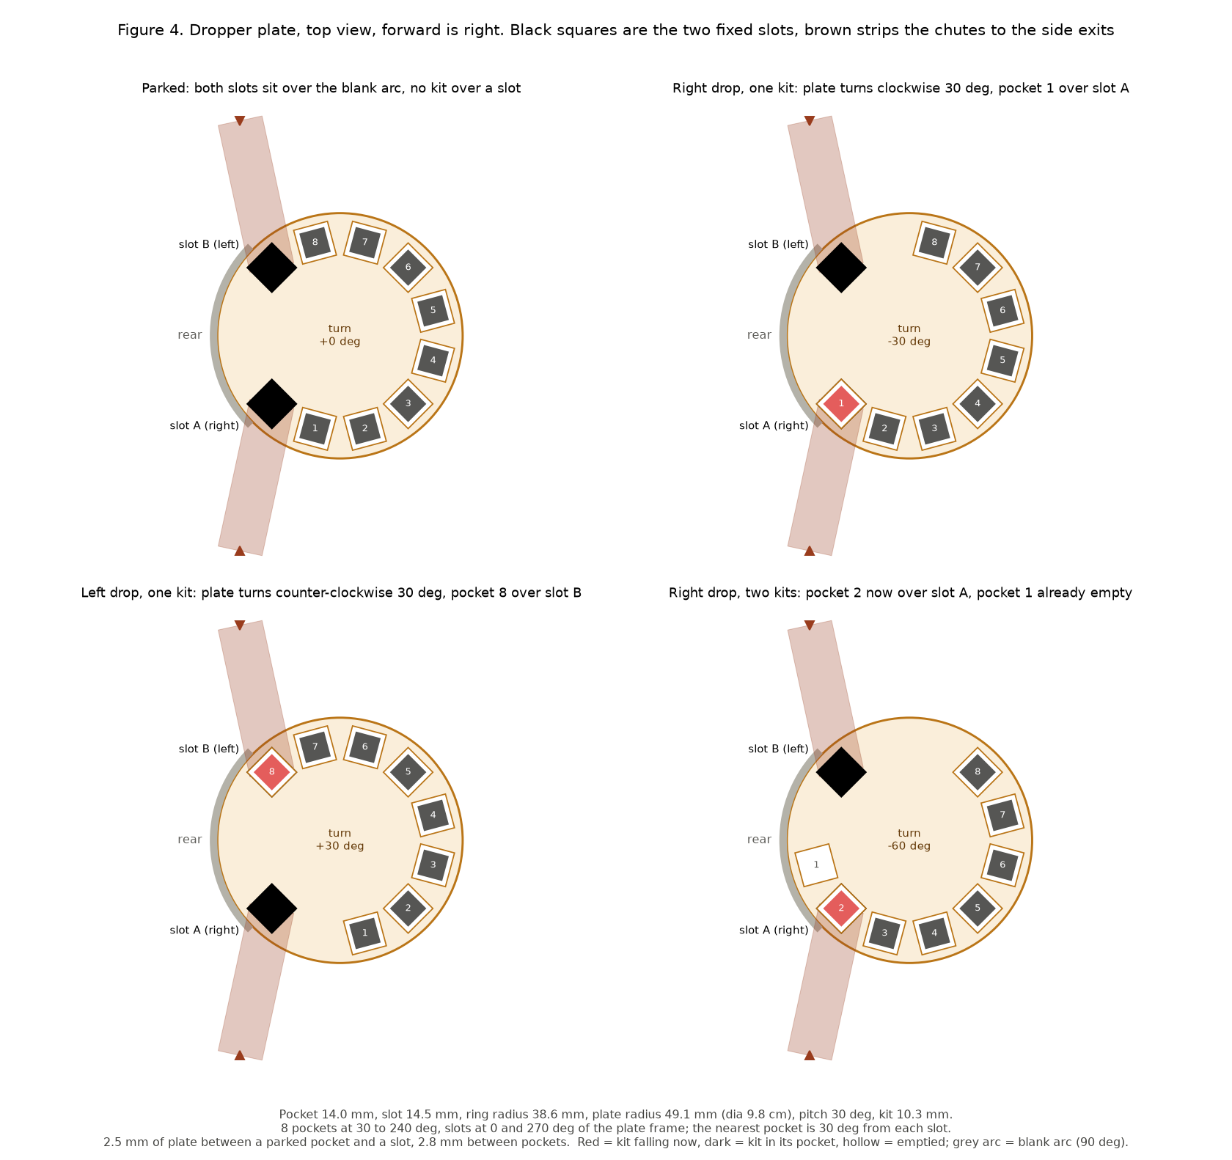
docs/superpowers/specs/v3-figures/fig4_plate.png
