Chrisyyyys/Robocup-Junoir-Theseus/docs/superpowers/specs/v3-figures/fig5_terrain.png

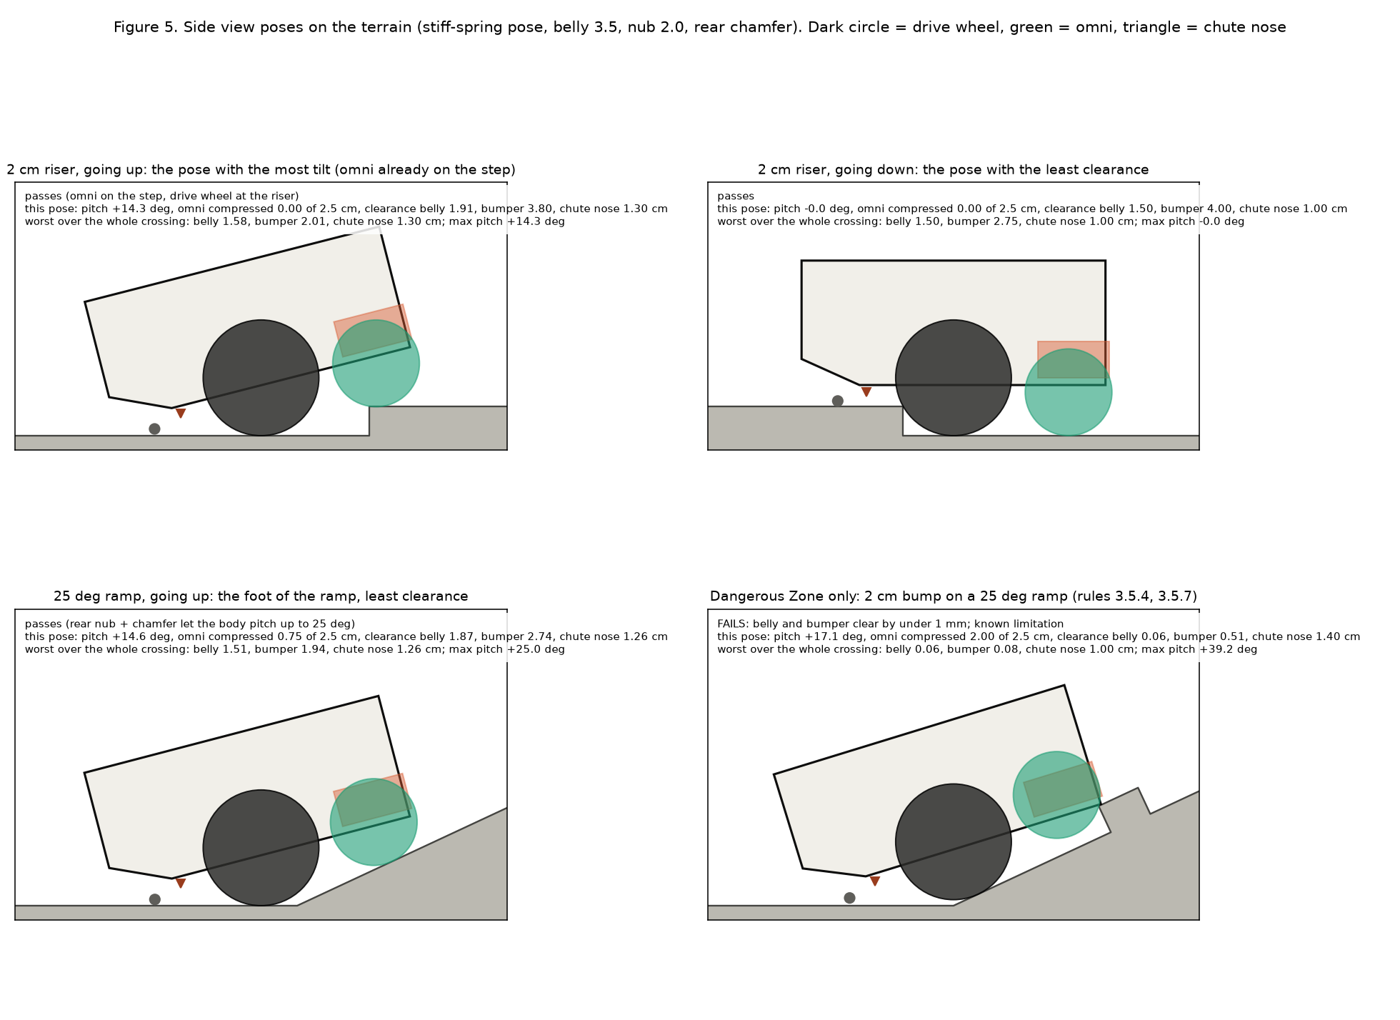
docs/superpowers/specs/v3-figures/fig5_terrain.png
