Chrisyyyys/Robocup-Junoir-Theseus/docs/superpowers/specs/v3-figures/fig6_sensors.png

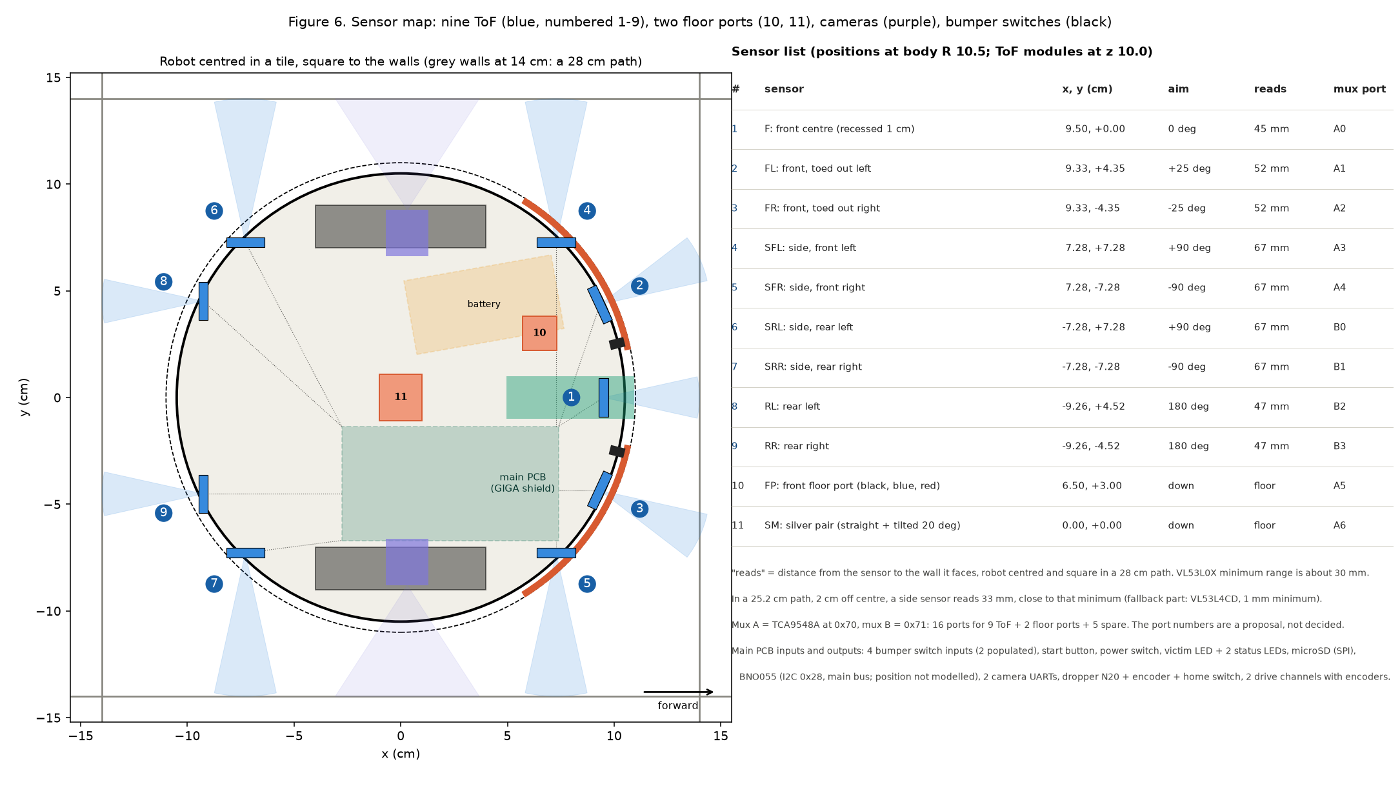
docs/superpowers/specs/v3-figures/fig6_sensors.png
