Chrisyyyys/Robocup-Junoir-Theseus/docs/superpowers/specs/v3-figures/fig7_structure.png

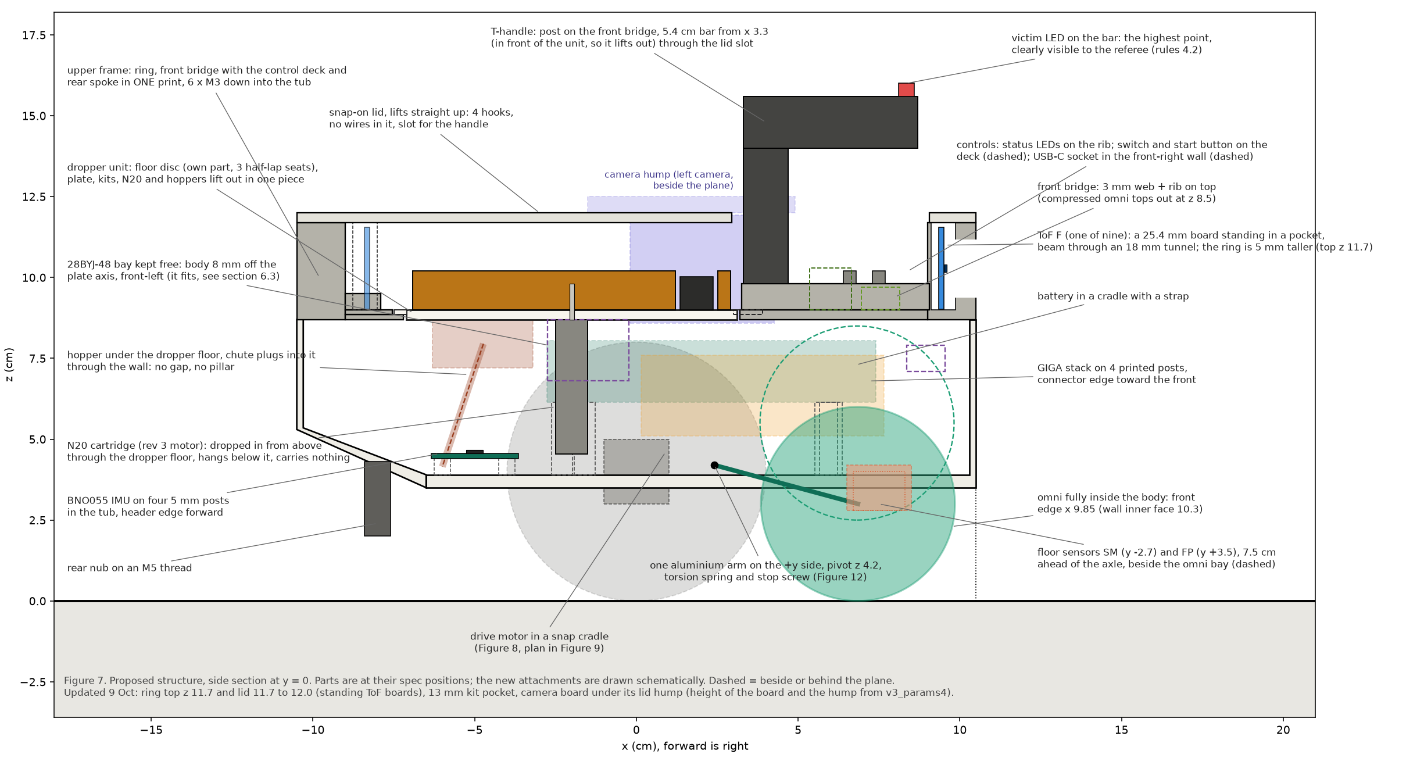
docs/superpowers/specs/v3-figures/fig7_structure.png
