Chrisyyyys/Robocup-Junoir-Theseus/docs/superpowers/specs/v3-figures/fig8_motor_clip.png

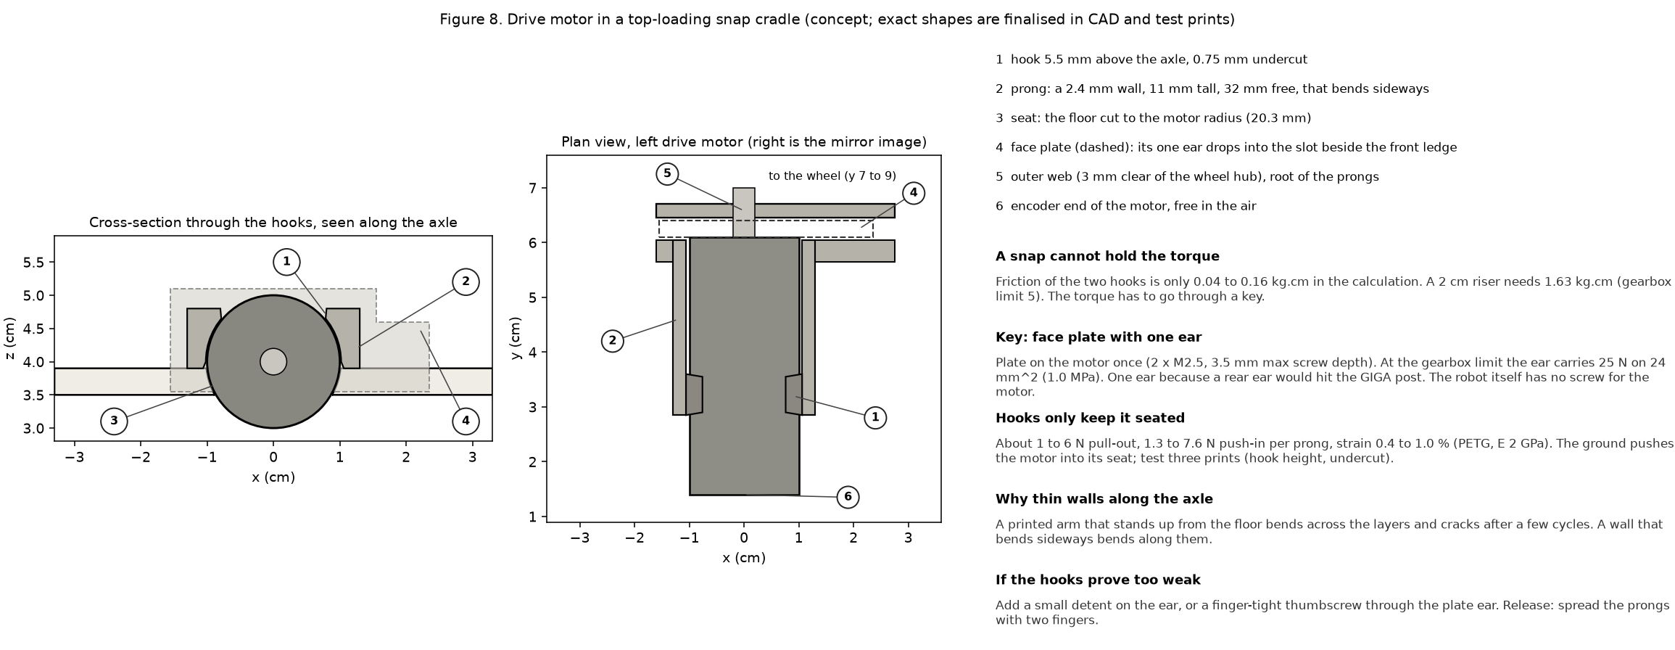
docs/superpowers/specs/v3-figures/fig8_motor_clip.png
