Chrisyyyys/Robocup-Junoir-Theseus/docs/superpowers/specs/v3-figures/fig9_mounting.png

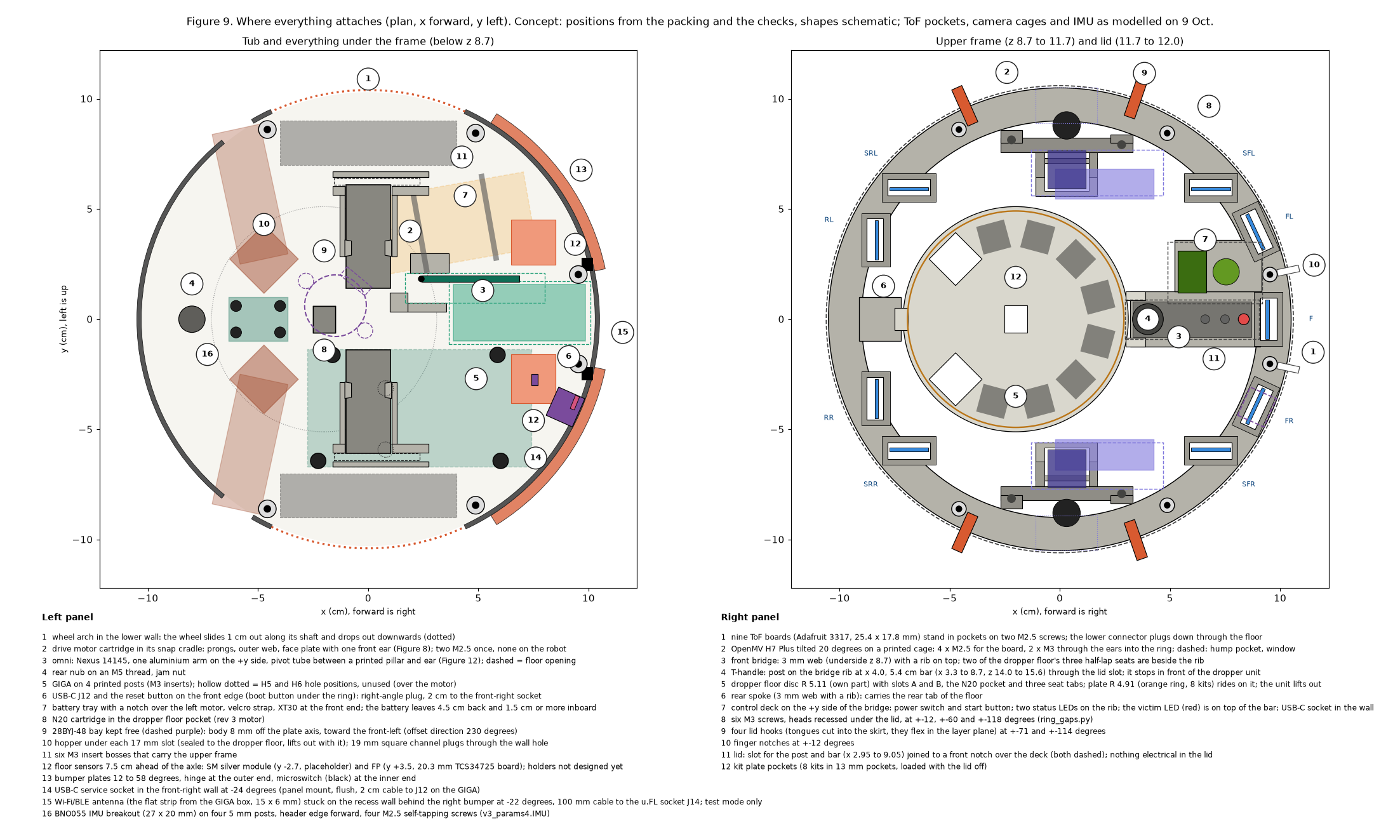
docs/superpowers/specs/v3-figures/fig9_mounting.png
