Chrisyyyys/Robocup-Junoir-Theseus/docs/superpowers/specs/v3-figures/fig10_tof_mount.png

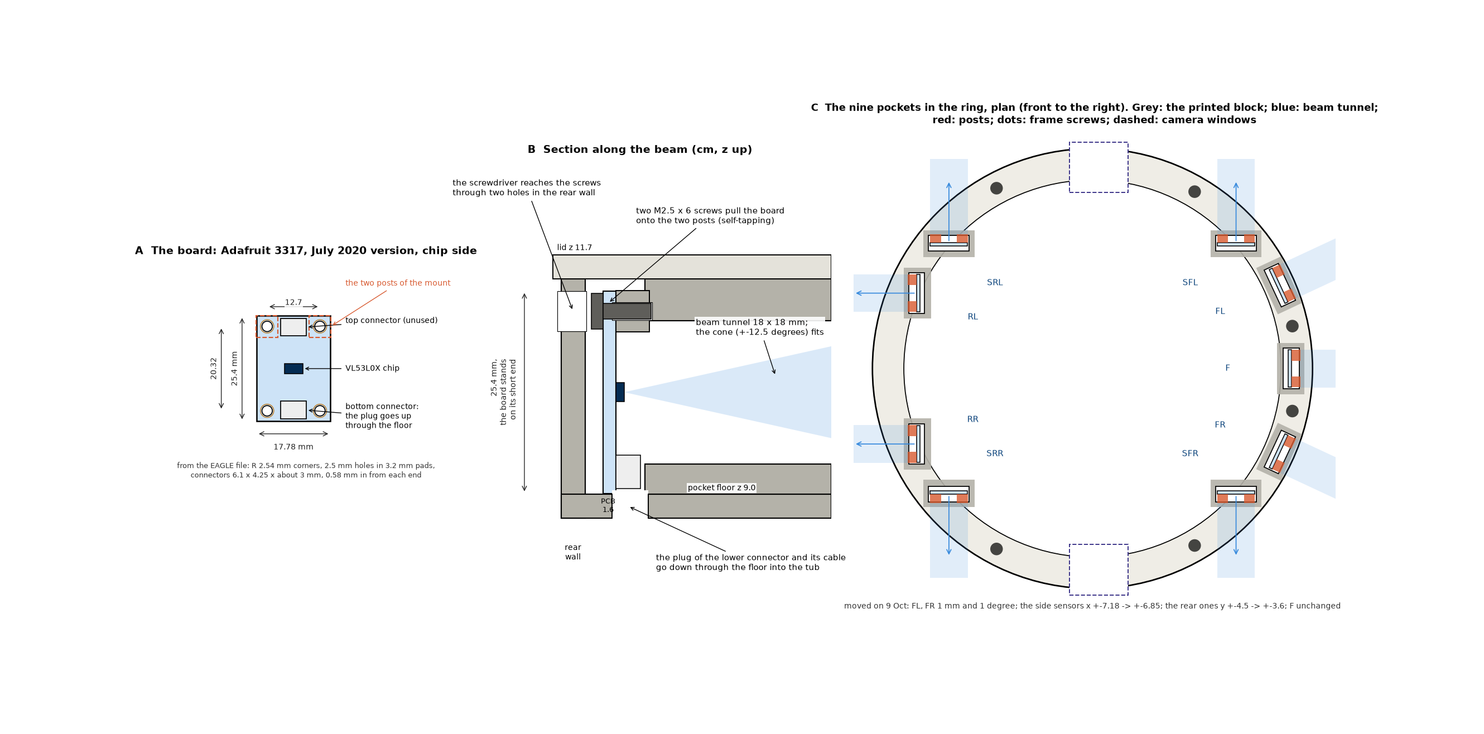
docs/superpowers/specs/v3-figures/fig10_tof_mount.png
