Chrisyyyys/Robocup-Junoir-Theseus/docs/superpowers/specs/v3-figures/fig12_omni_mount.png

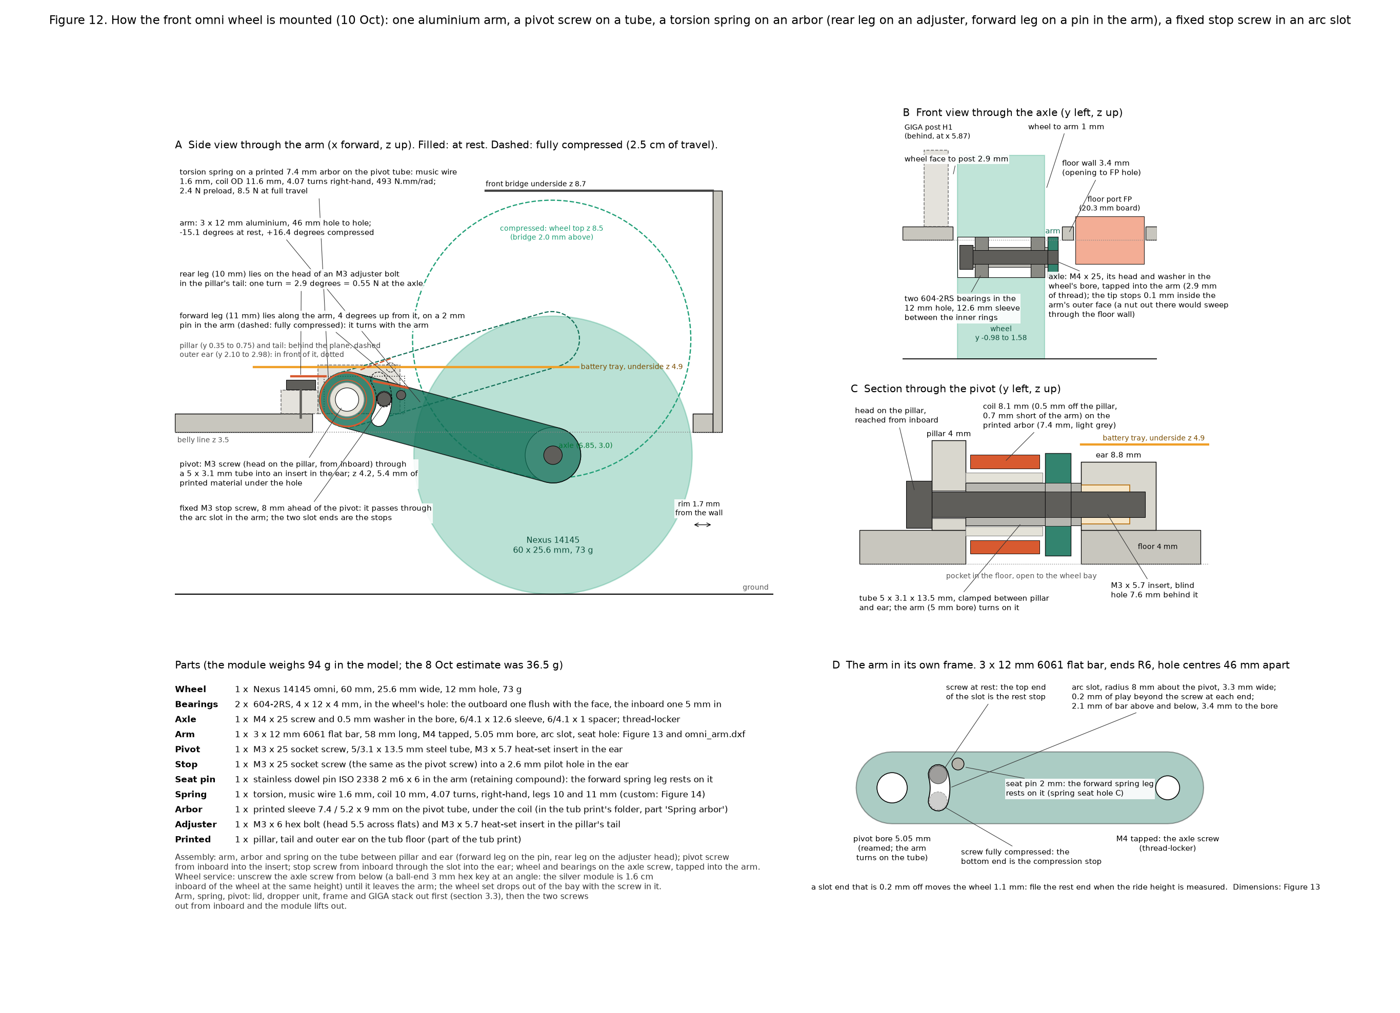
docs/superpowers/specs/v3-figures/fig12_omni_mount.png
