Chrisyyyys/Robocup-Junoir-Theseus/docs/superpowers/specs/v3-figures/fig13_omni_arm.png

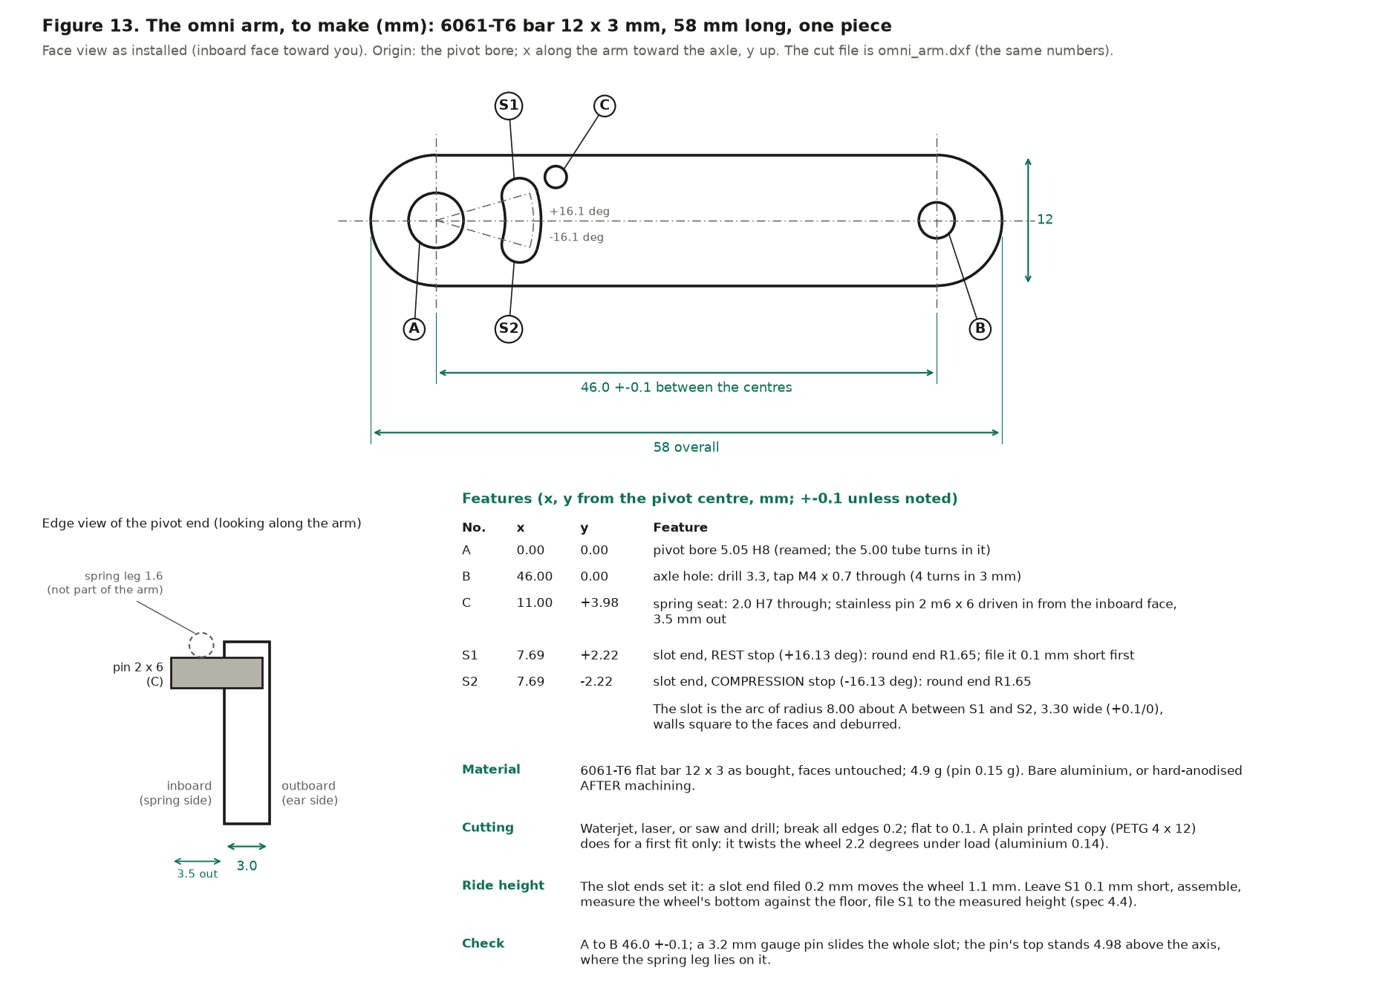
docs/superpowers/specs/v3-figures/fig13_omni_arm.png
