Chrisyyyys/Robocup-Junoir-Theseus/docs/superpowers/specs/v3-figures/fig14_omni_spring.png

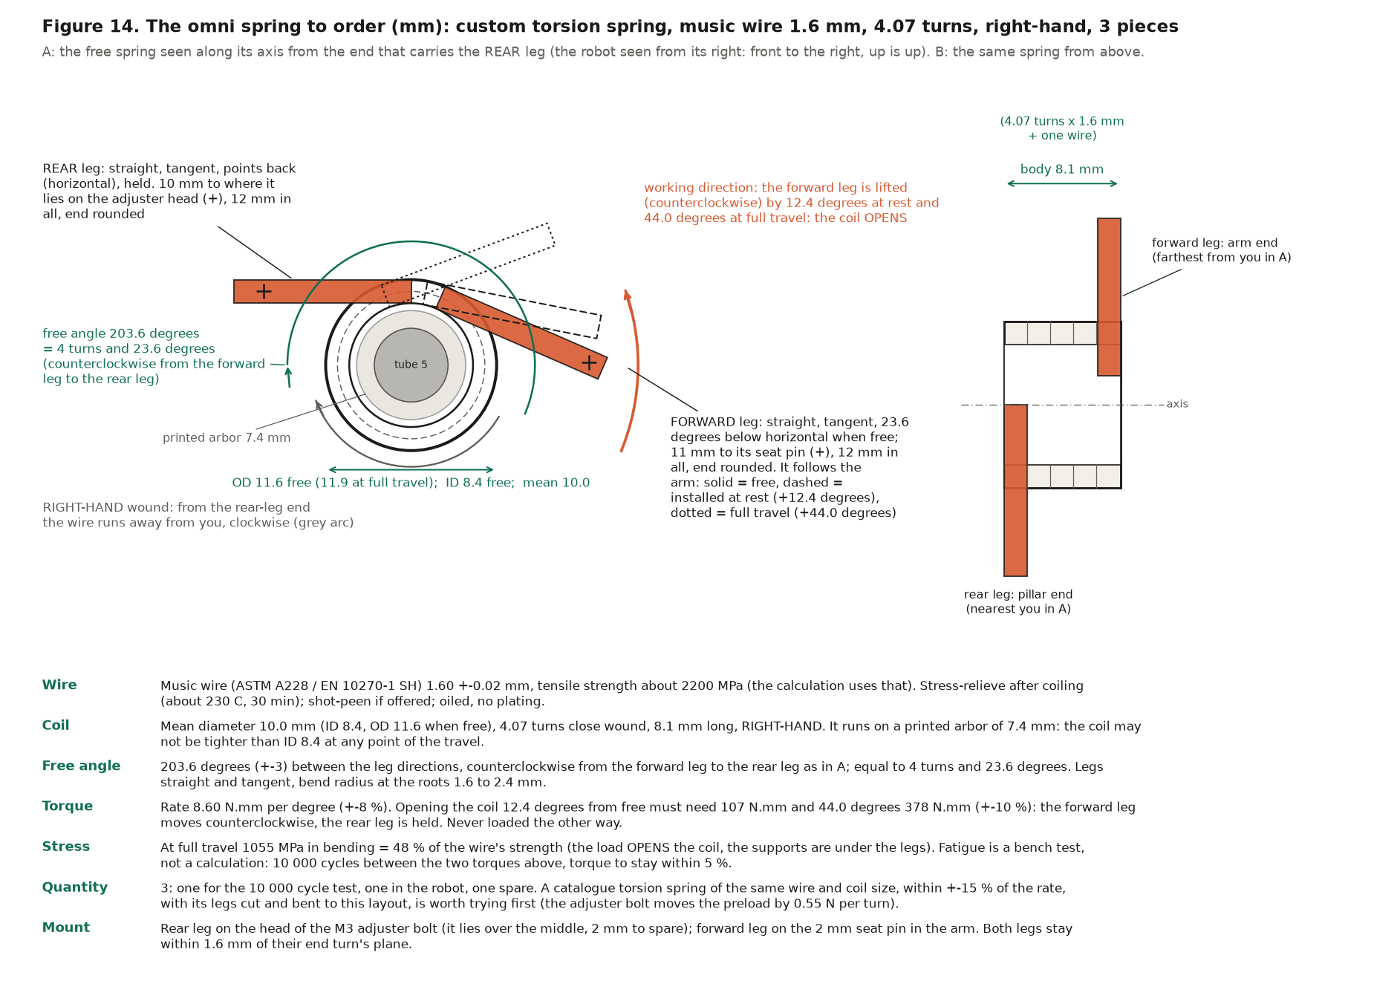
docs/superpowers/specs/v3-figures/fig14_omni_spring.png
