Chrisyyyys/Robocup-Junoir-Theseus/docs/superpowers/specs/v3-fusion/views/fusion_side.png

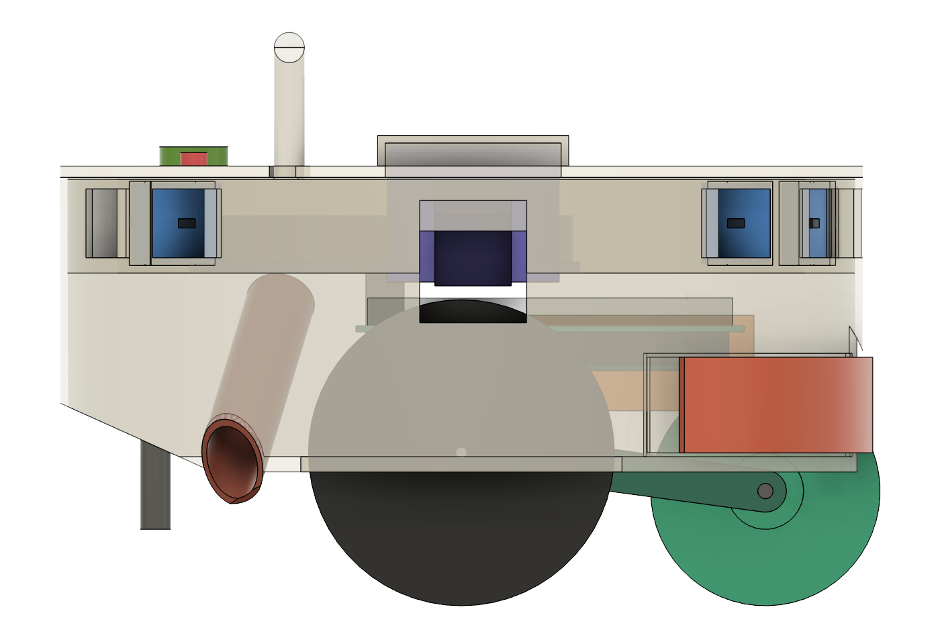
docs/superpowers/specs/v3-fusion/views/fusion_side.png
