Chrisyyyys/Robocup-Junoir-Theseus/docs/superpowers/specs/v3-fusion/views/fusion_top_lid_off.png

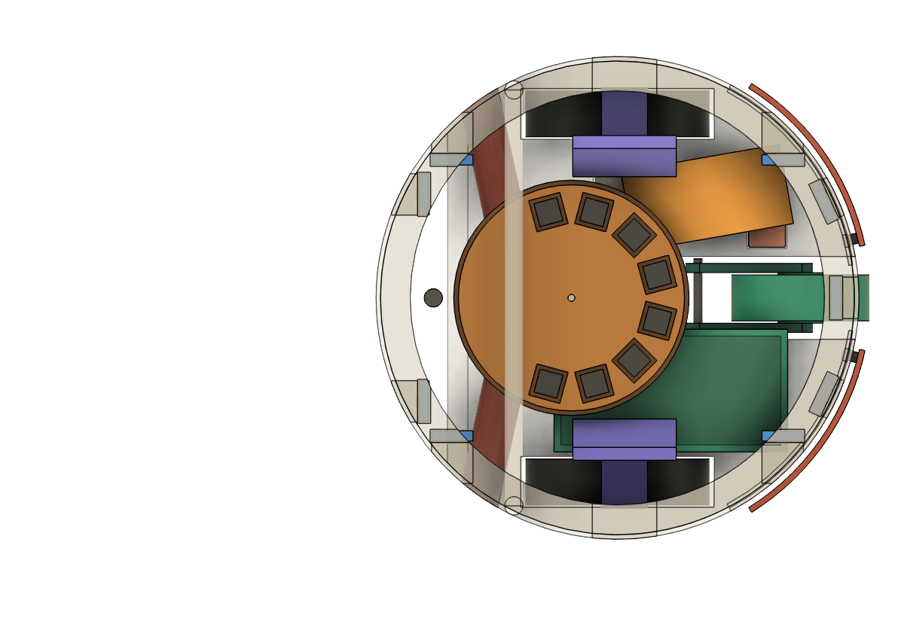
docs/superpowers/specs/v3-fusion/views/fusion_top_lid_off.png
