Chrisyyyys/Robocup-Junoir-Theseus/docs/superpowers/specs/v3-fusion/views/fusion_underside.png

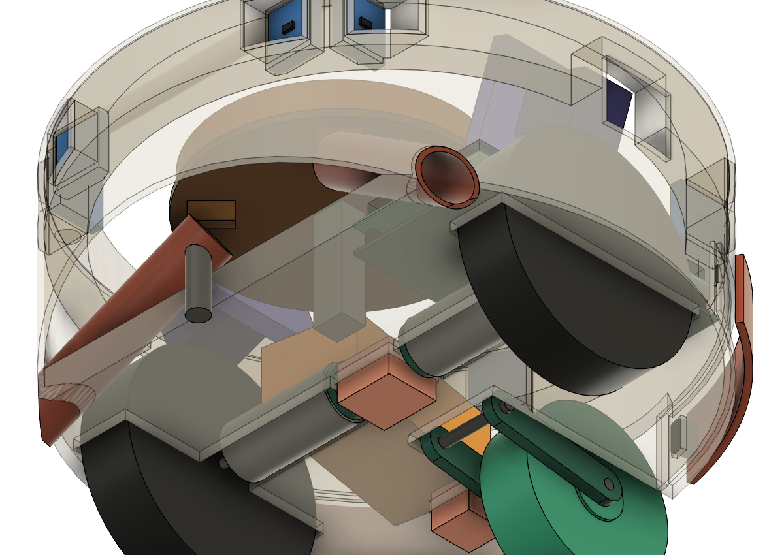
docs/superpowers/specs/v3-fusion/views/fusion_underside.png
