Chrisyyyys/Robocup-Junoir-Theseus/docs/superpowers/specs/v3-fusion/views/rev4_iso.png

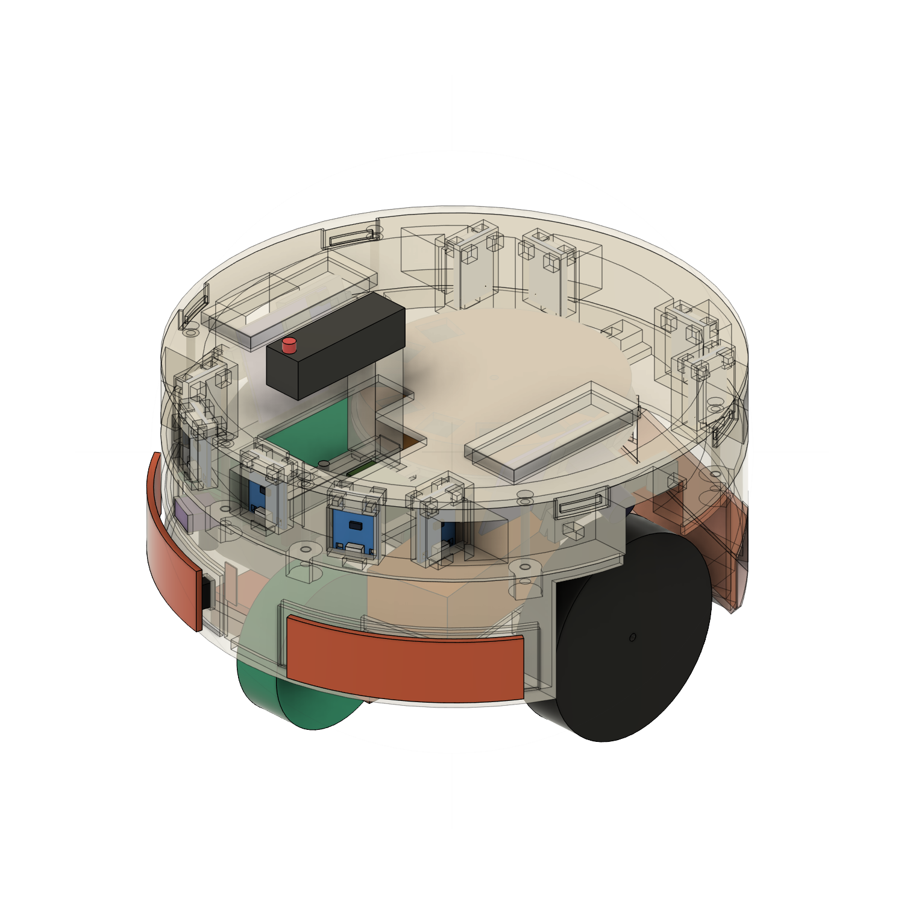
docs/superpowers/specs/v3-fusion/views/rev4_iso.png
