Chrisyyyys/Robocup-Junoir-Theseus/docs/superpowers/specs/v3-fusion/views/rev4_omni_mount.png

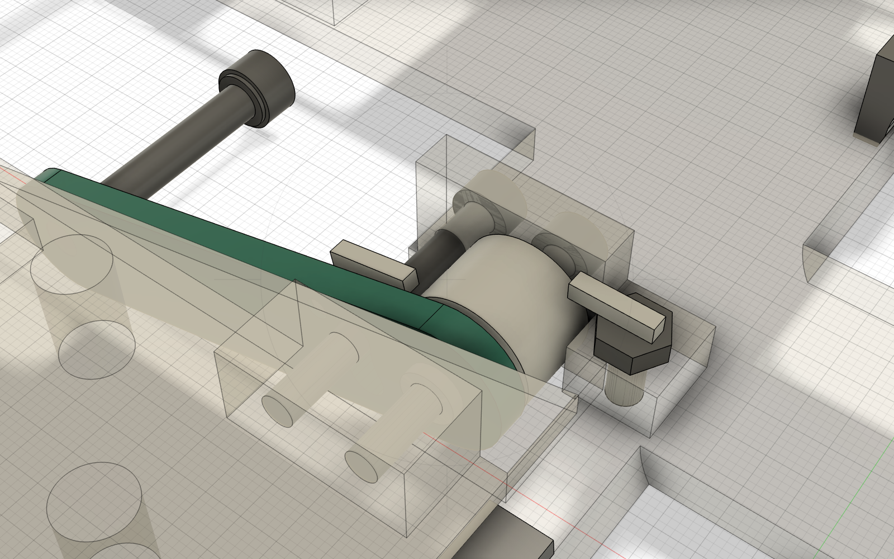
docs/superpowers/specs/v3-fusion/views/rev4_omni_mount.png
