Chrisyyyys/Robocup-Junoir-Theseus/docs/superpowers/specs/v3-fusion/views/rev4_side.png

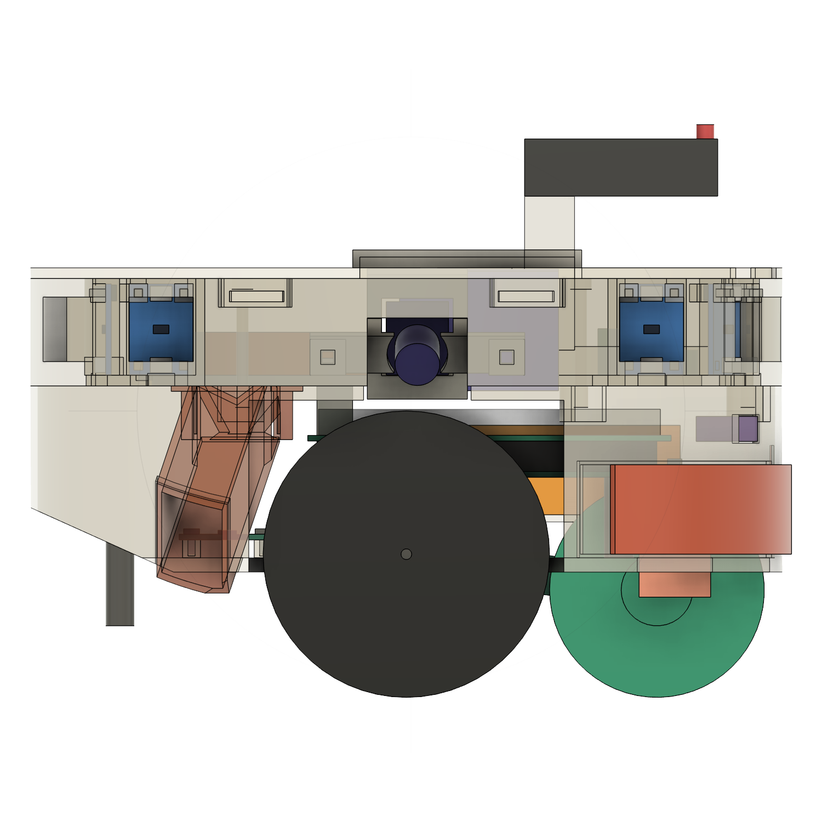
docs/superpowers/specs/v3-fusion/views/rev4_side.png
