Chrisyyyys/Robocup-Junoir-Theseus/docs/superpowers/specs/v3-figures/omni_arm.dxf

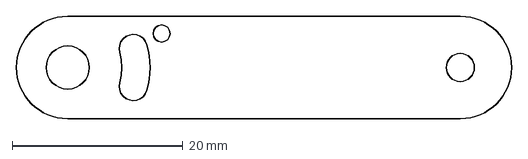
[picture p24: CAD file, 2026-10-10]
docs/superpowers/specs/v3-figures/omni_arm.dxf
58.0 x 12.0 mm
