Chrisyyyys/Robocup-Junoir-Theseus/(list of files, cad)

Other CAD files:
docs/superpowers/specs/v3-fusion/Theseus_V3_baseline.f3d
docs/superpowers/specs/v3-fusion/Theseus_V3_rev4.f3d
