Chrisyyyys/Robocup-Junoir-Theseus/docs/superpowers/specs/v3-figures/fig11_camera_measure.png

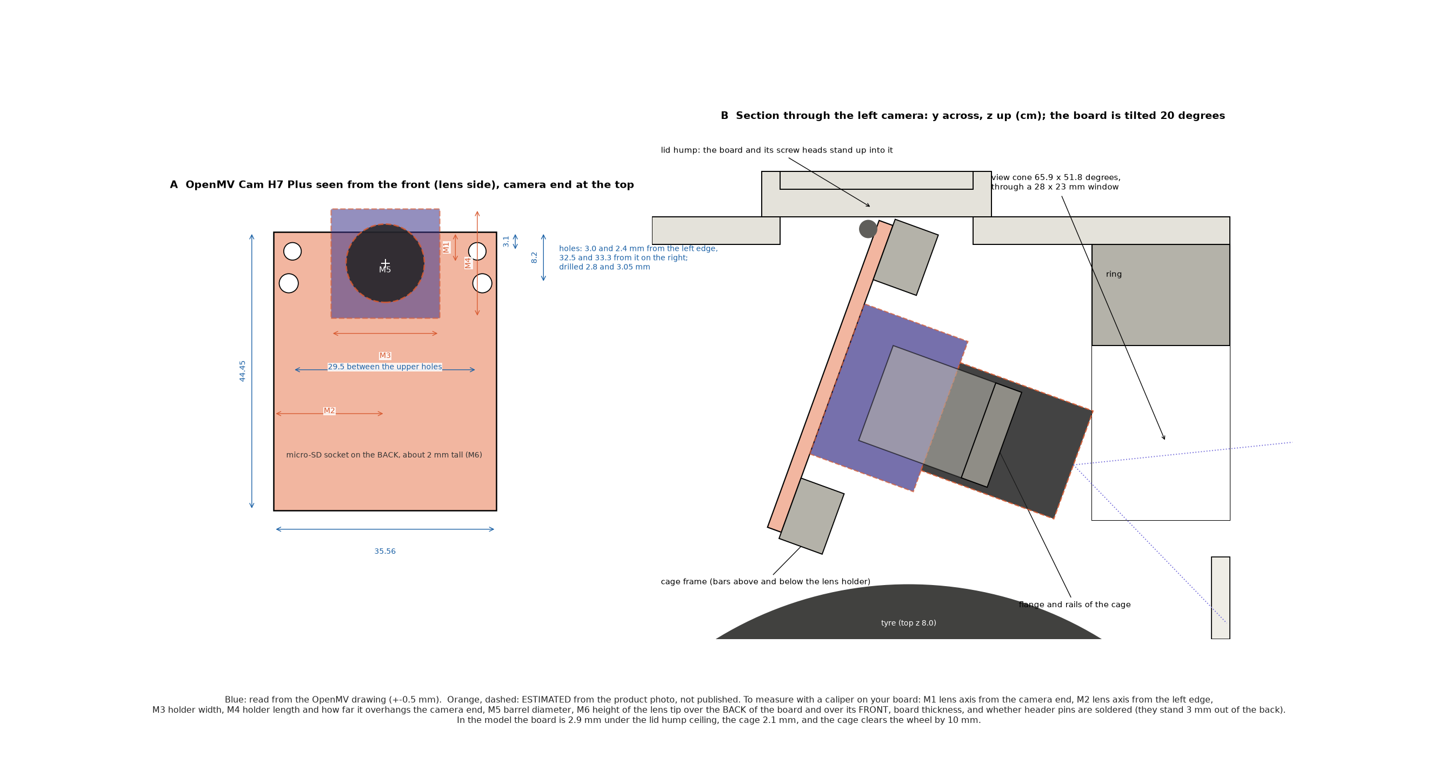
docs/superpowers/specs/v3-figures/fig11_camera_measure.png
