Chrisyyyys/Robocup-Junoir-Theseus/Main/Main.ino

#include <mbed.h> // access arduino mbed OS (rtos::Thread)
#include <Wire.h>
#include <SparkFun_I2C_Mux_Arduino_Library.h>
#include <VL53L0X.h>
#include "Adafruit_TCS34725.h"
#include <Adafruit_MotorShield.h>
#include <Adafruit_Sensor.h>
#include <Adafruit_BNO055.h>
#include <utility/imumaths.h>

#include <Stepper.h>
#include <LiquidCrystal.h> // lcd screen
#include <array> // std::array (Grid type for multi-floor maps)
#include <deque>
#include <vector>
#include <utility>

#include <ArduinoQueue.h> // queue
#include <Vector.h> // vector
#include "PID.h"
#include "timer.h"
#include "gyro.h"
#include "dispenser.h"
#include "motors.h"
// movement constants
#define MIN_DIST 120         // mm (tune this)
#define FRONT_WALL_MAX_MM 200 // a front wall in the current tile is never further than this; the next tile's is >= 360 mm away
#define OBSTACLE_DIST 90
#define MOVE_TIMEOUT_MS 7000    // ms of driving after which a move counts as stuck (a tile takes about 3.6 s, 99% under 4.6 s, a move pinned against a wall 8 s and more; standing still, e.g. for a victim, is not counted). Calibrate on the robot with the ms= field of the [MOVE] result line.
#define MOVE_STUCK_LIMIT 3      // stuck stops in a row after which the stuck check switches itself off: with a timeout that is too short for this robot every move would be cut off
#define OBSTACLE_STOP_MM 60       // mm; while driving, a front sensor reading under this that is not the far wall of the tile is an obstacle: stop before touching it. Keep it BELOW the smallest reading seen at the foot of a ramp (beam height / tan(ramp angle): about 227 mm for 25 degrees with the V2 robot's front sensors, about 106 mm above the floor), or ramps get blocked. Calibrate on the robot.
#define TILE_MM 300         // one tile = 300mm (RCJ tile)
// Robot geometry of the V2 robot, read from the CAD in github.com/Arsur24/Theseus (Fusion archive V2.f3z: chassis plates 195 x 138 mm, wheels and side-sensor tabs out to +-90.2 mm,
// 7 VL53L0X mounting-hole patterns; Mechanical/Sprint1.md: 195 mm chassis, 80 mm wheels). Not measured on the robot: check these against it (docs: test plan, step 0).
#define WALL_THICK_MM 20          // mm, rules 2026 3.3.3: the free path between two opposite walls is 28 cm
#define ROBOT_LENGTH_MM 195       // mm, robot front-to-back length (chassis)
#define ROBOT_WIDTH_MM 180        // mm, robot left-right width over the wheels (their outer faces are at +-90.2 mm; the chassis plates are 138 mm wide)
#define TOF_FRONT_FWD_MM 97.5     // mm, how far ahead of the body centre the front sensors (1 and 7, at x = +-80 mm) sit: on the front face
#define TOF_SIDE_OUT_MM 90.2      // mm, how far to the side of the body centre the side sensors (2, 3, 5 and 6) sit: flush with the wheels' outer faces
#define HALF_PATH_MM ((TILE_MM - WALL_THICK_MM) / 2.0) // mm, from the tile centre to the face of a wall (140)
#define FRONT_GAP_AT_CENTER_MM ((int)(HALF_PATH_MM - TOF_FRONT_FWD_MM)) // mm, what the front sensors read at the tile centre facing a wall (42)
#define TARGET_GAP_MM (HALF_PATH_MM - TOF_FRONT_FWD_MM) // mm, ideal front/back sensor reading when centered (42.5)
#define CENTER_TOL_MM 10                                          // mm, front-back centering tolerance
#define FWD_TRIM_MM 19 // mm added to every fwd() target. fwd() stops 12 mm early (Scale*120 < 25) and wheel slip costs a few mm more, so a move asked for one tile ends ~19 mm short in the simulator and nothing makes it up. Measure on the robot: ten fwd(TILE_MM) on a flat floor, FWD_TRIM_MM = (3000 - distance driven) / 10
#define MAX_CENTER_CORRECTION_MM 300.0                            // mm, one tile — offset this large means an unreliable reading or the robot isn't really in-tile; skip/abort centering
#define TARGET_SIDE_GAP_MM (HALF_PATH_MM - TOF_SIDE_OUT_MM)         // mm, ideal side sensor reading when centered (49.8)
#define SIDE_WALL_MAX_MM 200                                        // mm; a side reading beyond this is the next tile through a gap, not this tile's wall
// Turning in place swings the corners of the body around a circle of TURN_SWEEP_MM radius. In a 28 cm path that leaves only
// HALF_PATH_MM - TURN_SWEEP_MM of slack on each side (7 mm for the V2 robot), so the robot has to be centred before it turns, along the
// path (a front or back wall) as well as across it. The two limits below are what the distance sensors read when the corners have
// TURN_MARGIN_MM of room left: a reading under them means the turn would stall against that wall.
#define TURN_SWEEP_MM (sqrt((double)ROBOT_LENGTH_MM * ROBOT_LENGTH_MM + (double)ROBOT_WIDTH_MM * ROBOT_WIDTH_MM) / 2.0) // mm, 132.7 for 195 x 180
#define TURN_MARGIN_MM 3.0      // mm, room to keep between a swinging corner and the wall (sensor noise is about 3 mm)
#define TURN_SIDE_GAP_MIN_MM ((int)(TURN_SWEEP_MM - TOF_SIDE_OUT_MM + TURN_MARGIN_MM))  // mm, side-sensor reading needed before turning in place (45)
#define TURN_END_GAP_MIN_MM ((int)(TURN_SWEEP_MM - TOF_FRONT_FWD_MM + TURN_MARGIN_MM))  // mm, front or back sensor reading needed before turning in place (38)
#define BOTCH_BACKOFF_MM 45     // mm, how far the robot backs off after a failed turn the sensors saw no reason for
#define NUDGE_STOP_GAP_MM 32    // mm, a shift along the path stops when a front or back sensor reads this (the VL53L0X cannot measure under 30 mm)
#define NUDGE_ANGLE_DEG 9.0     // deg, how far the robot points away from the wall while shifting sideways
#define NUDGE_MIN_LEG_MM 20.0   // mm, shortest and longest leg of a sideways shift: a leg of L mm shifts the robot by 2 * L * sin(NUDGE_ANGLE_DEG)
#define NUDGE_MAX_LEG_MM 130.0
#define LATERAL_TOL_MM 15                                            // mm, lateral correction tolerance (looser than CENTER_TOL_MM)
#define MAX_LATERAL_OFFSET_MM 90.0                                   // mm, sanity cap — offset this large means an unreliable reading; skip
#define LATERAL_CORRECTION_GAIN 1                                // multiplier on the computed turn angle; bench-tune upward since fwd() partially fights the pre-turn (pulls back toward cardinal)
#define BLACK_THRESHOLD 0.1f // color clear-channel threshold ratio for black
#define SILVER_THRESHOLD 800 // use red value
#define WHITE_THRESHOLD 0.85f
#define MULTIPLER 1.1
#define WALL_MISMATCH_THRESHOLD 2 // >= this many of the 4 absolute walls disagreeing with the stored tile flags a position mismatch
#define HEADING_SYNC_MAX_DEG 20.0      // re-zero the gyro on a wall only if it already agrees this closely (same as the turn check)
#define HEADING_SYNC_RECOVERY_DEG 40.0 // wider window right after snapping to the nearest axis (turn recovery, LoP resume)
#define PARALLEL_RECOVERY_TIMEOUT_MS 1500 // squaring time on those paths (normal parallel() gets 500 ms)
// Serial output. 0 = quiet: the tagged lines the test plan reads ([WALLS], [PLAN], [TURN],
// [SYNC], [MOVE], ...) and one-off events. 1 = also the per-loop traces (distance travelled,
// raw colour readings, [CENTER], ramp climbing, detour steps, camera samples).
#define VERBOSE_DEBUG 0

#define TARGET_WALL_DISTANCE 80
float clear; 

#include "MazeTile.h"

// set up mux and distance senosrs
VL53L0X sensors[7];
QWIICMUX myMux;
// shut down allcall
#define PCA_ADDR 0x60
#define MODE1    0x00
#define ALLCALL_BIT 0x01  // MODE1 bit0

// set up color sensor
#define TCS_PORT 7
Adafruit_TCS34725 tcs = Adafruit_TCS34725(TCS34725_INTEGRATIONTIME_24MS, TCS34725_GAIN_1X);
// set up gyro
Adafruit_BNO055 bno = Adafruit_BNO055(55, 0x28);
gyro myGyro;
// set up motorshield and motors.
Adafruit_MotorShield AFMS = Adafruit_MotorShield(); 
Adafruit_DCMotor *motorA = AFMS.getMotor(1);
Adafruit_DCMotor *motorB = AFMS.getMotor(2);
Adafruit_DCMotor *motorC = AFMS.getMotor(3);
Adafruit_DCMotor *motorD = AFMS.getMotor(4);

// set up encoder pins
const int encoderPin_A_A = 3;
const int encoderPin_A_B = 5; 
const int encoderPin_B_A = 2;
const int encoderPin_B_B = 4; 
const int encoderPin_D_A = 18;
const int encoderPin_D_B = 19;


//drivetrain class object
motors drivetrain(encoderPin_A_A,encoderPin_A_B,encoderPin_B_A,encoderPin_B_B,encoderPin_D_A,encoderPin_D_B);
// wheel cpr
const double wheel_cpr = 5; // 20/4
//gear ratio
const double gear_ratio = 195;
// wheel diameter
const double wheel_diameter = 80; // millimeters.
// detection classes

char classes[6] = {'H','S','U','R','Y','G'};

// create stepper object
const int steps_per_revolution = 2048;
Stepper myStepper = Stepper(steps_per_revolution, 8, 9,10,11); 
// create lcd object
int en = 25; int rs = 27; int d4 = 23; int d5 = 53; int d6 = 29; int d7 = 31;
LiquidCrystal lcd(rs, en, d4, d5, d6, d7);
// map grids 
// MAP_SIZE and grid are defined here
const int MAP_SIZE = 40;
using Grid = std::array<std::array<Tile, MAP_SIZE>, MAP_SIZE>;
Grid mapGrid; // active floor's tiles
Grid m1;      // floor storage ("basement"/floor 0)
Grid m2;      // floor 1
Grid m3;      // floor 2

int currentFloor = 0; // current floor (0..2) for elevation()/descend()
int LEDPIN = 51;


//states that the robot will be in
enum RobotState {
  WAIT_START,
  SENSE_TILE,
  CENTERING,
  UPDATE_MAP,
  PLAN_NEXT,
  VICTIM_DETECT,
  EXECUTE_MOVE,
  BOTCHED_TURN_RECOVERY,
  BOTCHED_FWD_RECOVERY,
  BACKPEDAL,
  PAUSE,
  RETURN
};
// Outcome of fwd(). Only MOVE_OK means the robot actually reached the next tile.
enum MoveResult {
  MOVE_OK,      // reached the next tile (directly or through an obstacle detour)
  MOVE_BLOCKED, // stopped short of the next tile; still in the current one
  MOVE_BLACK,   // black tile ahead; backed off to where the move started
  MOVE_PAUSED   // the logic switch paused the move
};
enum Steps {
  TURN,
  PARALLEL,
  BACKTRACK,
  WIGGLE,
  FWD
};
// coord struct
struct coord {
  int x;
  int y;
};
Steps steps = TURN;

// initialize 

Direction currentDir = NORTH;     // robot heading in map coords (0..3)
int plannedTurnDeg = 0;           // -90,0,+90,180
Direction plannedMoveDir = NORTH; // absolute direction robot will move next
bool turnCompletedForMove = false;
// bound BOTCHED_TURN_RECOVERY so a persistently un-completable turn can't cycle forever
int botchedTurnAttempts = 0;
const int MAX_BOTCHED_TURN_ATTEMPTS = 3;
int x_pos = MAP_SIZE/2;
int y_pos = MAP_SIZE/2;
RobotState state = WAIT_START;
// maze return to start condition variables
int medkits = 8;
timer mazeTime;
// blue toggle (black tiles are reported by fwd()'s MOVE_BLACK result)
bool bluetoggle = false;
bool stairtoggle = false;
// obstacle toggle
bool obstacle = false;
// victim toggles
bool victimtoggle = false;
bool victimAtCurrent = false;
// camera GPIOs
const int gpio1 = 13;
const int gpio2 = 12;
// stepper variables
const int angle_offset = 44;
const int angle_increment = 22;
dispenser disp(angle_increment,angle_offset,steps_per_revolution);
// logic switch pin
const int logicswitch = 22;
volatile bool Pausemaze = false; // set by pauseThread, read by loop()
bool startArmed = false; // logic switch seen at PAUSE since power-on (WAIT_START needs PAUSE -> RUN)
int x_checkpoint = MAP_SIZE/2, y_checkpoint = MAP_SIZE/2;
int floor_checkpoint = 0; // floor the last checkpoint was recorded on (0..2)
bool tilecheck = false;
bool fwdSoftFail = false;           // set by fwd() when a move failed in a way that may be the robot's own pose or driving, not a thing in the way
bool softFailPending = false;       // a soft failure happened and its edge has not been tried again yet
int softFailX = 0, softFailY = 0;   // the edge it happened on: tile and direction
Direction softFailDir = NORTH;
int stuckStreak = 0;                // stuck stops in a row (any normal move resets it)
bool stuckCheckOff = false;         // set after MOVE_STUCK_LIMIT of them in a row: MOVE_TIMEOUT_MS is probably too short for this robot

// Forward declaration: Arduino can't auto-prototype template return types.
std::deque<std::pair<int, std::pair<int,int>>> BFS(std::pair<int, std::pair<int,int>> currentpos, Grid& m1, Grid& m2, Grid& m3, std::pair<int, std::pair<int,int>> endpos, bool allowBlue = false, bool allowObstacle = false);

double headingErrorDeg(double targetDeg, double actualDeg) {
  double err = targetDeg - actualDeg;
  while (err > 180.0) err -= 360.0;
  while (err < -180.0) err += 360.0;
  return abs(err);
}

// ===== camera victim-detection RTOS thread =====
// The thread only checks the camera UARTs (Serial3 = left, Serial2 = right).
// -> It never touches the I2C bus (mux/distance/color) so it cannot interfere w/ the main context's measure()/detectWall() calls. 

// When a camera reports a letter while the robot is moving, the thread raises victimPending; fwd()/absoluteturn()
// then stop the drivetrain, pause their PID + timer, run detectCam(), and use markVictimAtEncoderPosition() to label the correct tile before resuming.

volatile bool fwdActive = false; // true only while inside fwd()
volatile bool turnActive = false;
volatile bool victimPending = false; // a camera reported -> movement must service it
volatile bool victimAck = false;     // fwd()/absoluteturn() set it once the wheels are stopped for a victim; the camera thread waits for it
volatile int  victimSide = 0;        // 1 = left (Serial3), 2 = right (Serial2)
volatile bool isVictim = false;      // a victim already handled during current move

// Called by the camera thread after it raised victimPending. True once the movement code has stopped the wheels. False after 300 ms:
// the move ended meanwhile and nobody will stop, so the victim is skipped (the camera reports it again).
bool waitForVictimStop(){
  for(int i = 0; i < 60 && !victimAck; i++) rtos::ThisThread::sleep_for(std::chrono::milliseconds(5));
  return victimAck;
}

rtos::Thread cameraThread;
rtos::Mutex i2cMutex;
rtos::Mutex lcdMutex; // lcd mutex to prevent conflict
void cameraTask(){
  while(true){
    int encoderCount = (drivetrain.encoderCountA+drivetrain.encoderCountB+drivetrain.encoderCountD)/3;
    int nx = x_pos; int ny=y_pos;
    if((fwdActive||turnActive) && !victimPending && !isVictim){
      
      //if(encoderCount>=0.3*pulsesForDistanceMm(TILE_MM)||encoderCount<=0.7*pulsesForDistanceMm(TILE_MM)){
        if(readSerial1() != -1){        // left camera (Serial4)
          if(fwdActive) victimTileFromEncoder(TILE_MM,encoderCount,nx,ny);
          if(VERBOSE_DEBUG){
            Serial.println("nx, ny");
            Serial.println(nx);
            Serial.println(ny);
            Serial.println(mapGrid[nx][ny].getVictim());
          }
          if(mapGrid[nx][ny].getVictim() == false){
            victimSide = 1;
            victimAck = false;
            i2cMutex.lock();
            drivetrain.fullstop(); // stop at once; the movement code stops too, at its next pass, and acknowledges
            i2cMutex.unlock();
            victimPending = true;
            if(waitForVictimStop()){
              i2cMutex.lock();
              serviceCameraVictim(); // holds the I2C bus for seconds: the wheels must already be stopped
              i2cMutex.unlock();
            }
            else victimPending = false;
          }
        }
        else if(readSerial2() != -1){   // right camera (Serial3)
          if(fwdActive) victimTileFromEncoder(TILE_MM,encoderCount,nx,ny);
          if(VERBOSE_DEBUG){
            Serial.println("nx, ny");
            Serial.println(nx);
            Serial.println(ny);
            Serial.println(mapGrid[nx][ny].getVictim());
          }
          if(mapGrid[nx][ny].getVictim() == false){
            victimSide = 2;
            victimAck = false;
            i2cMutex.lock();
            drivetrain.fullstop(); // stop at once; the movement code stops too, at its next pass, and acknowledges
            i2cMutex.unlock();
            victimPending = true;
            if(waitForVictimStop()){
              i2cMutex.lock();
              serviceCameraVictim(); // holds the I2C bus for seconds: the wheels must already be stopped
              i2cMutex.unlock();
            }
            else victimPending = false;
          }
        }
      }
    rtos::ThisThread::sleep_for(std::chrono::milliseconds(10));
  }
}


// pause maze thread: watches the logic switch and requests a stop.
rtos::Thread pauseThread;
void pauseTask(){
  while(true){
    
    if(digitalRead(logicswitch)==HIGH){
      
      Pausemaze = true;
    }
    else{
      
      Pausemaze = false;
    }
    rtos::ThisThread::sleep_for(std::chrono::milliseconds(10));
  }
}

bool turnCompletedSuccessfully(Direction intendedDir) {
  const double TURN_SUCCESS_TOLERANCE_DEG = 20.0;
  double targetHeading = turnNeededDeg(intendedDir);
  double actualHeading = myGyro.heading();
  double err = headingErrorDeg(targetHeading, actualHeading);
  Serial.print("[CHECK] turn target=");
  Serial.print(targetHeading);
  Serial.print(", actual=");
  Serial.print(actualHeading);
  Serial.print(", err=");
  Serial.print(err);
  Serial.println(err <= TURN_SUCCESS_TOLERANCE_DEG ? ", ok=1" : ", ok=0");
  return err <= TURN_SUCCESS_TOLERANCE_DEG;
}
void setup(){
  // initialize camera gpio pins
  pinMode(gpio1, INPUT);
  pinMode(gpio2, INPUT);
  // initialize logic switch pin
  pinMode(logicswitch, INPUT);
  pinMode(LEDPIN,OUTPUT);
  // begin UART communication.
  Serial.begin(115200);
  Serial3.begin(115200); // switch to 9600 for reliability
  Serial4.begin(115200);
  
  
  Wire.begin();
  disableAllCall();
  myMux.begin();
  init_dist(); // initialize mux before distance sensors.
  // calibrateSensor() reads a sensor, so it may only run after init_dist() has started them.
  // Before, it ran first and froze the robot after a cold power-on. Its result isn't used yet
  // (SENSOR_OFFSET_MM is all zero), so it stays off; turn it on here when calibrating.
  //calibrateSensor(2,80);
  scanAllPorts();
  init_color();
  init_drive();
  //detect();
  //initialize map
  initializeMap(); // initialize mapgrid
  // every floor starts as a copy of the freshly initialized (empty) grid.
  m1 = mapGrid;
  m2 = mapGrid;
  m3 = mapGrid;
  currentFloor = 0;
  x_pos=MAP_SIZE/2;
  y_pos=MAP_SIZE/2;
  mapGrid[x_pos][y_pos].setDiscovered(true);
  currentDir = NORTH;
  state = WAIT_START;
  // start lcd
  lcd.begin(16, 2);
  // start RTOS threads: camera victim detection + pause-switch watcher.
  cameraThread.start(cameraTask);
  cameraThread.set_priority(osPriorityAboveNormal);
  pauseThread.start(pauseTask);
  //Serial.println("starting");
  
  
}
int iterator = 0;
bool returning = false; // set after the move limit: the planner heads for the start tile instead of exploring



void loop(){
  //diagPrintStackUsage();
  
  /*
  for(int i = 1;i<=7;i++){
    Serial.print("sensor ");
    Serial.println(i);
    Serial.println(measure(i));
    delay(500);
  }
  
  */
  
  
  //lcdPrint("working");
  //delay(500);
  //drivetrain.drive(150,150*1.25,150*1.25,150);
  //drivetrain.drive(150,150,150,150);
  
  
  static bool wallF, wallR, wallB, wallL;
  switch (state) {
    case WAIT_START: {
      // Rule 4.2.8: the run is started with the logic switch. Require PAUSE -> RUN, so a
      // robot that powers up with the switch already at RUN doesn't drive off by itself.
      drivetrain.fullstop();
      static unsigned long lastWaitPrintMs = 0;
      if(millis() - lastWaitPrintMs >= 500){ // heading readout for bench checks
        lastWaitPrintMs = millis();
        Serial.print("[WAIT] armed=");
        Serial.print(startArmed ? 1 : 0);
        Serial.print(" heading=");
        Serial.println(myGyro.heading(), 1);
      }
      if(digitalRead(logicswitch) == HIGH){
        startArmed = true; // switch at PAUSE
      }
      else if(startArmed && Pausemaze == false){
        // Maze NORTH is the way the robot faces on the start tile. Square up on a side
        // wall if there is one, then define NORTH again from the squared pose.
        myGyro.setMapHeading(0);
        if(parallel(NORTH)) myGyro.setMapHeading(0);
        currentDir = NORTH;
        Serial.println("[START] run started, heading zeroed to NORTH");
        state = SENSE_TILE; // read the start tile's walls before planning
      }
      delay(20);
      break;
    }
    case SENSE_TILE: {
      // reset per-tile toggles
      bluetoggle = false; victimtoggle = false; obstacle = false;
      // Read for walls
      if(VERBOSE_DEBUG) Serial.println("reading walls");
      readWallsRel(wallF, wallR, wallB, wallL); // prints the [WALLS] line
      // re-sense: does this tile actually match what the map already recorded for it?
      tilecheck = checkTileMismatch(wallF, wallR, wallB, wallL);

      delay(200);
      state = UPDATE_MAP; // next state.
      // Auto-trigger front-back centering >> only when a front wall is present, off-center beyond CENTER_TOL_MM, and the offset isn't too large (>= one tile) that the reading is unreliable. 
      // Back-wall centering isn't implemented yet, so wallB is not checked here.
      
      if(wallF == true){
        int front1 = measure(1);
        int front7 = measure(7);
        if(front1 != -1 && front7 != -1){
          double frontGap = (front1 + front7) / 2.0;
          double offset = frontGap - TARGET_GAP_MM;
          if(abs(offset) > CENTER_TOL_MM && abs(offset) < MAX_CENTER_CORRECTION_MM) state = CENTERING;
        }
      }
      
      if(Pausemaze == true){
        Serial.println("pause");
        state=PAUSE;
        break;
      }
      break;
    }
    case CENTERING: {
      if(VERBOSE_DEBUG) Serial.println("front/back centering in tile");
      centerFrontBack();
      state = UPDATE_MAP;
      if(Pausemaze == true) state = PAUSE;
      break;
    }
    case UPDATE_MAP: {
      if(VERBOSE_DEBUG) Serial.println("updating tile");
      // skip the write on a mismatch: preserve the already-trusted wall data for
      // this cell rather than overwriting it with a reading taken while the
      // robot's position belief may be wrong.
      if(!tilecheck) writeWallsToCurrentTile(wallF, wallR, wallB, wallL);
      else Serial.println("tile mismatch detected - preserving existing map data for this tile");
      updateFullyExploredAt(x_pos, y_pos);
      state = VICTIM_DETECT; // poll cameras while stopped before planning.
      if(Pausemaze == true) state = PAUSE;
      break;
    }
    case VICTIM_DETECT: {
      
      if(VERBOSE_DEBUG) Serial.println("victim detect");
      state = PLAN_NEXT;
      if(Pausemaze == true) state = PAUSE;
      break;
    }
    case PLAN_NEXT: {
      if(VERBOSE_DEBUG) Serial.println("plan next");
      plannedMoveDir = planDirection();
      plannedTurnDeg = turnNeededDeg(plannedMoveDir);
      turnCompletedForMove = false;
      if(VERBOSE_DEBUG) Serial.println(plannedTurnDeg);
      logPlan(plannedMoveDir);
      state = EXECUTE_MOVE;
      if(Pausemaze == true) state = PAUSE;
      break;
    }
    case EXECUTE_MOVE: {
      if (turnCompletedForMove == false) {
        if(plannedMoveDir != currentDir){
          ensureTurnClearance(); // a turn from too close to a wall stalls: shift away from it first
          absoluteturn(plannedTurnDeg);
        }
        delay(200);
        parallel(plannedMoveDir); // currentDir is still the old heading here
        delay(100);

        if (turnCompletedSuccessfully(plannedMoveDir) == false) {
          state = BOTCHED_TURN_RECOVERY;
          break;
        }
        currentDir = plannedMoveDir;
        turnCompletedForMove = true;
        botchedTurnAttempts = 0; // clean turn -> reset the recovery counter
      }
      MoveResult moveResult = fwd(TILE_MM);
      // A pause aborted the move before the tile was completed: don't advance
      // position or write walls/edges (the robot didn't actually traverse the tile).
      if(moveResult == MOVE_PAUSED){
        state = PAUSE;
        break;
      }
      // update map + robot position only when the robot really reached the next tile
      if(moveResult == MOVE_OK){
        softFailPending = false;
        markEdgeBothWays(x_pos, y_pos, currentDir);
        stepForward(currentDir, x_pos, y_pos); // x_pos/y_pos now = new tile
        // read blue only after the move completes, on the tile just entered
        int color = read_color();
        if(color == 1) bluetoggle = true;
        if(bluetoggle == true){
          delay(5000);
          mapGrid[x_pos][y_pos].setType(BLUE);
        }
        
        if(obstacle == true){
          //set obstacle type
          //make sure to prevent return to the tile with obstacle in the future.
          int nx = x_pos; int ny = y_pos;
          stepForward(currentDir, nx, ny);
          mapGrid[x_pos][y_pos].setObstacle(currentDir, true); // connected
          mapGrid[nx][ny].setObstacle(opposite(currentDir), true); // update both sides.
        }
        
      }
      else{
        // MOVE_BLACK: black tile ahead (marked BLACK by fwd) -> back off
        // MOVE_BLOCKED: stopped short of the next tile -> still in this one
        state = (moveResult == MOVE_BLACK) ? BACKPEDAL : BOTCHED_FWD_RECOVERY;
        turnCompletedForMove = false;
        break;
      }

      delay(200);
      parallel(currentDir);
      delay(100);
      iterator += 1;

      isVictim = false;
      turnCompletedForMove = false;
      tilecheck = false;
      state = SENSE_TILE;
      if(Pausemaze == true) state = PAUSE;
      //if(mazeTime.getTime() >= 1000000*60*6) state = RETURN;
      //if(medkits <= 0) state = RETURN;
      if(iterator >= 25 && !returning){
        returning = true;
        Serial.println("[RETURN] move limit reached, heading for the start tile");
      }
      // On the way home the robot only finishes on the start tile: every tile is planned, turned for, driven and
      // checked like in exploring (so failed turns and moves are recovered from), and it announces "back to start"
      // only when its own position says it is there.
      if(returning && x_pos == MAP_SIZE/2 && y_pos == MAP_SIZE/2 && currentFloor == 0) state = RETURN;
      break;
    }
    case BACKPEDAL: {
      plannedMoveDir = planDirection();
      if(VERBOSE_DEBUG) Serial.println("next direction picked");
      logPlan(plannedMoveDir);
      plannedTurnDeg = turnNeededDeg(plannedMoveDir);
      turnCompletedForMove = false;
      state = EXECUTE_MOVE;
      if(Pausemaze == true) state = PAUSE;
      delay(200);
      break;
    }
    case BOTCHED_TURN_RECOVERY: {
      if(Pausemaze == true){
        state = PAUSE;
        break;
      }
      botchedTurnAttempts += 1;
      Direction snappedDir = (Direction)myGyro.headingToCardinal(myGyro.heading());
      int snappedHeading = turnNeededDeg(snappedDir);
      Serial.println("botched turn detected, snapping to cardinal");
      absoluteturn(snappedHeading);
      delay(150);
      // After snapping to the nearest axis and squaring up, the robot really is on
      // snappedDir, so accept a larger gyro error here. Otherwise a gyro that is 20-40
      // degrees off would fail every turn check and loop in this state forever.
      if(squareToWall(snappedDir, PARALLEL_RECOVERY_TIMEOUT_MS)) syncHeadingToWall(snappedDir, HEADING_SYNC_RECOVERY_DEG);
      delay(100);
      currentDir = snappedDir;
      // Change the pose before the retry, retrying from the same spot fails the same way. When the sensors see room to turn and the turn
      // failed anyway, something they cannot see is in the way (an obstacle straight ahead falls between the two front sensors): back off.
      if(!ensureTurnClearance()){
        double backed = nudgeLeg(-1, pulsesForDistanceMm(BOTCH_BACKOFF_MM));
        Serial.print("[CLEAR] turn failed with room on the sensors, backed off ");
        Serial.print(backed / pulsesForDistanceMm(1.0), 0);
        Serial.println(" mm");
      }
      plannedTurnDeg = turnNeededDeg(plannedMoveDir);
      turnCompletedForMove = false;

      // Repeated failures on the same planned turn (wall, gyro drift, motor slip):
      // stop retrying it. Re-plan a fresh direction from the now-clean cardinal
      // heading instead of bouncing between EXECUTE_MOVE and recovery forever.
      if(botchedTurnAttempts >= MAX_BOTCHED_TURN_ATTEMPTS){
        Serial.println("max botched-turn retries reached, re-planning");
        botchedTurnAttempts = 0;
        state = PLAN_NEXT;
        break;
      }

      state = EXECUTE_MOVE;
      break;
    }
    case BOTCHED_FWD_RECOVERY: {
      // fwd() stopped short of the next tile (usually a wall or obstacle the wall check
      // missed) and backed off, so the robot is still in this tile. Mark the edge blocked
      // in both tiles so the planner won't drive into it again, then square up and
      // re-sense before planning.
      int nx = x_pos, ny = y_pos;
      stepForward(currentDir, nx, ny);
      // Something in the way blocks the edge at once. A move that may only have failed because of the robot's pose gets one more
      // try from a freshly squared-up pose first: the planner picks the same edge again if it is still open after re-sensing.
      bool sameEdgeAgain = softFailPending && softFailX == x_pos && softFailY == y_pos && softFailDir == currentDir;
      if(fwdSoftFail && !sameEdgeAgain){
        softFailPending = true;
        softFailX = x_pos; softFailY = y_pos; softFailDir = currentDir;
        Serial.println("[MOVE] move failed, trying that edge once more");
      }
      else{
        softFailPending = false;
        mapGrid[x_pos][y_pos].setBlocked(currentDir, true);
        if(inBounds(nx, ny)) mapGrid[nx][ny].setBlocked(opposite(currentDir), true);
        Serial.print("[MOVE] blocked edge recorded x=");
        Serial.print(x_pos);
        Serial.print(" y=");
        Serial.print(y_pos);
        Serial.print(" dir=");
        Serial.println((int)currentDir);
      }
      fwdSoftFail = false;
      absoluteturn(turnNeededDeg(currentDir)); // undo any rotation left by an obstacle detour
      delay(100);
      parallel(currentDir);
      turnCompletedForMove = false;
      state = SENSE_TILE;
      if(Pausemaze == true) state = PAUSE;
      break;
    }
    case RETURN: {
      // Only reached on the start tile, see the end of EXECUTE_MOVE. The way home is planned tile by tile in PLAN_NEXT
      // (planDirection() -> stepTowardStart()), not walked from one path computed here.
      Serial.println("[RETURN] back on the start tile");
      while(true){
        drivetrain.fullstop();
        lcdPrint("back to start");
        for(int i = 0;i<5;i++){
          digitalWrite(LEDPIN,HIGH);
          delay(1000);
          digitalWrite(LEDPIN,LOW);
          delay(1000);
        }
      }
    }
    case PAUSE: {
      drivetrain.fullstop();
      delay(200);
      if(digitalRead(logicswitch)==LOW){
        Pausemaze = false;
        // Restore the checkpoint's FLOOR as well as its tile. Save the grid we were working on back into its floor slot (m1=floor0, m2=floor1, m3=floor2), then load the checkpoint floor's grid as the active grid
        // -> so victim flags / walls are looked up on the correct floor.
        if(currentFloor == 0)      m1 = mapGrid;
        else if(currentFloor == 1) m2 = mapGrid;
        else if(currentFloor == 2) m3 = mapGrid;
        currentFloor = floor_checkpoint;
        if(currentFloor == 0)      mapGrid = m1;
        else if(currentFloor == 1) mapGrid = m2;
        else if(currentFloor == 2) mapGrid = m3;
        x_pos = x_checkpoint; y_pos = y_checkpoint; // resume from last checkpoint
        // Rule 5.5.2: after a lack of progress the robot may be put down facing any
        // direction. The gyro keeps running while it is carried and heading() is in the
        // maze frame, so snap to the nearest axis, turn onto it and square up on a wall.
        // If it was put down near 45 degrees either axis is fine: the robot turns onto the
        // one it picked and currentDir matches it. Nearest axis instead of always NORTH is
        // the same result with less turning.
        Direction facing = (Direction)myGyro.headingToCardinal(myGyro.heading());
        absoluteturn(turnNeededDeg(facing));
        delay(100);
        if(squareToWall(facing, PARALLEL_RECOVERY_TIMEOUT_MS)) syncHeadingToWall(facing, HEADING_SYNC_RECOVERY_DEG);
        currentDir = facing;
        // clear per-move state left over from the interrupted move
        turnCompletedForMove = false;
        botchedTurnAttempts = 0;
        fwdActive = false;
        isVictim = false;
        drivetrain.reset_encoderCount(true,true,true);
        steps = TURN; // reset avoidance steps
        Serial.print("[RESUME] checkpoint x=");
        Serial.print(x_checkpoint);
        Serial.print(" y=");
        Serial.print(y_checkpoint);
        Serial.print(" floor=");
        Serial.print(currentFloor);
        Serial.print(" facing=");
        Serial.println((int)currentDir);
        state = SENSE_TILE; // re-read the walls here before planning
      }
      break;
    }
 }
 
 
}
