Chrisyyyys/Robocup-Junoir-Theseus/Main/Distance.ino

// distance sensor code
// blue for SDA, yellow for SCL
// the motor shield takes up the I2C address at 0x70.

void disableAllCall() {
  // Point register to MODE1
  Wire.beginTransmission((uint8_t)PCA_ADDR);
  Wire.write((uint8_t)MODE1);
  Wire.endTransmission(false);

  // Read MODE1
  Wire.requestFrom((uint8_t)PCA_ADDR, (uint8_t)1);
  if (Wire.available() < 1) return; // couldn't read
  uint8_t mode1 = Wire.read();

  // Clear ALLCALL bit
  mode1 &= (uint8_t)~ALLCALL_BIT;

  // Write MODE1 back
  Wire.beginTransmission((uint8_t)PCA_ADDR);
  Wire.write((uint8_t)MODE1);
  Wire.write(mode1);
  Wire.endTransmission(true);
}

void init_dist() {
  
  if(!myMux.begin()){
    Serial.println("can't find the Mux");
  }
  else{
    Serial.println("Mux initialized");
  }
 
  for(int i = 0; i<7; i++){
    myMux.setPort(i);
    sensors[i].setAddress(0x30); // conflict with TCS34725 for some reason.
    delay(10);
    
    
    if(!sensors[i].init()){
    Serial.println("Sensor "+String(i)+" failed to initialize");
    }
    else{
      Serial.println("Sensor "+String(i)+" is able to initialize");
    }
    sensors[i].setTimeout(100); // a read gives up after 100 ms instead of waiting forever (library default: no timeout)
    sensors[i].startContinuous(); // start continuous ranging.
  }
    
  
  

}

uint8_t scanI2COnCurrentBus() {
  uint8_t count = 0;

  for (uint8_t addr = 1; addr < 127; addr++) {
    Wire.beginTransmission(addr);
    uint8_t err = Wire.endTransmission();

    if (err == 0) {
      Serial.print("0x");
      if (addr < 16) Serial.print("0");
      Serial.print(addr, HEX);
      Serial.print(" ");
      count++;
    }
  }
  return count;
}

void scanAllPorts() {
  for (uint8_t port = 0; port < 8; port++) {
    bool ok = myMux.setPort(port);

    Serial.print("Port ");
    Serial.print(port);
    Serial.print(ok ? ": " : ": (setPort FAILED) ");

    delay(20);

    uint8_t found = scanI2COnCurrentBus();
    if (found == 0) Serial.print("(none)");
    Serial.println();
  }
}
// measure distance
/*
int measure(int sensor){
  
  if(sensor ==1){
    myMux.setPort(2);
    int value = sensors[2].readRangeContinuousMillimeters();
    
    if (value != -1 && value != 8191) { return value;}
    else { return -1;}
      
  }
  if(sensor == 2){
    myMux.setPort(1);
    int value = sensors[1].readRangeContinuousMillimeters();
    if (value != -1 && value != 8191) { return value;}
    else { return -1;}
      
  }
  if(sensor==3){
    myMux.setPort(0);
    int value = sensors[0].readRangeContinuousMillimeters();
    if (value != -1 && value != 8191) { return value;}
    else { return -1;}
    
  }
  if(sensor==4){
    myMux.setPort(3);
    int value = sensors[3].readRangeContinuousMillimeters();
    if (value != -1 && value != 8191) { return value;}
    else { return -1;}
    
  }
  if(sensor==5){
    myMux.setPort(6);
    int value = sensors[6].readRangeContinuousMillimeters();
    if (value != -1 && value != 8191) { return value;}
    else { return -1;}
    
  }
  if(sensor==6){
    myMux.setPort(5);
    int value = sensors[5].readRangeContinuousMillimeters();
    if (value != -1 && value != 8191) { return value;}
    else { return -1;}
    
  }
  if(sensor==7){
    myMux.setPort(4);
    int value = sensors[4].readRangeContinuousMillimeters();
    if (value != -1 && value != 8191) { return value;}
    else { return -1;}
    
  }

  return -1;
}
old robot settings
*/
// Per-sensor distance offsets in mm, indexed by logical sensor number (1..7); [0] unused.
// Calibrate: place a flat matte target at a known distance D (near the ~80mm working
// range), average ~100 raw readings, set SENSOR_OFFSET_MM[n] = mean(raw) - D.
// Positive => sensor reads long; it is subtracted from every reading in measure().
// Use calibrateSensor(n, D) below to compute these values automatically.
const int SENSOR_OFFSET_MM[8] = {0, 0, 0, 0, 0, 0, 0, 0};

int measure(int sensor){
  // sensor→mux port mapping
  const int portMap[] = {-1, 1, 0, 6, 4, 5, 3, 2};
  if(sensor < 1 || sensor > 7) return -1;
  int port = portMap[sensor];
  int sensorIdx = port; // sensor index matches port number

  i2cMutex.lock();
  myMux.setPort(port);
  int value = sensors[sensorIdx].readRangeContinuousMillimeters();
  i2cMutex.unlock();

  if(value == -1 || value == 8191) return -1;          // keep the no-reading sentinel
  int corrected = value - SENSOR_OFFSET_MM[sensor];     // apply per-sensor calibration
  return (corrected < 0) ? 0 : corrected;               // clamp: negative distance is nonsense
}

// Calibration helper. Place a flat matte target at a known true distance trueDistanceMm
// (perpendicular to sensor n, ideally near the working range), then call this once from
// setup() or a serial command, e.g. calibrateSensor(2, 80). It averages RAW readings
// (offset NOT applied) and prints the recommended SENSOR_OFFSET_MM[n] value to Serial.
// Copy that number into the SENSOR_OFFSET_MM array above and reflash. Returns the
// computed offset, or -1 if the sensor never returned a valid reading.
int calibrateSensor(int sensor, int trueDistanceMm){
  const int samples = 100;
  if(sensor < 1 || sensor > 7) return -1;
  const int portMap[] = {-1, 1, 0, 6, 4, 5, 3, 2};
  int port = portMap[sensor];
  int sensorIdx = port;

  long sum = 0;
  int valid = 0;
  for(int i = 0; i < samples; i++){
    i2cMutex.lock();
    myMux.setPort(port);
    int value = sensors[sensorIdx].readRangeContinuousMillimeters();
    i2cMutex.unlock();
    if(value != -1 && value != 8191){
      sum += value;
      valid++;
    }
    delay(10); // ~let a fresh continuous-ranging sample accumulate between reads
  }

  if(valid == 0){
    Serial.print("calibrateSensor: sensor ");
    Serial.print(sensor);
    Serial.println(" returned no valid readings");
    return -1;
  }

  double meanRaw = (double)sum / valid;
  int offset = (int)lround(meanRaw - trueDistanceMm);
  Serial.print("[CAL] sensor ");
  Serial.print(sensor);
  Serial.print("  meanRaw=");
  Serial.print(meanRaw, 1);
  Serial.print("mm  true=");
  Serial.print(trueDistanceMm);
  Serial.print("mm  valid=");
  Serial.print(valid);
  Serial.print("/");
  Serial.print(samples);
  Serial.print("  -> SENSOR_OFFSET_MM[");
  Serial.print(sensor);
  Serial.print("] = ");
  Serial.println(offset);
  return offset;
}
// detects wall in a direction( 0 is north, 1 is east, etc..) If output = 0, there is a wall.
// realtive directions(local).
int detectWall(int dir){
  if(dir == 0){ // check if there is a wall at north
    int a = measure(1);
    int b = measure(7);
    // Front: up to FRONT_WALL_MAX_MM. Each move stops a little short, so after a few tiles
    // without a front wall to centre on, this tile's wall can read 130+ mm and was missed
    // with MIN_DIST (120).
    if((a<FRONT_WALL_MAX_MM&&a!=-1&&a!=8191)&&(b<FRONT_WALL_MAX_MM&&b!=-1&&b!=8191)){
      return 0; // there is a wall.
    }
    else{
      return 1; // no wall
    }
  }
  if(dir == 1){
    int a = measure(2);
    int b = measure(3);
    if((a<MIN_DIST&&a!=-1&&a!=8191)&&(b<MIN_DIST&&b!=-1&&b!=8191)){
      return 0;
    }
    else{
      return 1;
    }
  }
  if(dir == 2){
    int a = measure(4);
    if(a<MIN_DIST&&a!=-1&&a!=8191){
      return 0;
    }
    else{
      return 1;
    }
  }
  if(dir == 3){
    int a = measure(5);
    int b = measure(6);
    
    if((a<MIN_DIST&&a!=-1&&a!=8191)&&(b<MIN_DIST&&b!=-1&&b!=8191)){
      return 0;
    }
    else{
      return 1;
    }
    
  }

  return 1;
}

// Squares the robot against a side wall. Returns true only if it actually converged: the
// robot is then exactly on a maze axis, so the gyro is re-synced to `facing` (the direction
// the robot is supposed to be facing) if it already agrees within HEADING_SYNC_MAX_DEG.
bool parallel(Direction facing){
  return squareToWall(facing, 500);
}

// parallel() with an explicit time limit. The recovery paths allow longer: after a snap to
// the nearest axis the robot may have to rotate out a 20-40 degree gyro error, which takes
// more than 500 ms at PARALLEL_SPEED.
bool squareToWall(Direction facing, unsigned long timeoutMs){
  const int PARALLEL_TOL_MM = 3;
  const int PARALLEL_SPEED = 90;
  const double MAX_PARALLEL_ROTATION_DEG = 45.0;
  const int PARALLEL_MAX_WALL_MM = TILE_MM; // engage even when the wall is up to one tile away

  int sensorA = -1;
  int sensorB = -1;
  int wallDir;
  if(VERBOSE_DEBUG) Serial.println("paralleling");
  
  
  // Prefer aligning to the right wall; otherwise use left wall.
  if (detectWall(1)==0) {
    sensorA = 2;
    sensorB = 3;
    wallDir=1;
  } else if (detectWall(3)==0) {
    sensorA = 6;
    sensorB = 5;
    wallDir=3;
  } else {
    drivetrain.fullstop();
    return false;
  }

  unsigned long startMs = millis();
  double startHeading = myGyro.heading();
  bool squared = false;

  while (true) {
    // abort the correction on pause so the caller can transition to PAUSE.
    if (Pausemaze == true) { drivetrain.fullstop(); break; }
    int a = measure(sensorA);
    int b = measure(sensorB);

    // Invalid reading: stop correction to avoid runaway spinning.
    if (a < 0 || b < 0) {
      Serial.println("parallel: invalid sensor reading, aborting correction");
      break;
    }
    // If either sensor no longer sees the side wall within range, stop correcting
    // (the wall ended / robot isn't beside one) to avoid spinning on a phantom reading.
    if(a>MIN_DIST||b>MIN_DIST){
      break;
    }

    int diff = a - b;
    if (abs(diff) <= PARALLEL_TOL_MM) {
      if(VERBOSE_DEBUG) Serial.println("paralleled"); // the [SYNC] line follows
      squared = true;
      break;
    }
    // break out after rotation.

    double headingDelta = myGyro.heading() - startHeading;
    while (headingDelta > 180.0) headingDelta -= 360.0;
    while (headingDelta < -180.0) headingDelta += 360.0;

    if (abs(headingDelta) >= MAX_PARALLEL_ROTATION_DEG) {
      Serial.println("parallel: rotation limit hit, aborting correction");
      break;
    }

    if ((millis() - startMs) >= timeoutMs) {
      Serial.println("parallel: timeout, aborting correction");
      break;
    }

    // Reset wheel directions then apply correction turn.
    i2cMutex.lock();
    motorA->run(FORWARD);
    motorB->run(FORWARD);
    motorC->run(FORWARD);
    motorD->run(BACKWARD);
    if ((diff > 0 && wallDir == 1)||(diff < 0 && wallDir==3)) {
      motorB->run(BACKWARD);
      motorD->run(FORWARD);
    } else {
      motorA->run(BACKWARD);
      motorC->run(BACKWARD);
    }
    i2cMutex.unlock();
    drivetrain.drive(PARALLEL_SPEED,PARALLEL_SPEED,PARALLEL_SPEED,PARALLEL_SPEED);
    
  }
  drivetrain.reset_encoderCount(true,true,true);
  drivetrain.fullstop();
  if (squared) {
    delay(50); // let the robot stop rotating before reading the heading
    syncHeadingToWall(facing, HEADING_SYNC_MAX_DEG);
  }
  return squared;
}

// Re-zeroes the gyro against a wall the robot has just squared up to. The robot is on a
// maze axis now; if the gyro agrees with `facing` to within maxErrDeg, snap the heading to
// that axis exactly so drift can't build up. A bigger disagreement means the turn really
// went wrong (or the "wall" was an angled obstacle): leave the gyro alone and let
// turnCompletedSuccessfully() catch it. Returns true if the heading was re-synced.
bool syncHeadingToWall(Direction facing, double maxErrDeg){
  double target = turnNeededDeg(facing);
  double err = wrap180(myGyro.heading() - target);
  bool apply = fabs(err) <= maxErrDeg;
  if (apply) myGyro.setMapHeading(target);
  Serial.print("[SYNC] facing=");
  Serial.print((int)facing);
  Serial.print(" err=");
  Serial.print(err, 1);
  Serial.println(apply ? " applied" : " skipped");
  return apply;
}

// Self-centers the robot front-to-back within a tile using the front wall (avg of sensors 1+7).
// Only acts when a front wall is present (back-wall-only centering is not implemented yet)
// parallel() runs first so the robot is squared to a side wall before the front reading is trusted.

void centerFrontBack(){
  const int CENTERING_SPEED = 50;                   // mirrors PARALLEL_SPEED
  const unsigned long CENTERING_TIMEOUT_MS = 2000;
  // MAX_CENTER_CORRECTION_MM is a file-scope #define (Main.ino), shared with the SENSE_TILE trigger gate >> redundant safety abort 
  // -> in case conditions changed between the trigger check and this function actually running.

  if(VERBOSE_DEBUG) Serial.println("centering front-back (front wall)");
  parallel(currentDir);

  if(detectWall(0) != 0){ // 0 == wall present, matches detectWall's convention
    Serial.println("centerFrontBack: no front wall, nothing to center against");
    return;
  }

  int front1 = measure(1);
  int front7 = measure(7);
  if(front1 == -1 || front7 == -1){
    Serial.println("centerFrontBack: invalid initial reading, aborting");
    return;
  }

  double frontGap = (front1 + front7) / 2.0;
  double offset = frontGap - TARGET_GAP_MM; // +ve => too far from ront wall, drive forward; -ve => drive backward

  if(abs(offset) >= MAX_CENTER_CORRECTION_MM){
    Serial.println("centerFrontBack: offset exceeds sanity cap, aborting");
    return;
  }
  if(abs(offset) <= CENTER_TOL_MM){
    if(VERBOSE_DEBUG) Serial.println("already centered");
    return;
  }

  bool driveForward = offset > 0;
  unsigned long startMs = millis();

  while(true){
    // abort the correction on pause so the caller can transition to PAUSE.
    if(Pausemaze == true){ drivetrain.fullstop(); break; }
    front1 = measure(1);
    front7 = measure(7);
    if(front1 == -1 || front7 == -1){
      Serial.println("centerFrontBack: invalid sensor reading mid-correction, aborting");
      break;
    }

    frontGap = (front1 + front7) / 2.0;
    offset = frontGap - TARGET_GAP_MM;

    if(abs(offset) <= CENTER_TOL_MM){
      if(VERBOSE_DEBUG) Serial.println("centered");
      break;
    }
    // If the live offset flips sign vs. our initial decision >> overshot, stop rather than reversing (avoids oscillation).
    if((offset > 0) != driveForward){
      Serial.println("centerFrontBack: overshot target, stopping to avoid oscillation");
      break;
    }
    if((millis() - startMs) >= CENTERING_TIMEOUT_MS){
      Serial.println("centerFrontBack: timeout, aborting correction");
      break;
    }

    if(driveForward) drivetrain.fw(CENTERING_SPEED);
    else drivetrain.backward(CENTERING_SPEED);
  }

  drivetrain.fullstop();
  drivetrain.reset_encoderCount(true,true,true);
}

// Right-wall follower error, fed to center_PID in movement.ino.
// Uses the two right-side sensors (front = 2, back = 3) per Hanafi et al. (2013):
//   E_Tot = (ideal - D) + angle,  where D = avg gap, angle = back - front.
// Positive error steers away from the right wall (matches the old sign convention).
// Returns 0 when the right wall isn't present on BOTH sensors (no reliable reference).
// centerHasWall tells the caller which of the two it was: true = a real right wall, false = no reference.
bool centerHasWall = false;
int center(){
  int front = measure(2);   // right-front gap (mm)
  int back  = measure(3);   // right-back gap  (mm)
  bool wallPresent = front != -1 && front != 8191 && front <= SIDE_WALL_MAX_MM
                  && back  != -1 && back  != 8191 && back  <= SIDE_WALL_MAX_MM;
  centerHasWall = wallPresent;
  if(!wallPresent) return 0;
  double D = (front + back) / 2.0;                       // distance term
  double e = (TARGET_SIDE_GAP_MM - D) + (back - front);  // (ideal - D) + angle
  return (int)e;
}


// Called with the robot stopped: three fresh readings of both front sensors. True when the closest valid one is still
// close, so a single bad reading doesn't stop a move.
bool obstacleConfirmed(){
  int closest = 999;
  for(int i = 0; i < 3; i++){
    int fl = measure(7);
    int fr = measure(1);
    if(fl != -1 && fl < closest) closest = fl;
    if(fr != -1 && fr < closest) closest = fr;
  }
  Serial.print("[OBST] closest front reading ");
  Serial.println(closest);
  return closest < OBSTACLE_STOP_MM + 20;
}

// NOT CALLED any more. fwd() now looks for obstacles while it drives (OBSTACLE_STOP_MM), stops in front of them, backs
// off and reports MOVE_BLOCKED, so the planner takes another way, instead of starting this detour at the beginning of a
// move. It started for walls seen at an angle more often than for obstacles and left the robot rotated and displaced.
// Kept for reference; remove it once the look-ahead has been confirmed on the robot.
MoveResult obstacleavoidance(int leftright){ // leftright determines to manuver left or right.
// returns how the detour ended: MOVE_OK once the robot has driven on into the next tile
  Serial.println("obstacle avoidance");
  int _ = -1; // front distance when the detour started
  int wiggles = 0;
  const int MAX_WIGGLES = 2;
  while(true){
    // Single authoritative pause guard: gates every step boundary and transition
    // burst, not just the innermost drive loops. Reset steps so a resume after the
    // pause starts a fresh maneuver instead of re-entering mid-sequence.
    if(Pausemaze == true){
      drivetrain.fullstop();
      steps = TURN;
      return MOVE_PAUSED;
    }
    switch (steps){
      case TURN:{
        if(leftright == 1){ // obstacle at left
          _ = measure(1);
          _ = (_!=-1&&_!=8191) ? _ : -1;
          Serial.println("turn step");
          while(measure(7) < MIN_DIST){
            motorB->run(BACKWARD);
            motorD->run(FORWARD);
            drivetrain.drive(255,255,255,255);
            if(Pausemaze == true){
              drivetrain.fullstop();
              return MOVE_PAUSED;
            }
          }
          
        }
        else if(leftright == 0){ // obstacle at right
          _ = measure(7);
          _ = (_!=-1&&_!=8191) ? _ : -1;
          while(measure(1)<MIN_DIST){
            motorA->run(BACKWARD);
            motorC->run(BACKWARD);
            motorB->run(FORWARD);
            motorD->run(BACKWARD); // D is mounted reversed; BACKWARD raw = physically FORWARD, matching motorB
            drivetrain.drive(255,255,255,255);
            if(Pausemaze == true){
              drivetrain.fullstop();
              return MOVE_PAUSED;
            }
          }
          
        }
        drivetrain.fullstop();
        delay(200);
        drivetrain.fw(255);
        delay(300);
        drivetrain.fullstop();
        delay(200);
        steps = PARALLEL;
        break;
      }
      case PARALLEL:{
        PID pid(1,0,0.1);
        if(leftright == 1){
          int a = measure(2); int b = measure(3);
          while(true){
            if(Pausemaze == true){
              drivetrain.fullstop();
              return MOVE_PAUSED;
            }
            a=measure(2); b = measure(3);
            if(a<=30) break;
            if(VERBOSE_DEBUG) Serial.println("paralleling step");
            double increment = pid.getPID(a-b); // signed error: positive turns one way, negative the other
            drivetrain.drive(constrain(100+increment,50,170),constrain(100+increment,50,170),constrain(100-increment,50,170),constrain(100-increment,50,170));
            if(VERBOSE_DEBUG) Serial.println(a-b);
            
            
            if(abs(b-a)<=15){
              //fwd
              drivetrain.fullstop();
              delay(200);
              steps = FWD;
              goto end;
            }
          }
          
        }
        else if(leftright == 0){
          while(true){
            if(Pausemaze == true){
              drivetrain.fullstop();
              return MOVE_PAUSED;
            }
            int a = measure(6); int b = measure(5);
            if(a<=30) break;
            double increment = pid.getPID(a-b); // signed error: positive turns one way, negative the other
            drivetrain.drive(constrain(100-increment,50,170),constrain(100-increment,50,170),constrain(100+increment,50,170),constrain(100+increment,50,170));
            
            if(abs(a-b)<=15){
              drivetrain.fullstop();
              delay(200);
              steps = FWD;
              goto end;
            }
          }
          
        }
        Serial.println("too close, backing up");
        if(VERBOSE_DEBUG) Serial.println(measure(2));
        steps = BACKTRACK; // put switch step in front of end( always meet it)
        break;
        end:
          break;
        
      }
      case BACKTRACK:{
        Serial.println("backtracking step");
        // put a timer on to prevent it from taking too long
        timer myTime;
        if(leftright == 0){
          while(measure(6)<=40&&myTime.getTime()<800000){
            if(Pausemaze == true){
              drivetrain.fullstop();
              return MOVE_PAUSED;
            }
            drivetrain.backward(120);
          }
        }
        else if(leftright == 1){
          while(measure(2)<=40&&myTime.getTime()<800000){
            if(Pausemaze == true){
              drivetrain.fullstop();
              return MOVE_PAUSED;
            }
            drivetrain.backward(120);
          }
        }
        drivetrain.fullstop();
        delay(200);
        if(VERBOSE_DEBUG){
          Serial.println("sensor 2, now reading");
          Serial.println(measure(2));
        }
        steps = PARALLEL;
        break;
      }
      
      case FWD:{
        
        if(measure(6)<=35&&measure(2)<=35){
          // Squeezed between the obstacle and a wall: wiggle straight and retry, but give
          // up after MAX_WIGGLES so a stuck robot reports BLOCKED instead of looping.
          if(++wiggles > MAX_WIGGLES){
            Serial.println("[MOVE] obstacle detour stuck, giving up");
            steps = TURN;
            return MOVE_BLOCKED;
          }
          steps = WIGGLE;
          break;
        }
        
        Serial.println("fwd step");
        parallel(currentDir);
        drivetrain.reset_encoderCount(true,true,true);
        delay(200);
        
        // Drive the rest of the tile, subtracting distance already travelled.
        // Read the front sensor ONCE (a second read can differ and overshoot) and
        // clamp to [0, TILE_MM]: if either front reading is invalid the front is
        // open/garbage, so fall back to one tile instead of a runaway distance.
        int frontNow = measure(1);
        int travelled = (_ != -1 && frontNow != -1) ? (_ - frontNow) : 0;
        int remaining = constrain(TILE_MM - travelled, 0, TILE_MM);
        // Reset before driving on, so an obstacle met during this drive starts a fresh
        // detour instead of re-entering this step (which recursed without moving).
        steps = TURN;
        return fwd(remaining);
      }
      case WIGGLE:{
        PID pid(8,0,0.1);
        Serial.println("wiggle step");
        delay(2000);
        timer myTime;
        while(abs(measure(2)-measure(6))>=15&&myTime.getTime()<1000000){
          if(Pausemaze == true){
              drivetrain.fullstop();
              return MOVE_PAUSED;
            }
          double diff = pid.getPID(measure(2)-measure(6));
          drivetrain.drive(70+diff,70+diff,70-diff,70-diff);
        }
        drivetrain.fullstop();
        delay(200);
        steps = FWD;
        break;
      }
    }
  }
}
