Chrisyyyys/Robocup-Junoir-Theseus/Main/color.ino

void init_color(){
  //tcs.setInterrupt(true);
  myMux.setPort(TCS_PORT);
  //digitalWrite(POWERPIN,HIGH);
  //tcs.enable();
  if (tcs.begin()) {
    Serial.println("Found tcs34725 sensor");
    
  } else {
    Serial.println("No TCS34725 found ... check your connections");
    //while (1); // halt!
  }
  myMux.setPort(TCS_PORT);
  tcs.setInterrupt(true);  // turn on LED
  uint16_t r = 0, g = 0, b = 0, c = 0;

  // The TCS34725 has no valid data until one integration cycle (~24ms) after
  // enable; the first read(s) return all zeros. In the full sketch the I2C init
  // that runs before this (mux + 7 distance sensors) shifts the timing so a
  // single read sometimes lands too early -> c=0 -> clear=0 -> every later
  // (float)c/clear is inf. Retry until we get a real clear value.
  for (int i = 0; i < 10 && c == 0; i++) {
    delay(50);                 // > one 24ms integration period
    myMux.setPort(TCS_PORT);
    tcs.getRawData(&r, &g, &b, &c);
  }
  clear = (c > 0) ? c : 1;     // never store 0 -> never divide by zero
  Serial.println("clear value");
  Serial.println(clear);

}
int read_color(){
  // [DIAG-COLOR] snapshot the global `clear` divisor the instant this call starts,
  // before touching I2C at all. clear is written exactly once (init_color(), pre-thread)
  // and never reassigned anywhere else, so if this ever prints 0 here, its backing memory
  // has been clobbered by something other than this function -- not a bad sensor read.

  i2cMutex.lock();
  myMux.setPort(TCS_PORT);
  tcs.setInterrupt(true);  // turn on LED
  float red, green, blue;
  uint16_t r, g, b, c, colorTemp, lux;

  tcs.getRawData(&r, &g, &b, &c);
  i2cMutex.unlock();
  //diagnosis (runs on every fwd() loop pass, so verbose only)
  if(VERBOSE_DEBUG){
    Serial.print(r);
    Serial.print(" ");
    Serial.print(g);
    Serial.print(" ");
    Serial.print(b);
    Serial.print(" ");
    Serial.print("c=");
    Serial.print(c);
    Serial.print(" ");
    Serial.print("ratio=");
    Serial.println((float)c/clear);
  }
  
  
  //Serial.println((float)c/clear);
  if(c == 0) return 0;
  if((float)c/clear<BLACK_THRESHOLD){


    return -1; // black
  }
  
  // Silver marks the tile AHEAD, so only accept it while fwd() is in the second half of a
  // move, when the sensor is over that tile. Earlier in the move the sensor still sees the
  // tile the robot is leaving, which used to mark the wrong tile as a checkpoint.
  bool overNextTile = fwdActive && (drivetrain.encoderCountA+drivetrain.encoderCountB+drivetrain.encoderCountD)/3 > pulsesForDistanceMm(TILE_MM/2);
  if(r>SILVER_THRESHOLD && overNextTile){ // silver reflects more absolute light
    int nx = x_pos; int ny = y_pos;
    stepForward(currentDir,nx,ny);
    //Serial.print("silver at ");
    //Serial.print(nx);
    //Serial.print(", y=");
    //Serial.print(ny);
    mapGrid[nx][ny].setType(CHECKPOINT);
    x_checkpoint = nx; y_checkpoint = ny;
    floor_checkpoint = currentFloor; // remember which floor this checkpoint is on

    return 3; 
  }
  
  if((float)c/clear>WHITE_THRESHOLD) return 0;


  if(b>g+10&&b>r+10) return 1; //blue

  if(r>g+10&&r>b+10) return 2;

  return 0;

}
