Chrisyyyys/Robocup-Junoir-Theseus/docs/superpowers/specs/v3-checks/fit_R.py

"""Does the GIGA R1 + main PCB stack (and the battery) fit at body radius 9.5, 10.0 and 10.5, with the wheel track, motors, omni, chute exit and camera adjusted for each radius?
Everything that depends on R is recomputed here (the earlier giga.py sweep kept the 10.5 wheel track at every R, which pushes the wheel corners through the wall at R 9.5).
Run: python fit_R.py [R ...]"""
import json, math, random, sys
from final_check import *
from place2 import cam_points, pts_ok, hull_part
from chamfer_pack import chamfer_gap

RING, POCKET, SLOT = 3.86, 1.40, 1.45
WALL_CLEAR = 0.5            # the draft's rule: at least 5 mm between a chute and the wheel

def params_for(R):
    r_int = R - P['wall']
    y_out = min(9.0, math.sqrt((r_int - 0.1) ** 2 - 16.0))          # wheel outer face, corner of the tyre 1 mm inside the wall
    return dict(R=R, y_out=round(y_out, 2), y_in=round(y_out - 2.0, 2))

def build(R, exit_x):
    q = params_for(R)
    P['R_body'] = R; P['R_int'] = R - P['wall']; P['R_sw'] = R + 0.5; P['omni_x'] = P['R_sw'] - P['omni_r'] - 0.05
    P['arm_pivot'] = (3.5, 3.6); P['x_p'] = -2.0; P['exit_x'] = exit_x; P['r_ring'] = RING; P['pocket'] = POCKET; P['slot'] = SLOT; P['z_lid'] = 12.1
    P['wheel_yin'] = q['y_in']; P['wheel_yout'] = q['y_out']; P['motor_face_y'] = q['y_in'] - 0.9
    return fixed_parts() + plate_parts() + tof_parts() + bumper_parts(), q

def chute_wheel_gap(F):
    chutes = [f for f in F if f.name.startswith('chute')]; wheels = [f for f in F if f.name.startswith('wheel')]
    return min(c.poly.distance(w.poly) for c in chutes for w in wheels if not (w.z1 <= c.z0 or w.z0 >= c.z1))
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
