Chrisyyyys/Robocup-Junoir-Theseus/(commit log)

2025-11-28 added the tile class and distance sensors program
2025-11-30 distance sensor, pid, movement
    distance sensor code, pid.cpp and pid.h and movement with main( import modules and define variables).
2026-01-13 maze tile and sensor management
2026-01-15 fix maze tile class
    fixe mazetile class
    [Main.ino, MazeTile.h]
2026-01-17 1/17/2026 version
    Added timer class, fixed PID for turning left.
    [Main.ino, PID.cpp, color.ino, movement.ino, timer.cpp, timer.h, uart_camera_comms.ino]
2026-01-29 1/29/2025
    created gyro class
    created absolute turning.
2026-01-30 1/30/2026
    removed turn(), fixed absoluteturn(), parallel works, fixed maze code( writeWallsToCurrentTile should write boolean into absolute direction, not robot direction).
    [Distance.ino, Main.ino, gyro.cpp, gyro.h, movement.ino, navigation.ino]
2026-02-02 2/2/2026 version.
    update currentDir in loop.
2026-02-04 2/4/2026 version
    error free version, minor bug fixes.
    [Main.ino, movement.ino, navigation.ino]
2026-02-06 Fix wall detection logic and add safe fallback returns
    [Distance.ino, uart_camera_comms.ino]
2026-02-06 Fix turning degrees by using relative heading delta
    [Main.ino, movement.ino, navigation.ino]
2026-02-08 2/8/2026 version
    tested navigation, color sensors has issues.
    [Distance.ino, Main.ino, color.ino, gyro.cpp, movement.ino, navigation.ino]
2026-02-17 2/16/2026 version
    added obstacle avoidance( need to tune).
    [Distance.ino, Main.ino, movement.ino, uart_camera_comms.ino]
2026-02-18 2/18/2026 version
    added bluetoggle to prevent infinite repetition
    [Main.ino, movement.ino]
2026-02-20 2/19/2026
    fixed up color detection logic in fwd
    [Distance.ino, Main.ino, color.ino, gyro.cpp, gyro.h, movement.ino]
2026-02-20 Prevent runaway rotation during wall parallel correction
    [Distance.ino]
2026-02-21 2/21/2026 version
    added slope climbing( encoders stop while climbing) and camera detection in autonomous logic.
2026-02-21 fixed 2/21/2026
    minor bug fix
    [Distance.ino, movement.ino]
2026-02-24 2/24/2026
    fixed yaw, climbing, camera detection.
    [Main.ino, gyro.cpp, movement.ino, uart_camera_comms.ino]
2026-02-24 gyro fix,
2026-02-25 2/25/2026 version 2
    added centering, fixed some bugs.
    [Distance.ino, Main.ino, movement.ino, uart_camera_comms.ino]
2026-02-27 color fix
    sped up color detection.
    [color.ino, movement.ino]
2026-03-10 arduino apropriate bfs + sdispenser.h
    If sdispenser has problems on your computer remove it.
    [Main.ino, dispenser.cpp, dispenser.h, navigation.ino, uart_camera_comms.ino]
2026-03-11 3/11/2026 change
    fixed black tile mapping
    [Main.ino, MazeTile.h, movement.ino, navigation.ino]
2026-03-11 added logical switch
    semicolon error somewhere.
    [Main.ino, color.ino, movement.ino, navigation.ino]
2026-03-12 BFS Nav Fix??
    Previously did not change path in BFS
    [navigation.ino]
2026-03-29 error correction
    sometimes the robot bumps into the edges of walls so I made some error correction(Untuned).
    [Main.ino, gyro.cpp, gyro.h, movement.ino, navigation.ino]
2026-03-29 Revert "Merge branch 'main' of https://github.com/Chrisyyyys/Robocup-Junoir-Theseus"
    This reverts commit 71280ebe6e5e8d4036eaf309cab1514aa14a3d59, reversing
    changes made to ae289817341c0068437226e70c8d9f5ea1afc2b8.
    [Distance.ino, Main.ino, MazeTile.h, PID.cpp, PID.h, color.ino, dispenser.cpp, dispenser.h]
2026-03-29 Reapply "Merge branch 'main' of https://github.com/Chrisyyyys/Robocup-Junoir-Theseus"
    This reverts commit fa9d34e3450b9fc6e4359a113e77ba92728f73ff.
    [Distance.ino, Main.ino, MazeTile.h, PID.cpp, PID.h, color.ino, dispenser.cpp, dispenser.h]
2026-03-30 Add botched-turn recovery state and avoid blue tiles in next-step picking
    [Main.ino, navigation.ino]
2026-03-30 3/29/2026 version
    tried some self correcting code for certain situations.
    maybe using distance sensors is a better idea to prevent collisions with the edge of the walls.
    gave up on detecting while moving
    [Main.ino, gyro.cpp, gyro.h, movement.ino]
2026-03-31 Handle stair-stall events in map and path planning
    [Main.ino, movement.ino, navigation.ino]
2026-04-04 movement class
    not working
    [Main.ino, motors.cpp, motors.h, movement.ino, navigation.ino, uart_camera_comms.ino]
2026-04-14 motors class
    the motors(drivetrain) class is fully implemented without errors.
    [Distance.ino, Main.ino, motors.cpp, motors.h, movement.ino, uart_camera_comms.ino]
2026-04-30 Added 3rd dimension; incomplete
    reallocation & bfs need to be fixed (navigation), as well as anything else where mapGrid is called (Main, ??)
    Added TOP/BOTTOM to d
    Added Elevation/Descension to bitset
    Elevation for when the robot goes up,
    descension for when robot goes down
    [Main.ino, MazeTile.h, navigation.ino]
2026-05-02 Revert "Added 3rd dimension; incomplete"
    This reverts commit 84a3eb9efab06090c8ee0a79f012caedb11463a4.
    [Main.ino, MazeTile.h, navigation.ino]
2026-05-28 correct distance sensor layout
    [Distance.ino]
2026-06-15 6/15/2026 multicore_debug
    added i2c mutex to prevent conflict between color sensor and distance sensor.
    other minor fixes.
    [Distance.ino, M4_main.ino, M7_main.ino, color.ino, movement.ino]
2026-06-15 corrected encoder pins
2026-06-16 temporary bug fix version
    [Distance.ino, M4_main.ino, M7_main.ino, color.ino, gyro.cpp, gyro.h]
2026-06-20 6/20/2026 version
    bfs doesn't freeze up immediately
    - fixed floor level indexing
    - added elevation to forward
    - fixed modulus
    [Distance.ino, Main.ino, color.ino, gyro.cpp, movement.ino, navigation.ino, uart_camera_comms.ino]
2026-06-24 6/24/2026 bug fix
    fixed edge-case conflicts between state VICTIM_DETECT and camera thread
    [Main.ino, movement.ino, navigation.ino, uart_camera_comms.ino]
2026-06-25 claude bfs ver 6/24/2026
    BFS had a stack explosion issue - resolved
    added botchedfwd state
    [Main.ino, movement.ino, navigation.ino]
2026-06-26 6/25/2026
    got rid of victim_detect state( tile object reading conflict with thread)
    Got obstacleavoidance working
2026-07-02 calibrated color values
2026-07-02 Revert "Merge branch 'main' of https://github.com/Chrisyyyys/Robocup-Junoir-Theseus"
    This reverts commit 0831f661ed3a054fab6835926d03719b326c6a7d, reversing
    changes made to 7c72b825c0b5fa4bc8e923b51c15db561d710651.
    [Main.ino, color.ino, movement.ino]
2026-07-02 Reapply "Merge branch 'main' of https://github.com/Chrisyyyys/Robocup-Junoir-Theseus"
    This reverts commit d780544f07f34e17ced115f9d948fb0aa2cb6a86.
    [movement.ino]
2026-07-02 added pausing in obstacle avoidance
    [Main.ino, navigation.ino]
2026-07-03 7/3/2026 version
    -added moveInterrupted( prevent lack of progress tile desyncs.
    -let center() center based on mod( can center regardless of distance from walls)
    [Distance.ino, Main.ino, color.ino, movement.ino]
2026-07-04 Port pause handling, botched-turn cap, tile mismatch, obstacle clamp
    - parallel()/centerFrontBack(): abort correction loop on Pausemaze so the
    caller can transition to PAUSE.
    - BOTCHED_TURN_RECOVERY: cap retries with MAX_BOTCHED_TURN_ATTEMPTS and
    re-plan instead of cycling forever; reset the counter on a clean turn.
    - checkTileMismatch(): re-sense guard that preserves trusted map data when
    the freshly-sensed walls disagree with the stored tile (marked FIXME).
    - obstacleavoidance(): read the front sensor once and clamp the remaining
    travel to [0, TILE_MM] to avoid runaway distances.
    [Distance.ino, Main.ino, navigation.ino]
2026-07-04 sensor calibration
2026-09-25 Measure heading from the run start instead of magnetic north
    bno.begin() with no argument ran the BNO055 in NDOF mode, where heading 0 is
    magnetic north and the reading is bent by motors and metal on the field. The
    turn code assumes gyro 0 is maze NORTH, so every turn landed off the walls
    unless the field happened to face magnetic north.
    Run the BNO055 in IMUPLUS (gyro + accelerometer only) and keep a software
    offset: heading() now returns the maze-frame heading, rawHeading() the sensor
    value, and setMapHeading() re-zeroes it. All existing callers already go
    through heading(), so they switch to the maze frame without other changes.
    Cl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
    [gyro.cpp, gyro.h]
2026-09-25 Make absoluteturn() stop at its target and correct overshoot
    The old loop only ended on pause or timeout (2 s per 90 degrees):
    TURN_TOL_DEG was never used, the speed came from |error| and the direction
    never changed, so the motors kept pushing past the target and an overshoot
    was driven further the wrong way.
    Now the direction is re-chosen every tick from the signed error, the motors
    stop inside 3 degrees, and the turn returns true once the heading has stayed
    there for 60 ms. The timeout is only a safety net and no longer counts time
    spent servicing a victim. Each turn logs its final error, duration and
    result on a "[TURN] done" line. TURN_MIN_PWM (45) needs bench tuning: it
    should be the l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
    [movement.ino]
2026-09-25 Re-sync the gyro whenever the robot squares up on a wall
    parallel() squared the robot against a side wall but never told the gyro,
    so gyro error built up silently. Once it passed 20 degrees, every move went:
    turn to the gyro angle, square up on the wall, fail the turn check, recover,
    repeat, and a LoP resume turned to the same wrong heading.
    parallel() now takes the direction the robot should be facing and returns
    whether it actually converged. When it did, syncHeadingToWall() snaps the
    heading to that axis if the gyro already agrees within 20 degrees (the turn
    check's tolerance); a bigger disagreement is left for the turn check to
    catch. BOTCHED_TURN_RECOVERY, which first snaps to the near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
    [Distance.ino, Main.ino]
2026-09-25 Sense the tile before planning at run start and after a LoP
    Resuming from PAUSE went straight to PLAN_NEXT, and starting a run with the
    logic switch went through the same path, so the start tile's walls were
    never read: they stayed "open" from initializeMap() and the first move was
    always forward, into a wall if there was one.
    - New WAIT_START state: motors off until the logic switch goes PAUSE -> RUN
    (so a robot powered up at RUN doesn't drive off). On start it zeroes the
    heading, squares up on a side wall, defines that as maze NORTH and goes to
    SENSE_TILE. It prints "[WAIT]" heading readouts for bench checks.
    - PAUSE is now LoP-only. On resume it snaps to the nearest axis of the
    m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
    [Main.ino]
2026-09-25 Only advance the map position when a move really reached the next tile
    fwd() gave no result: the front emergency stop just left the loop, and
    EXECUTE_MOVE marked the edge travelled and stepped the position forward
    anyway. A missed wall turned into a phantom move and shifted the map by a
    tile. BOTCHED_FWD_RECOVERY existed but was never used.
    - fwd() returns MOVE_OK / MOVE_BLOCKED / MOVE_BLACK / MOVE_PAUSED through a
    single exit (the obstacle returns used to skip fwdActive = false and the
    encoder reset). It zeroes the encoders when it starts.
    - Emergency stop before half a tile (and without a ramp climb): reverse to
    the move's start and return MOVE_BLOCKED. Past halfway the move counts.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
    [Distance.ino, Main.ino, MazeTile.h, movement.ino, navigation.ino]
2026-09-25 Give turn recovery and LoP resume more time to square up
    The wider re-sync window in BOTCHED_TURN_RECOVERY and the LoP resume only
    helps if parallel() actually squares the robot, and parallel() gave up after
    500 ms at a fixed speed of 90. Rotating out a 20-40 degree gyro error likely
    takes longer, so the recovery loop could still come back.
    Move parallel()'s body into squareToWall(facing, timeoutMs). parallel() keeps
    the 500 ms limit for normal calls, where hunting around the tolerance should
    stay short. The two recovery paths use PARALLEL_RECOVERY_TIMEOUT_MS (1500 ms).
    The 45 degree rotation limit still applies.
    Claude-Session: https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
    [Distance.ino, Main.ino]
2026-09-25 Add a test plan for the heading and move fixes
    Bench and field tests for each fix on this branch (turn tuning, magnet
    immunity, gyro re-sync with an injected error, start/resume, blocked moves)
    with the log lines to watch, pass criteria, and the known gaps that are not
    fixed here.
    Claude-Session: https://claude.ai/code/session_01Pc96NajDxPKYwpPj3XV2P1
2026-10-01 Quiet the serial log for testing behind VERBOSE_DEBUG
    The drive loop printed distance, colour and raw RGB on every pass (plus
    [CENTER] every fifth pass, ramp and detour traces, camera samples), which
    buried the handful of lines the test plan reads.
    - New VERBOSE_DEBUG switch in Main.ino (default 0). The per-loop and
    per-move traces are wrapped in if(VERBOSE_DEBUG), not deleted: set it to 1
    to get them back. The diagnostic-only sensor reads inside them are skipped
    too.
    - Wall reading is one tagged line: [WALLS] F=1 R=0 B=1 L=0.
    - Each planning decision prints [PLAN] x/y/floor/facing/next (also after a
    black-tile back-off), so a test can see whether the position advanced.
    - The turn c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
    [Distance.ino, Main.ino, color.ino, movement.ino, navigation.ino, uart_camera_comms.ino]
2026-10-02 Add maze simulator that runs the robot code unchanged
    The simulator compiles the sketch in Main/ for a PC and answers every
    hardware call (VL53L0X sensors behind the mux, BNO055, TCS34725, motor
    shield, encoders, camera UARTs, pause switch, LED, LCD) from a simulated
    robot driving through a simulated RoboCupJunior Rescue Maze.
    - sim/sim.py: build, run, batch (with report), gen (random RCJ-style
    mazes: walls / basic / full profiles), view
    - deterministic virtual-time scheduler for the RTOS threads (camera and
    pause threads run with their real priorities)
    - robot model: deadband, motor lag, skid steering, slip, collisions,
    ramps, bumps, stairs, debris; signal-weighted ToF cone model
    - e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
    [robot.cfg]
2026-10-02 Add simulator findings, suggested fixes and stack checks
    - FINDINGS.md: what the simulator found in the robot code (start-up
    freeze, fwd/obstacleavoidance recursion, early-stopped moves counted
    as tiles, short moves and missed front walls, checkpoint marked on the
    wrong tile, ramps of 20 degrees or less not detected, and more), with
    before/after numbers on the same mazes
    - examples/suggested-fixes.patch: the changes measured in FINDINGS.md
    (Main/ itself is unchanged)
    - batch reports name a likely cause for the first wrong position
    - per-thread stack use is tracked and flagged when far above the GIGA's
    - --sketch builds in its own folder so another copy of the code can be
    compared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
    [robot.cfg]
2026-10-02 Replay viewer: compare several runs on one page
    sim.py view accepts several traces (--labels, --note) and builds one page
    with a switch between them, e.g. the current code and a changed copy on
    the same maze. --artifact writes the page body only.
    Claude-Session: https://claude.ai/code/session_01CiDp4U3UzZ1fhY2VbYUzXK
2026-10-02 Simulator: run newer versions of the robot code
    - the probe only reads globals the sketch declares (sketch.py detects
    them), so versions without e.g. blacktoggle still build
    - flip the logic switch PAUSE -> RUN after setup() when the code waits
    for it in a WAIT_START state (sim.start_switch = auto|on|off)
    - BNO055 stub: operation modes at global scope like the current
    Adafruit library (OPERATION_MODE_IMUPLUS)
    - viewer shows edges the robot marked as blocked
    - likely-cause heuristic understands the [PLAN]/[MOVE] log lines
    Results for the code on main are unchanged.
    Claude-Session: https://claude.ai/code/session_01CiDp4U3UzZ1fhY2V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
    [robot.cfg]
2026-10-02 Fix start-up freeze, missing return and wrong checkpoint tiles
    - setup(): calibrateSensor(2,80) read sensor 2 before init_dist() had
    started it; after a cold power-on that read waited forever because no
    timeout was set. It now runs after init_dist() (left commented out,
    its result is unused) and every sensor gets setTimeout(100).
    - timer::reset_delta_time() is declared double but returned nothing,
    which is undefined behaviour and crashes fwd() with newer compilers.
    - read_color() marked the tile ahead as a checkpoint whenever it saw
    silver, including at the start of a move off a checkpoint while the
    sensor is still over it. It now only accepts silver in the second half
    of a mov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
    [Distance.ino, Main.ino, color.ino, timer.cpp]
2026-10-02 Detect the front wall up to 200 mm and limit wall-follower steering
    Tuning changes, to be checked on the robot:
    - detectWall(0) now reports a front wall up to FRONT_WALL_MAX_MM (200).
    Moves stop about 12 mm short (fwd() exits at PWM 25) plus wheel slip,
    and without a front wall to centre on this adds up. After a few tiles
    this tile's front wall read 130+ mm and was missed with MIN_DIST (120).
    A wall in the current tile is never further than ~200 mm; the next
    tile's wall is at least 360 mm away. CENTERING then also re-centres.
    - The right-wall follower's correction is limited to +-40. Unlimited,
    being 30 mm off-centre already gave one side PWM 150 and the other 20.
    Measured with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
    [Distance.ino, Main.ino, movement.ino]
2026-10-02 Update the test plan for the added fixes
    #2 (checkpoint tile) is fixed now, so it is no longer listed as a known
    gap. New section 7 has bench tests for the start-up freeze, the
    checkpoint tile, the 200 mm front-wall range and the wall-follower
    steering limit.
    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
2026-10-02 Simulator: new random mazes on every run unless a seed is given
    - run, batch and gen pick a new seed when none is given (before, the
    default was always seed 1, so every batch tested the same mazes)
    - the seed is printed with the results and in the batch reports, with
    how to repeat a run (--seed) or a whole batch (--seed-start)
    - CI: the three batches that are compared between commits now pin
    --seed-start 1 (same results as before); a fourth batch tests 20 new
    random mazes on every push
    - README and FINDINGS: commands that compare code versions pass
    --seed-start
    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
2026-10-02 Simulator docs: say which findings are fixed now that main has them
    - FINDINGS: main includes claude/practical-brahmagupta-y7saan since
    b1acd52; the results table gets a column for main now, and the older
    columns are re-measured with the current simulator (victims found
    57% / 62% instead of 55% / 61%; nothing else changed)
    - how to run the older code (git archive 423e4e6) to see the fixed
    findings, since the patch only applies to that code
    - README: the "try a change on a copy" example no longer uses the
    patch, which does not apply to the current Main/
    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
2026-10-04 Simulator: model the V2 robot from its CAD and the 2026 rules
    Robot (sim/config/robot.cfg, new sim/tools/cad_sensors.py): the geometry comes
    from the Fusion archive V2.f3z in github.com/Arsur24/Theseus instead of guesses:
    195 x 180 mm over the wheels (the plates are 138 mm wide, the wheels and side
    sensor tabs reach +-90.2 mm), front pair at +-80 mm on the front face, side
    sensors flush with the wheels, back sensor on the back face, each with its
    window height. cad_sensors.py reads the archive (zstd + ASM binary bodies) and
    prints the plates, wheels and VL53L0X mounting-hole patterns, so the numbers
    can be derived again after a CAD change. It is the CAD, not the robot: which
    end is the front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
    [robot.cfg]
2026-10-04 Robot: fit turns to the V2 body, look for obstacles while driving, plan the way home
    Found with the maze simulator (sim/FINDINGS.md, docs/superpowers/specs/). The V2
    robot is 195 x 180 mm; a turn in place swings its corners round a 133 mm circle
    and the 28 cm path leaves 7 mm of room on each side, so almost every turn stalled
    against a wall (3 turns in 5 failed their check) and 106 of 120 explore runs
    needed a lack-of-progress restart. With these changes (and the camera-thread
    commit that follows): restarts per 120 explore mazes 274 -> 1,
    runs that lost their position 13 -> 5, wall contacts per run 41 -> 3, estimated
    score 106 -> 182; full field 341 -> 9 restarts, score 92 -> 161.
    Turns and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
    [Distance.ino, Main.ino, movement.ino, navigation.ino]
2026-10-04 Robot: stop the wheels before the camera thread services a victim
    The I2C fix, on its own so that it can be left out: reverting this commit undoes it.
    It is in because the simulator shows the other robot changes are not safe without
    it (numbers below).
    The camera thread runs serviceCameraVictim() (reading the camera, 5 s of LED
    blinking, LCD, kit dispenser) with the I2C mutex held for 5-9 s, and every motor,
    gyro, distance and colour access takes the same mutex, a stop command included. The
    camera thread used to stop the drivetrain, raise victimPending, sleep 10 ms and then
    take the mutex. The movement loop takes about 30 ms per pass: when it was already
    past its victimPending check it stil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
    [Main.ino, movement.ino]
2026-10-04 Docs: design note, test plan and V2 results for the pose and obstacle fixes
    New, in docs/superpowers/specs/:
    - 2026-10-02-pose-and-obstacle-fixes-design.md: why the robot loses its position
    and why obstacle avoidance seemed not to work, the seven changes, what was tried
    and not adopted, what is still open, the constants to calibrate.
    - 2026-10-02-pose-and-obstacle-fixes-test-plan.md: how to check each change on the
    robot, with pass criteria and the original behaviour as baseline. Step 0 is to
    compare the V2 numbers with the real robot.
    - 2026-10-04-v2-robot-and-2026-rules.md: the V2 geometry read from the CAD, the
    2026 rules in the simulator, results on 360 mazes per kind (original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
    [robot.cfg]
2026-10-05 Scenario and docs: say that an obstacle against a far wall is not fixed yet
    The docs said that toeing the front pair in by 15 degrees (or a third sensor) would
    remove the blind zone for a cylinder straight ahead against a far wall. Run on the
    dead-end scenario, toeing in does not. Final code, obstacle_dead_ahead, seeds 1-3,
    150 s (contacts per seed):
    as drawn 9, 9, 15 position wrong at 10/13, 10/13, 5/8 arrivals
    front pair toed in 15 deg 14, 7, 6
    OBSTACLE_STOP_MM 100 7, 10, 15
    toed in and 100 9, 11, 4
    toed in and 150 0, 6, 4 (stops in front of it in seed 1 only)
    The original code touches it 4, 3 and 18 times. In the pooled te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
2026-10-08 Docs: Theseus V3 rev 4 design, Fusion layout model, checks and chute finding
    Adds docs/superpowers (all new files):
    - specs: the rev 3 robot design, the rev 4 mechanical design (structure, mounting,
    usability), the pre-Fusion report, v3-checks (geometry and statics scripts with
    results, figures 7 to 9) and v3-figures
    - plans: the rev 4 Fusion rebuild plan and its execution ledger
    - v3-fusion: the rev 4 layout model built by script in Autodesk Fusion (51 components,
    19 stages, probes and 11 whole-model reports, all passing), its export
    Theseus_V3_rev4.f3d, views, raw results, a geometry emulator that dry-runs the
    plan, and three extra Fusion checks (native interference, loose parts,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
    [Theseus_V3_baseline.f3d, Theseus_V3_rev4.f3d]
2026-10-09 Theseus V3: chute redesign after the kit simulation, plate-model simulation, independent review fixes
    The first rev 4 chute (14.5 mm slot, 13 mm bore, trough cut flat at z 7.7) jammed kits in a MuJoCo
    simulation. Redesign: 16 mm slot and hopper void, 22 mm hopper, 18 mm square bore centred 1 mm above
    the axis, open trough with a 2.8 cm floor slab, hopper socket tool 8 mm taller than the channel (no loose
    lintel: Fusion had split each hopper in two), cut at z 8.7 so the channel stays out of the dropper floor.
    An independent review of the redesign found the plate missing from the simulation, shared poses, a notch
    in the channel floor, an overstated "any attitude" claim, a vacuous turning-room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
    [Theseus_V3_rev4.f3d]
2026-10-10 Theseus V3: 9-10 Oct revisions: chute reliability, real sensor boards, omni mount, omni arm drawing and spring order sheet
    9 Oct
    - Chute numbers picked for reliability (13 mm pockets, 17 mm slot and hopper void, 19 mm bore): the
    MuJoCo kit simulation takes 100 % of 1000 kits out with the plate parked up to 1 mm off, so the
    dropper has to park within +-1.5 mm (D21, D22).
    - ToF boards: the real Adafruit 3317 (25.4 x 17.8 mm) standing in pockets of a ring 5 mm taller
    (top z 11.7). Cameras: the real OpenMV board on printed cages under lid humps (lens block still an
    estimate). Front floor port (20.3 mm TCS34725) and BNO055 IMU placed.
    - Omni wheel mount: the real Nexus 14145 (60 x 25.6 mm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
    [Theseus_V3_rev4.f3d, omni_arm.dxf]
